eSpark-Consulting-Group/ajeet-singh-hdmi-to-fpc-adaptor/Docs/HDMI-PI-main(Ref Design)/4.Docs/东芝方案/TC358870XBG资料/代码生成配置脚本.xlsm

Sheet: Revison
Revison | HowToUse |  | Main_Parameters |  | EDID |  | Source_Startup |  | Source_CabCnct |  | Source_ColorBar |  | Source_HDMITimChk |  | Code
 | Rev | Note | Rev | Note | Rev | Note | Rev | Note | Rev | Note | Rev | Note | Rev | Note | Rev | Note
Tv01 | v01 | 1st Edition | v01 | 1st Edition | v01 | 1st Edition | v01 | 1st Edition |  |  |  |  |  |  | v01 | 1st Edition
Tv02 | v02 | Modify 4.5 |  |  | v02 | Modify K column judgement | v02 | Modify delay command expression.
 |  |  |  |  |  | Add conditional cell color painting to J column
Tv03 |  |  | v02 | Modify D22, H22 Formulas |  |  | v03 | Delete line 374,375
 |  |  |  | Modify D21, H21
 |  |  |  | Modify D59~D64,E59~E64,P59~P64,Q59~Q64
Tv04 | v03 | Add explanation of Color Bar. | v03 | Add B115, M115 | v03 | Add formula to support new resolution | v04 | Move 0x02A0,0x02AC,0x04A0,0x04AC setting earlier |  |  | v01 | 1st Edition | v01 | 1st Edition
 |  | Modify Typo. |  | Modify B114, M114 |  |  |  | Move 0x0110,0x0310 to command TX part.
 |  |  |  | Modify D62~D63,E62~E63,P62~P63,Q62~Q63 |  |  |  | Modiy 0x0128,0x0328 bit set part.
 |  |  |  | Add G64,S64 |  |  |  | Modify CMD part of 0x8671 and 0x8675
 |  |  |  | Change to fixed value (C60,O60)
 |  |  |  | Add new resolution to B20, S3~S10
 |  |  |  | Modify formula for 0x0370
Tv05 |  |  | v04 | Modify calculation formula for 0x0170 and 0x0370. |  |  | v05 | Modify 0x021C,0x041C setting. |  |  | v02 | Change reference point of 0x0170 and 0x0370.
 |  |  |  | Use different value for 0x0170,0x0370 between HDMI input and Color Bar. |  |  |  | Change DDC_5V interrupt related part. |  |  |  | Modify 0x021C,0x041C setting.
Tv06 | v04 | Add explanation of "Source_HDMITimChk" sheet. |  |  |  |  | v06 | Change 0x0128,0x0328 value | v01 | 1st Edition | v03 | Change 0x0128,0x0328 value
 |  |  |  |  |  |  |  | Change to fixed value for 0x0128,0x0328<bit1> |  |  |  | Change to fixed value for 0x0128,0x0328<bit1>
 |  |  |  |  |  |  |  | Change 0x8410 value
Tv07 | v05 | Modify cell number related with Signal Soure setting. | v05 | Move Signal Source input cell and color bar kind input cell position. |  |  | v07 | Delete 0x5008,0x5088 setting | v02 | Add sequence. Add flow chart |  |  | v02 | Add HDMI VSYNC,HSYNC polarity status | v02 | Macro names are changed.
 |  |  |  | Delete M25
 |  |  |  | Add conditonal cell color change to M23,M24.

Sheet: HowToUse
 | v05
<HDMI Input>
1 | Select "Main_Parameters" sheet.
2 | Fill parameters to yellow colored cells
 | 2-1 | Select DSI output source by C29. Select "HDMI".
 | 2-2 | Fill HDMI related paramters at "HDMI Input" part.
 |  | 2-1-1 | HDMI input timing can be selected by cell B20. If other timings which are not listed in the cell is needed, select "Original" and fill timigns to cell C19~K19,L20,L21,M23,M24,M25.
 | 2-3 | Select "DSI Output Format" by C45. Select DSI mode by D45.
 | 2-4 | Set split mode.
 |  | 2-4-1 | Split mode "enable"/"disable" is set by F40 and H40 for DSI-TX0 and DSI-TX1 each. When "disabled", HDMI input goes to both DSI-TX0 and DSI-TX1 without splitting.
 |  | 2-4-2 | Split mode is set by C42. "Half(Auto)" mode will divide H active pixel from HDMI into half automatically and input to DSI-TX0 and DSI-TX1 each. When "Manual" mode is selected by C42, H active pixel for DSI-TX0 is set by E42 and E45. G42 and G45 are used to set H active pixel for DSI-TX1. 1st pixel of HDMI is pixel "1". H active pixel for DSI-TX0 and DSI-TX1 is shown in E47 and G47 each. For both "Half(Auto)" and "Manual" mode, dummy pixels can be added at the begingig and at the end of active pixel. Dummy pixel for DSI-TX0 is set by F42 and F45 and by H42 and H45 for DSI-TX1. Pixels including dummy pixels need to be sent through DSI-TX0 and DSI-TX1 are shown in F47 and H47 each.
 | 2-5 | Fill "DSI Output Detail Timing" part
 |  | 2-5-1 | Different timing parameters can be set for DSI-TX0 and DSI-TX1. If same timing parameters is OK and the timing can meet timing requirement, set O50 as "Same as TX0". For this case, same parameters are used for DSI-TX0 and DSI-TX1. Only setting parameters to DSI-TX0 side is OK. If different timing parameters are required, DSI-TX1 side parameters must be set independently. Following explanation assumes a case that same timing parameters are used.
 |  | 2-5-2 | Set REFCLK frequency to C72 and set DSI lane to C78.
 |  | 2-5-3 | Suitable DSI speed is listed in J79,J80. Please adjust DSI speed referring to these values. J79:reference DSI speed when keeping same HPW+HBP time period as HDMI input. J80:reference DSI speed when no HPW+HBP time period is inserted. To get DSI speed frequency, set Pre Divider value which decides unit clock (E74). Lower frequency is better. Pre divided value (I73) should be within spec(min)(J73) and spec(max)(K73). Select DSI speed range (C74) according to J79 and J80. DSI speed is calculated by Unit Clock(E74) * Multiply value(C75). DSI speed should be within spec(min)(J77) and spec(max)(K77). Adjust LP<->HS transition time paramters (C85~C105) for Judge column (E*) to be "OK". As paramters at C column increase, calculated value (I column) will also increasae. When the calculated value becomes within spec (J column and H column), judge (E column) will be "OK". For C column parameters, please select relatively small value which can be "OK".
 |  | 2-5-4 | Horizontal related porch timing on DSI is set by D60,D61,E60,D61 for DSI-TX0 and P60,P61,Q60,Q61 for DSI-TX1. When DSI output is Sync Event Mode, only E60,E61 and Q60,Q61 are used and all is used for Sync Pulse Mode. E60(Q60) are used to set porch setting mode for Sync Event Mode and D60,E60(P60,Q60) are used to set porch setting mode for Sync Pulse Mode. "Follow input" means that corresponding porch time period of DSI becomes almost the same as HDMI input porch timing. By using "Set", user can set porch value (HPW+HBP) on DSI side freely. Porch value is set by E61(Q61) for Sync Event Mode (HPW+HBP), set by D61,E61(P61,Q61) for Sync Pulse Mode(HPW, HBP). Recommended mode is "Set". Porch time period in "ns" unit is shown in E63(Q63) for Sync Event Mode (HPW+HBP),shown in D63,E63(P63,Q63) for Sync Pulse Mode(HPW, HBP). Also shown in "ByteClock" unit below "ns" unit. Please adjust porch value referring to these time.
 |  | 2-5-5 | When G63(S63) is "NG", DSI cannot output all the data within 1line. Please adjust parameters according to ERROR message shown in B4~B9.
 | 2-6 | Fill Audio Related parameters according to required configuration. (Columns M,N,O, Row 2~6).
 | 2-7 | Fill EDID related parameters according to capability of receivable resolution/frame rate/Timng. EDID data includes 1st and 2nd descriptors for recommended display timing. Extra descriptors 3rd ~ 7th are enabled by R5. There are 2 ways of setting for EDID. One is to select from predefiend value. another is setting by user. By setting S3~S10, user can select which method to use. When "Original" is selected, timing parameters set into C20~K20,L21,M23,M24 are used as EDID data. When "New" is selected, timing data written into corresponding cells in "EDID" sheet is used as EDID data.
 | 2-8 | Select "EDID" sheet. Fill EDID data in yellow colored cells if needed.
3 | Select "Source_*" sheet. Fill orange colored cells if needed.
4 | Command transmission to DSI-RX should be filled in "Command Transmission Before Video Start" and/or "Command Transmission After Video Start.
5 | Setting seuqnece is automatically calculated and listed in B, D, E columns at "Source_*" sheet. C column is Command. D column is Address, E column is Data.
<Embedded Color Bar Output>
1 | Select "Main_Parameters" sheet.
2 | Fill parameters to yellow colored cells
 | 2-1 | Select DSI output source by C29. Select "Color Bar". Color Bar mode can be set by D29.
 | 2-2 | Fill Color Bar size related paramters using "HDMI Input" part.
 |  | 2-1-1 | Color Bar size and timing can be selected by cell B20. If other timings which are not listed in the cell is needed, select "Original" and fill timigns to cell C19~K19. For Color Bar case, maximum PCLK(C20) frequency is limited by DSI-TX0 speed. PCLK(C20) <= 2* DSI-TX0 ByteClock(C82).
 | 2-3 | Select "DSI Output Format" by C45. Select DSI mode by D45.
 | 2-4 | Set split mode.
 |  | 2-4-1 | Split mode "enable"/"disable" is set by F40 and H40 for DSI-TX0 and DSI-TX1 each. When "disabled", HDMI input goes to both DSI-TX0 and DSI-TX1 without splitting.
 |  | 2-4-2 | Split mode is set by C42. "Half(Auto)" mode will divide H active pixel from HDMI into half automatically and input to DSI-TX0 and DSI-TX1 each. When "Manual" mode is selected by C42, H active pixel for DSI-TX0 is set by E42 and E45. G42 and G45 are used to set H active pixel for DSI-TX1. 1st pixel of HDMI is pixel "1". H active pixel for DSI-TX0 and DSI-TX1 is shown in E47 and G47 each. For both "Half(Auto)" and "Manual" mode, dummy pixels can be added at the begingig and at the end of active pixel. Dummy pixel for DSI-TX0 is set by F42 and F45 and by H42 and H45 for DSI-TX1. Pixels including dummy pixels need to be sent through DSI-TX0 and DSI-TX1 are shown in F47 and H47 each.
 | 2-5 | Fill "DSI Output Detail Timing" part
 |  | 2-5-1 | Different timing parameters can be set for DSI-TX0 and DSI-TX1. If same timing parameters is OK and the timing can meet timing requirement, set O50 as "Same as TX0". For this case, same parameters are used for DSI-TX0 and DSI-TX1. Only setting parameters to DSI-TX0 side is OK. If different timing parameters are required, DSI-TX1 side parameters must be set independently. Following explanation assumes a case that same timing parameters are used.
 |  | 2-5-2 | Set REFCLK frequency to C72 and set DSI lane to C78.
 |  | 2-5-3 | Suitable DSI speed is listed in J79,J80. Please adjust DSI speed referring to these values. J79:reference DSI speed when keeping same HPW+HBP time period as HDMI input. J80:reference DSI speed when no HPW+HBP time period is inserted. To get DSI speed frequency, set Pre Divider value which decides unit clock (E74). Lower frequency is better. Pre divided value (I73) should be within spec(min)(J73) and spec(max)(K73). Select DSI speed range (C74) according to J79 and J80. DSI speed is calculated by Unit Clock(E74) * Multiply value(C75). DSI speed should be within spec(min)(J77) and spec(max)(K77). Adjust LP<->HS transition time paramters (C85~C105) for Judge column (E*) to be "OK". As paramters at C column increase, calculated value (I column) will also increasae. When the calculated value becomes within spec (J column and H column), judge (E column) will be "OK". For C column parameters, please select relatively small value which can be "OK".
 |  | 2-5-4 | Horizontal related porch timing on DSI is set by D60,D61,E60,D61 for DSI-TX0 and P60,P61,Q60,Q61 for DSI-TX1. When DSI output is Sync Event Mode, only E60,E61 and Q60,Q61 are used and all is used for Sync Pulse Mode. E60(Q60) are used to set porch setting mode for Sync Event Mode and D60,E60(P60,Q60) are used to set porch setting mode for Sync Pulse Mode. "Follow input" means that corresponding porch time period of DSI becomes almost the same as HDMI input porch timing. By using "Set", user can set porch value (HPW+HBP) on DSI side freely. Porch value is set by E61(Q61) for Sync Event Mode (HPW+HBP), set by D61,E61(P61,Q61) for Sync Pulse Mode(HPW, HBP). Recommended mode is "Set". Porch time period in "ns" unit is shown in E63(Q63) for Sync Event Mode (HPW+HBP),shown in D63,E63(P63,Q63) for Sync Pulse Mode(HPW, HBP). Also shown in "ByteClock" unit below "ns" unit. Please adjust porch value referring to these time.
 |  | 2-5-5 | When G63(S63) is "NG", DSI cannot output all the data within 1line. Please adjust parameters according to ERROR message shown in B4~B9.
3 | Select "Source_ColorBar" sheet. Fill orange colored cells if needed.
4 | Command transmission to DSI-RX should be filled in "Command Transmission Before Video Start" and/or "Command Transmission After Video Start. "LP" or "HS" is decided by MODE_CONFIG Register bit4. Before command transmission, please set this bit to select "LP" or "HS".
5 | Setting seuqnece is automatically calculated and listed on B, D, E columns at "Source_ColorBar" sheet. "EDID" part, "LP Command" part and "HS Command" part are folded. C column is Command. D column is Address, E column is Data.
<Read HDMI Timing>
1 | TC358870XBG has a function to read inputted HDMI timing.
2 | "Source_HDMITimChk" sheet is used for this function.
 | 2-1 | Select "Source_HDMITimChk" sheet.
 | 2-2 | Execute sequnece listed in the sheet.
 | 2-4 | Fill read out value by the sequence to yellow colored cells.
 | 2-5 | HDMI signal timing inputted to TC358770XBG will be shown in H column.

Sheet: Main_Parameters
TOSHIBA Confidential |  | v05 | Title | 2560x1600 DSI 4lanex2link 30fps HDMI Input
 |  |  |  |  |  |  |  |  |  |  |  | Audio Related |  |  |  | EDID Related
 | <Error Message> |  |  |  |  |  |  |  |  |  |  | Audio Out | Aud CH Sel | Audio CH |  | 1st Descriptor |  | 2560x1600p60Hz (76) |  | 0
 |  |  |  |  |  |  |  |  |  |  |  | I2S | Auto | 2 |  | 2nd Descriptor |  | 2560x1600p60Hz (76) |  | 0
 |  |  |  |  |  |  |  |  |  |  |  |  | I2S/TDM dly | Audio BitClk |  | Extended Inf | Enable
 |  |  |  |  |  |  |  |  |  |  |  |  | No Delay | Free Run |  | 3rd Descriptor |  | 2560x1600p60Hz (76) |  | 0
 |  |  |  |  |  |  |  |  |  |  |  |  |  |  |  | 4th Descriptor |  | 2560x1600p60Hz (76) |  | 0
 |  |  |  |  |  |  |  |  |  |  |  |  | I2C Auto Inc | Auto Inc |  | 5th Descriptor |  | 2560x1600p60Hz (76) |  | 0
 |  |  |  |  |  |  |  |  |  |  |  |  |  |  |  | 6th Descriptor |  | 2560x1600p60Hz (76) |  | 0
 |  | 268.6 | 32 | 80 | 2560 | 48 | 6 | 37 | 1600 | 3 |  |  |  |  |  | 7th Descriptor |  | 2560x1600p60Hz (76) |  | 0
 | HDMI Input
 |  | PCLK | HPW | HBPR | Hactive | HFPR | VSW | VBPR | Vactive | VFPR |  | Common Timing
 | Timing Select | (MHz) | (PCLK) | (PCLK) | (PCLK) | (PCLK) | (line) | (line) | (line) | (line) | Format |  | Htotal | Vtotal
 | Original Timing Input -> | 134 | 32 | 80 | 2560 | 48 | 6 | 37 | 1600 | 3 |  | fps | (us) | (ms)
 | 2560x1600p60Hz (76) | 268.6 | 32 | 80 | 2560 | 48 | 6 | 37 | 1600 | 3 | RGB888 | 59.99 | 10.127 | 16.668
 |  | <=297MHz(HDMI) | HSW+HBP>=8 | HSW+HBP>=8 | 1-4096 |  | 2-1023 | 1-1023 | 1-4096 |  | Progressive | Progressive
 |  | <=2*TX0ByteClk(CB) | OK | OK | OK |  | OK | OK | OK |  | HDCP Disable
 |  | OK | 119.136 | 297.841 | 9.531 | 178.704 |  |  |  |  | HSYNC Pol | L Active | 1
 |  |  | ns | ns | us | ns |  |  |  |  | VSYNC Pol | L Active | 1
 | Signal Source | HDMI | Bar | 4
 |  |  |  | TX0 Splitter-> | Enable | TX1 Splitter-> | Enable | Interlace VID | Interlace VID
 | DSI Mode | Splitter Mode | 1st Pixel to | TX0 Output Start Pixel | TX0 Dmy Pix (Start) | TX1 Output Start Pixel | TX1 Dmy Pix (Start) | for Top (Hex 2digit) | for Bottom (Hex 2digit)
 | Format | Half(Auto) | DSI0 | 1 | 0 | 1281 | 0 | 10 | A0
 | Splitter | 1 | 0 | Don't Care |  | Don't Care |  | 10 | A0
 |  | DSI Output Format | DSI Sync Mode | TX0 Output End Pixel | TX0 Dmy Pix (End) | TX1 Output End Pixel | TX1 Dmy Pix (End)
 |  | RGB888 | SyncEvent | 1280 | 0 | 2560 | 0
 | 24 |  | MSF | Don't Care | TX0 Trf Pix | Don't Care | TX1 Trf Pix
 | 0 |  | Disable | - | 1280 | - | 1280
 | 0
 | 0
 | DSI-TX0 Output |  |  |  |  |  |  |  |  |  |  | Parameter Select-> |  | Same as TX0 | DSI-TX1 Outout
 | Timing | HPW+HBP by | - | HPW+HBP |  |  |  |  |  |  |  | Timing |  | HPW+HBP by | - | HPW+HBP
 |  | HS | Set | Set | H Active | HFP left | V Active | V Blank |  |  |  |  |  | HS | Set | Set | H Active | HFP left | V Active | V Blank
 |  | Mbps/lane | 1 | 260 | (us) | (us) | (ms) | (ms) |  |  |  |  |  | Mbps/lane | 1 | 260 | (us) | (us) | (ms) | (ms)
 |  | 912.00 | 1 | 260 | 8.421 | 1.135 | 16.203 | 0.466 |  |  |  |  |  | 912.00 | 1 | 260 | 8.421 | 1.135 | 16.203 | 0.466
 |  | Time(ns)-> | - | 570.1754386 |  | OK |  |  |  |  |  |  |  | Time(ns)-> | - | 570.1754386 |  | OK
 |  | Time(ByteClk)-> | - | 65 |  | 129.4 |  |  |  |  |  |  |  | Time(ByteClk)-> | - | 65 |  | 129.4
 | DSI Output Detail Timing |  |  |  |  |  |  | Value | Sepc min | Spec max |  |  |  |  |  |  |  |  |  | Value | Sepc min | Spec max
 | REFCLK | 48 | MHz | OK | REFCK(MHz) |  |  | 48 | 40 | 50 |  | REFCLK |  | 48.00 | MHz | OK | REFCK(MHz) |  |  | 48 | 40 | 50
 | Pre Divider value | 10 | 1-16 | OK | PLL input clock(MHz) |  |  | 4.8 | 4 | 40 |  | Pre Divider value |  | 10 | 1-16 | OK | PLL input clock(MHz) |  |  | 4.8 | 4 | 40
 | DSI speed range(Mbps) | 500M-1G | Unit Clock | 4.8 | MHz |  |  |  |  |  |  | DSI speed range(Mbps) |  | 500M-1G | Unit Clock | 4.8 | MHz
 | Multiply value of Unit Clock | 190 | 1-511 |  | Multiply Vaue |  |  |  | 0 | 511 |  | Multiply value of Unit Clock |  | 180 | 1-511 |  | Multiply Vaue |  |  |  | 0 | 511
 |  |  |  |  | FRS,PRD,FBD-> |  |  | 0 | 9 | 189 |  |  |  |  |  |  | FRS,PRD,FBD-> |  |  | 0 | 9 | 189
 | DSI speed/lane | 912 | Mbps/lane | OK | DSI speed (Mbps/lane) |  |  | 912 | 75.00 | 1000 |  | DSI speed/lane |  | 912 | Mbps/lane | OK | DSI speed (Mbps/lane) |  |  | 912 | 75.00 | 1000
 | DSI lane | 4 | lane | 4 | Suitable DSI speed(Mbps/lane) |  |  |  |  |  | 4 | DSI lane |  | 4 | lane | 4 | Suitable DSI speed(Mbps/lane)
 | Add EOT | No | 1 |  |  |  |  | HPW+HBP | 843.55 | 843.5535296 |  | Add EOT |  | Yes | 1 |  |  |  |  | HPW+HBP | 843.55 | 843.5535296
 | DSI clock enable during LP | Enable |  |  |  |  |  | Min | 809.59 | 809.594419 |  | DSI clock enable during LP |  | Enable | Enable |  |  |  |  | Min | 809.59 | 809.594419
 |  |  |  |  |  |  |  | Value | Sepc min | Spec max |  | Insertion of LP between PKT |  | Disable |  |  |  |  |  | Value | Sepc min | Spec max
 | HS Byte Clock | 114 | MHz | OK | SYSCLK Freq(MHz) |  |  | 114 |  | 125 |  | HS Byte Clock |  | 114 | MHz | OK | SYSCLK Freq(MHz) |  |  | 114 |  | 125
 | LPTX of SLAVE | 50 | ns | OK |  |  |  | 50 | 50 |  |  | LPTX of SLAVE |  | 50.00 | ns | OK |  |  |  | 50 | 50
 | Line Init Control |  |  |  | Line Init Control(us) |  |  | Value | Sepc min | Spec max |  | Line Init Control |  |  |  |  | Line Init Control(us) |  |  | Value | Sepc min | Spec max
 | REG[0120h]bit[15:0] | 6000 | 0-65535 | OK |  |  |  | 105.26 | 100.00 |  |  | REG[0310h]bit[15:0] |  | 6000 | 0-65535 | OK |  |  |  | 105.26 | 100.00
 | LPTXTIMECNT |  |  | OK | TLPX(Master)/TLPX(SLAVE) |  |  | Value | Sepc min | Spec max |  | TLPTXTIMECNT |  |  |  | OK | TLPX(Master)/TLPX(SLAVE) |  |  | Value | Sepc min | Spec max
 | REG[0254h]bit[11:0] | 6 | 1-2047 | OK | TLPX(ns) |  |  | 61.40 | 50.00 |  |  | REG[0454h]bit[11:0] |  | 5 | 1-2047 | OK | TLPX(ns) |  |  | 61.40 | 50.00
 | TCLK_HEADERCNT |  |  |  | TCLK-PREPARE(ns) |  |  | Value | Sepc min | Spec max |  | TCLK_HEADERCNT |  |  |  |  | TCLK-PREPARE(ns) |  |  | Value | Sepc min | Spec max
 | REG[0258h]bit[6:0] | 4 | 0-127 | OK |  |  |  | 43.86 | 38.00 | 95.00 |  | REG[0458h]bit[6:0] |  | 4 | 0-127 | OK |  |  |  | 43.86 | 38.00 | 95.00
 | TCLK_HEADERCNT |  |  |  | TCLK-PREPARE+ |  |  | Value | Sepc min | Spec max |  | TCLK_HEADERCNT |  |  |  |  | TCLK-PREPARE+ |  |  | Value | Sepc min | Spec max
 | REG[0258h]bit[23:16] | 36 | 0-255 | OK | TCLK-ZERO(ns) |  |  | 315.79 | 300.00 |  |  | REG[0458h]bit[23:16] |  | 36 | 0-255 | OK | TCLK-ZERO(ns) |  |  | 315.79 | 300.00
 | TCLK_HEADERCNT |  |  |  | TCLK-Pre(ns) |  |  | Value | Sepc min | Spec max |  | TCLK_HEADERCNT |  |  |  |  | TCLK-Pre(ns) |  |  | Value | Sepc min | Spec max
 | REG[0258h]bit[13:8] | 2 | 0-63 | Don't care |  |  |  | 17.54 | 8.77 |  |  | REG[0458h]bit[13:8] |  | 3 | 0-63 | Don't care |  |  |  | 17.54 | 8.77
 | TCLKTRAILCNT |  |  |  | TCLK-TRAIL(ns) |  |  | Value | Sepc min | Spec max |  | TCLKTRAILCNT |  |  |  |  | TCLK-TRAIL(ns) |  |  | Value | Sepc min | Spec max
 | REG[025Ch]bit[7:0] | 8 | 0-255 | Don't care |  |  |  | 70.18 | 60.00 | 118.16 |  | REG[045Ch]bit[7:0] |  | 10 | 0-255 | Don't care |  |  |  | 70.18 | 60.00 | 118.16
 | TCLKTRAILCNT |  |  |  | TCLK-EXIT(ns) |  |  | Value | Sepc min | Spec max |  | TCLKTRAILCNT |  |  |  |  | TCLK-EXIT(ns) |  |  | Value | Sepc min | Spec max
 | REG[025Ch]bit[26:16] | 13 | 0-255 | Don't care |  |  |  | 114.04 | 100.00 |  |  | REG[045Ch]bit[26:16] |  | 20 | 0-255 | Don't care |  |  |  | 114.04 | 100.00
 | THS_HEADERCNT |  |  |  | THS-PREPARE(ns) |  |  | Value | Sepc min | Spec max |  | THS_HEADERCNT |  |  |  |  | THS-PREPARE(ns) |  |  | Value | Sepc min | Spec max
 | REG[0260h]bit[6:0] | 6 | 0-127 | OK |  |  |  | 52.63 | 44.39 | 91.58 |  | REG[0460h]bit[6:0] |  | 6 | 0-127 | OK |  |  |  | 52.63 | 44.39 | 91.58
 | THS_HEADERCNT |  |  |  | THS-PREPARE+ |  |  | Value | Sepc min | Spec max |  | THS_HEADERCNT |  |  |  |  | THS-PREPARE+ |  |  | Value | Sepc min | Spec max
 | REG[0260h]bit[23:16] | 20 | 0-127 | OK | THS-ZERO(ns) |  |  | 175.44 | 155.96 |  |  | REG[0460h]bit[23:16] |  | 20 | 0-127 | OK | THS-ZERO(ns) |  |  | 175.44 | 155.96
 | TWAKEUPCNT |  |  |  | TWAKEUP(ms) |  |  | Value | Sepc min | Spec max |  | TWAKEUPCNT |  |  |  |  | TWAKEUP(ms) |  |  | Value | Sepc min | Spec max
 | REG[0264h]bit[15:0] | 17000 | 0-65535 | OK |  |  |  | 1.04 | 1.00 |  |  | REG[0464h]bit[15:0] |  | 20000 | 0-65535 | OK |  |  |  | 1.04 | 1.00
 | TCLKPOSTCNT |  |  |  | TCLK-POST(ns) |  |  | Value | Sepc min | Spec max |  | TCLKPOSTCNT |  |  |  |  | TCLK-POST(ns) |  |  | Value | Sepc min | Spec max
 | REG[0268h]bit[10:0] | 15 | 0-2047 | Don't care |  |  |  | 131.58 | 117.02 |  |  | REG[0468h]bit[10:0] |  | 14 | 0-2047 | Don't care |  |  |  | 131.58 | 117.02
 | THSTRAILCNT |  |  |  | THS-TRAIL(ns) |  |  | Value | Sepc min | Spec max |  | THSTRAILCNT |  |  |  |  | THS-TRAIL(ns) |  |  | Value | Sepc min | Spec max
 | REG[026Ch]bit[7:0] | 8 | 0-15 | OK |  |  |  | 70.18 | 64.39 | 88.16 |  | REG[046Ch]bit[7:0] |  | 8 | 0-15 | OK |  |  |  | 70.18 | 64.39 | 88.16
 | THSTRAILCNT |  |  |  | THS-EXIT(ns) |  |  | Value | Sepc min | Spec max |  | THSTRAILCNT |  |  |  |  | THS-EXIT(ns) |  |  | Value | Sepc min | Spec max
 | REG[026Ch]bit[26:16] | 13 | 0-15 | OK |  |  |  | 114.04 | 100.00 |  |  | REG[046Ch]bit[26:16] |  | 12 | 0-15 | OK |  |  |  | 114.04 | 100.00
 | BTA_COUNT |  |  |  | RX-TA-SURE(ns) |  |  | 61.40 | Sepc min | Spec max |  | BTA_COUNT |  |  |  |  | RX-TA-SURE(ns) |  |  | 61.40 | Sepc min | Spec max
 | REG[0278h]bit[10:0] | 5 | 0-2047 | OK |  |  |  | 70.18 | 61.40 | 122.81 |  | REG[0478h]bit[10:0] |  | 4 | 0-2047 | OK |  |  |  | 70.18 | 61.40 | 122.81
 | BTA_COUNT |  |  |  | TX-TA-GO(ns) |  |  | Value | Sepc min | Spec max |  | BTA_COUNT |  |  |  |  | TX-TA-GO(ns) |  |  | Value | Sepc min | Spec max
 | REG[0278h]bit[26:16] | 6 | 0-2047 |  |  |  |  | 245.61 | 245.61 | 245.61 |  | REG[0478h]bit[26:16] |  | 6 | 0-2047 |  |  |  |  | 245.61 | 245.61 | 245.61
 | 605.2631579 | <= DSI:HS->LP->HS time (ns) |  |  |  |  |  |  |  |  |  | 605.2631579 |  | <= DSI:HS->LP->HS time (ns)
 | 421.0526316 | <= DSI:HS->LP->HS(short) time (ns) |  |  |  |  |  |  |  |  |  | 421.0526316 |  | <= DSI:HS->LP->HS(short) time (ns)

Sheet: Source_Startup
TC358870XBG HDMI Input Start Up sequence |  |  |  |  | v07 | Title
Command Description WR8:8bit Write, WR16:16bit Write, WR32:32bit Write, RD8:8bit Read, RD16:16bit Read, RD32:32bit Read |  |  |  |  |  | TOSHIBA Confidential
Command Description delay:Wait (unit is "us"), REM/REMnd: Remark. For delay command, Wait value must be written into address column.
Initialization
CMD | Register Name | Address | Data | Comment
REM | Software Reset
WR16 | ConfCtl0 | 0004 | 0004
WR16 | SysCtl | 0002 | 3F01 | Assert Reset, Exit Sleep, wait
WR16 | SysCtl | 0002 | 0000 | Release Reset, Exit Sleep
WR16 | ConfCtl1 | 0006 | 0008
REM | DSI-TX0 Transition Timing
WR32 | DSI_TX_CLKEN | 0108 | 00000001
WR32 | DSI_TX_CLKSEL | 010C | 00000001 |  |  |  |  |  |  | SYSDTclk[11:10] | HSCK/8 | SYSCLclk[9:8] | HSCK/8 |  |  |  |  |  |  | HSTXclk_enb[0] | Enable
WR32 | MIPI_PLL_CONTROL | 02A0 | 00000001
WR32 | MIPI_PLL_CNF | 02AC | 000090BD | Program PLL for DSI-TX0
delay |  | 1000
WR32 | MIPI_PLL_CONTROL | 02A0 | 00000003
WR32 | LANE_ENABLE | 0118 | 00000014
WR32 | LINE_INIT_COUNT | 0120 | 00001770
WR32 | HSTX_TO_COUNT | 0124 | 00000000 |  |  | HSTX TO Count (Hex 0x0~0xFFFFFFFF) |  |  | 0 | OK
WR32 | FUNC_ENABLE | 0128 | 00000101 |  |  |  |  |  |  | INIT Int Dis | ApErrInt Dis | DSIPrto Inte Dis | DSIrErr Int Dis | DSILPTX Int Dis | DSIrTrg Int Dis | DSIrStat Int Dis | PR_TO Dis | HSTX_TO Dis | IND_TO Dis | INDMdSel Reg | VHDELAY Reg
REMnd | DSI_LPTX_MODE | 012C | 00000000 |  |  |  |  |  |  |  |  |  |  |  | Specified Line Number(0~8191) | OK | 0 | Output Tim[2:1] | VFP | Cmd from[0] | Input
WR32 | DSI_TATO_COUNT | 0130 | 00010000 |  |  | TA TO Count (Hex 0x0~0xFFFFFFFF) |  |  | 10000 | OK
WR32 | DSI_PRESP_BTA_COUNT | 0134 | 00005000 |  |  | DSI_RRESP_BTA Count (Hex 0x0~0xFFFFFFFF) |  |  | 5000 | OK
WR32 | DSI_PRESP_LPR_COUNT | 0138 | 00010000 |  |  | DSI_PRESP_LPR Count (Hex 0x0~0xFFFFFFFF) |  |  | 10000 | OK
WR32 | DSI_PRESP_LPW_COUNT | 013C | 00010000 |  |  | DSI_PRESP_LPW Count (Hex 0x0~0xFFFFFFFF) |  |  | 10000 | OK
WR32 | DSI_PRESP_HSR_COUNT | 0140 | 00010000 |  |  | DSI_PRESP_HSR Count (Hex 0x0~0xFFFFFFFF) |  |  | 10000 | OK
WR32 | DSI_PRESP_HSW_COUNT | 0144 | 00010000 |  |  | DSI_PRESP_HSW Count (Hex 0x0~0xFFFFFFFF) |  |  | 10000 | OK
WR32 | DSI_PR_TO_COUNT | 0148 | 00001000 |  |  | DSI_PR_TO Count (Hex 0x0~0xFFFFFFFF) |  |  | 1000 | OK
WR32 | DSI_LRX-H_TO_COUNT | 014C | 00010000 |  |  | DSI_LRX-H TO Count (Hex 0x0~0xFFFFFFFF) |  |  | 10000 | OK
WR32 | FUNC_MODE | 0150 | 00000160 |  |  |  |  |  |  | Clk Force Stop[10] | Keep Operation | Contension Chk[9] | Enable | ECC Err Chk[8] | Disable | CRC Err Chk[6] | Disable | HS clk Md[5] | Continuous | Add EoT[0] | No
WR32 | DSI_RX_VC_ENABLE | 0154 | 00000001 |  |  |  |  |  |  |  |  |  |  | Receive VC3[3] | Disable | Receive VC0[2] | Disable | Receive VC0[1] | Disable | Receive VC0[0] | Enable
WR32 | IND_TO_COUNT | 0158 | 000000C8 |  |  | IND TO Count (Hex 0x0~0xFFFFFFFF) |  |  | C8 | OK
REMnd | INIT_INT_MSK | 0164 | 00000014 |  |  |  |  |  |  |  |  |  |  |  |  | LPRX Cal Done[2] | Mask | VREG Cnt Done[1] | Mask | Line Init Done[0] | No Mask
WR32 | DSI_HSYNC_STOP_COUNT | 0168 | 0000002A |  |  | DSI_HSYNC STOP Count (Hex 0x0~0xFFFF) |  |  | 002A | OK
WR32 | APF_VDELAYCNT | 0170 | 00000478
REMnd | APF_VC_CONFIG | 0178 | 00000001 |  |  |  |  |  |  |  |  |  |  |  |  |  |  | VC Setting[2:1] | 0 | VC Select[0] | By Reg
WR32 | DSI_TX_MODE | 017C | 00000081
WR32 | DSI_HSYNC_WIDTH | 018C | 00000001
WR32 | DSI_HBPR | 0190 | 00000104
WR32 | DSI_RX_STATE_INT_MASK | 01A4 | 00000000 |  |  |  |  |  |  |  |  | LPRX Pkt Start[4] | No Mask | LPRX Pkt Done[3] | No Mask | LPRX Th Hit[2] | No Mask | Direction Fall[1] | No Mask | Direction Rise[0] | No Mask
REMnd | DSI_RXTRG_INT_MASK | 01AC | 00000000 |  |  |  |  |  |  |  |  |  |  | L0RX Trg3[3] | No Mask | L0RX Trg2[2] | No Mask | L0RX Trg1[1] | No Mask | L0RX Trg0[0] | No Mask
WR32 | DSI_LPRX_THRESH_COUNT | 01C0 | 00000015 |  |  | DSI_LPRX Threshold Count (Hex 0x0~0x1F) |  |  | 15 | OK
REMnd | DSI_PRTO_INT_MASK | 020C | 00000000 |  |  |  |  |  |  |  |  |  |  | Peri Resp TO[3] | No Mask |  |  | HSTX TO[1] | No Mask
WR32 | APP_SIDE_ERR_INT_MASK | 0214 | 00000000 |  |  | Ind Wrong Err[9] | No Mask | Line Buf RW Err[8] | No Mask | RX Buf OVF[6] | No Mask | Sync Buf OVF[4] | No Mask | Ind Buf OVF[3] | No Mask | Line Buf OVF[2] | No Mask | Err WC[1] | No Mask | Err Data Type[0] | No Mask
WR32 | DSI_RX_ERR_INT_MASK | 021C | 00000080 |  |  | Err Report Mask[13:3] |  | No Mask | No Mask | No Mask | No Mask | No Mask | No Mask | Mask | No Mask |  | No Mask | No Mask
WR32 | DSI_LPTX_INT_MASK | 0224 | 00000000 |  |  |  |  |  |  | Payload1 Done[9] | No Mask | Payload0 Done[8] | No Mask |  |  |  |  |  |  | LPTX Done[0] | No Mask
REMnd | DPHY_DLYCNTRL | 0240 | 00000000 |  |  |  |  |  |  |  |  | DLY Sel CL[19:16] | 0 | DLY Sel D3[15:12] | 0 | DLY Sel D2[11:8] | 0 | DLY Sel D1[7:4] | 0 | DLY Sel D0[3:0] | 0
WR32 | LPTXTIMECNT | 0254 | 00000006
WR32 | TCLK_HEADERCNT | 0258 | 00240204
WR32 | TCLK_TRAILCNT | 025C | 000D0008
WR32 | THS_HEADERCNT | 0260 | 00140006
WR32 | TWAKEUPCNT | 0264 | 00004268
WR32 | TCLK_POSTCNT | 0268 | 0000000F
WR32 | THS_TRAILCNT | 026C | 000D0008
WR32 | HSTXVREGCNT | 0270 | 00000020
WR32 | HSTXVREGEN | 0274 | 0000001F
WR32 | BTA_COUNT | 0278 | 00060005
WR32 | DPHY_TX ADJUST | 027C | 00000002 |  |  |  |  |  |  |  |  | CLLPTX Cur[9:8] | No Add | D3LPTX Cur[7:6] | No Add | D2LPTX Cur[5:4] | No Add | D1LPTX Cur[3:2] | No Add | D0LPTX Cur[1:0] | 25% Add
REMnd | DPHY_CAP | 0288 | 000002AA |  |  |  |  |  |  |  |  | CAP Sel CL[9:8] | 2 | CAP Sel D3[7:6] | 2 | CAP Sel D2[5:4] | 2 | CAP Sel D1[3:2] | 2 | CAP Sel D0[1:0] | 2
WR32 | DSITX_START | 011C | 00000001
REM | DSI-TX1 Transition Timing
WR32 | DSI_TX_CLKEN | 0308 | 00000001
WR32 | DSI_TX_CLKSEL | 030C | 00000001 |  |  |  |  |  |  | SYSDTclk[11:10] | HSCK/8 | SYSCLclk[9:8] | HSCK/8 |  |  |  |  |  |  | HSTXclk_enb[0] | Enable
WR32 | MIPI_PLL_CONTROL | 04A0 | 00000001
WR32 | MIPI_PLL_CNF | 04AC | 000090BD | Program PLL for DSI-TX1
delay |  | 1000
WR32 | MIPI_PLL_CONTROL | 04A0 | 00000003
WR32 | LANE_ENABLE | 0318 | 00000014
WR32 | LINE_INIT_COUNT | 0320 | 00001770
WR32 | HSTX_TO_COUNT | 0324 | 00000000 |  |  | HSTX TO Count (Hex 0x0~0xFFFFFFFF) |  |  | 0 | OK
WR32 | FUNC_ENABLE | 0328 | 00000101 |  |  |  |  |  |  | INIT Int Dis | ApErrInt Dis | DSIPrto Inte Dis | DSIrErr Int Dis | DSILPTX Int Dis | DSIrTrg Int Dis | DSIrStat Int Dis | PR_TO Dis | HSTX_TO Dis | IND_TO Dis | INDMdSel Reg | VHDELAY Reg
REMnd | DSI_LPTX_MODE | 032C | 00000004 |  |  |  |  |  |  |  |  |  |  |  | Specified Line Number(0~8191) | OK | 0 | Output Tim[2:1] | Immediate | Cmd from[0] | Input
WR32 | DSI_TATO_COUNT | 0330 | 00010000 |  |  | TA TO Count (Hex 0x0~0xFFFFFFFF) |  |  | 10000 | OK
WR32 | DSI_PRESP_BTA_COUNT | 0334 | 00005000 |  |  | DSI_RRESP_BTA Count (Hex 0x0~0xFFFFFFFF) |  |  | 5000 | OK
WR32 | DSI_PRESP_LPR_COUNT | 0338 | 00010000 |  |  | DSI_PRESP_LPR Count (Hex 0x0~0xFFFFFFFF) |  |  | 10000 | OK
WR32 | DSI_PRESP_LPW_COUNT | 033C | 00010000 |  |  | DSI_PRESP_LPW Count (Hex 0x0~0xFFFFFFFF) |  |  | 10000 | OK
WR32 | DSI_PRESP_HSR_COUNT | 0340 | 00010000 |  |  | DSI_PRESP_HSR Count (Hex 0x0~0xFFFFFFFF) |  |  | 10000 | OK
WR32 | DSI_PRESP_HSW_COUNT | 0344 | 00010000 |  |  | DSI_PRESP_HSW Count (Hex 0x0~0xFFFFFFFF) |  |  | 10000 | OK
WR32 | DSI_PR_TO_COUNT | 0348 | 00001000 |  |  | DSI_PR_TO Count (Hex 0x0~0xFFFFFFFF) |  |  | 1000 | OK
WR32 | DSI_LRX-H_TO_COUNT | 034C | 00010000 |  |  | DSI_LRX-H TO Count (Hex 0x0~0xFFFFFFFF) |  |  | 10000 | OK
WR32 | FUNC_MODE | 0350 | 00000160 |  |  |  |  |  |  | Clk Force Stop[10] | Keep Operation | Contension Chk[9] | Enable | ECC Err Chk[8] | Disable | CRC Err Chk[6] | Disable | HS clk Md[5] | Continuous | Add EoT[0] | No
WR32 | DSI_RX_VC_ENABLE | 0354 | 00000001 |  |  |  |  |  |  |  |  |  |  | Receive VC3[3] | Disable | Receive VC0[2] | Disable | Receive VC0[1] | Disable | Receive VC0[0] | Enable
WR32 | IND_TO_COUNT | 0358 | 000000C8 |  |  | IND TO Count (Hex 0x0~0xFFFFFFFF) |  |  | C8 | OK
REMnd | INIT_INT_MSK | 0364 | 00000015 |  |  |  |  |  |  |  |  |  |  |  |  | LPRX Cal Done[2] | Mask | VREG Cnt Done[1] | Mask | Line Init Done[0] | Mask
WR32 | DSI_HSYNC_STOP_COUNT | 0368 | 0000002A |  |  | DSI_HSYNC STOP Count (Hex 0x0~0xFFFF) |  |  | 002A | OK
WR32 | APF_VDELAYCNT | 0370 | 00000478
REMnd | APF_VC_CONFIG | 0378 | 00000001 |  |  |  |  |  |  |  |  |  |  |  |  |  |  | VC Setting[2:1] | 0 | VC Select[0] | By Reg
WR32 | DSI_TX_MODE | 037C | 00000081
WR32 | DSI_HSYNC_WIDTH | 038C | 00000001
WR32 | DSI_HBPR | 0390 | 00000104
WR32 | DSI_RX_STATE_INT_MASK | 03A4 | 00000000 |  |  |  |  |  |  |  |  | LPRX Pkt Start[4] | No Mask | LPRX Pkt Done[3] | No Mask | LPRX Th Hit[2] | No Mask | Direction Fall[1] | No Mask | Direction Rise[0] | No Mask
REMnd | DSI_RXTRG_INT_MASK | 03AC | 00000000 |  |  |  |  |  |  |  |  |  |  | L0RX Trg3[3] | No Mask | L0RX Trg2[2] | No Mask | L0RX Trg1[1] | No Mask | L0RX Trg0[0] | No Mask
WR32 | DSI_LPRX_THRESH_COUNT | 03C0 | 00000015 |  |  | DSI_LPRX Threshold Count (Hex 0x0~0x1F) |  |  | 15 | OK
REMnd | DSI_PRTO_INT_MASK | 040C | 00000000 |  |  |  |  |  |  |  |  |  |  | Peri Resp TO[3] | No Mask |  |  | HSTX TO[1] | No Mask
WR32 | APP_SIDE_ERR_INT_MASK | 0414 | 00000000 |  |  | Ind Wrong Err[9] | No Mask | Line Buf RW Err[8] | No Mask | RX Buf OVF[6] | No Mask | Sync Buf OVF[4] | No Mask | Ind Buf OVF[3] | No Mask | Line Buf OVF[2] | No Mask | Err WC[1] | No Mask | Err Data Type[0] | No Mask
WR32 | DSI_RX_ERR_INT_MASK | 041C | 00000080 |  |  | Err Report Mask[13:3] |  | No Mask | No Mask | No Mask | No Mask | No Mask | No Mask | Mask | No Mask |  | No Mask | No Mask
WR32 | DSI_LPTX_INT_MASK | 0424 | 00000000 |  |  |  |  |  |  | Payload1 Done[9] | No Mask | Payload0 Done[8] | No Mask |  |  |  |  |  |  | LPTX Done[0] | No Mask
REMnd | DPHY_DLYCNTRL | 0440 | 00000000 |  |  |  |  |  |  |  |  | DLY Sel CL[19:16] | 0 | DLY Sel D3[15:12] | 0 | DLY Sel D2[11:8] | 0 | DLY Sel D1[7:4] | 0 | DLY Sel D0[3:0] | 0
WR32 | LPTXTIMECNT | 0454 | 00000006
WR32 | TCLK_HEADERCNT | 0458 | 00240204
WR32 | TCLK_TRAILCNT | 045C | 000D0008
WR32 | THS_HEADERCNT | 0460 | 00140006
WR32 | TWAKEUPCNT | 0464 | 00004268
WR32 | TCLK_POSTCNT | 0468 | 0000000F
WR32 | THS_TRAILCNT | 046C | 000D0008
WR32 | HSTXVREGCNT | 0470 | 00000020
WR32 | HSTXVREGEN | 0474 | 0000001F
WR32 | BTA_COUNT | 0478 | 00060005
WR32 | DPHY_TX ADJUST | 047C | 00000002 |  |  |  |  |  |  |  |  | CLLPTX Cur[9:8] | No Add | D3LPTX Cur[7:6] | No Add | D2LPTX Cur[5:4] | No Add | D1LPTX Cur[3:2] | No Add | D0LPTX Cur[1:0] | 25% Add
REMnd | DPHY_CAP | 0488 | 00000000 |  |  |  |  |  |  |  |  | CAP Sel CL[9:8] | 0 | CAP Sel D3[7:6] | 0 | CAP Sel D2[5:4] | 0 | CAP Sel D1[3:2] | 0 | CAP Sel D0[1:0] | 0
WR32 | DSITX_START | 031C | 00000001
REM | Command Transmission Before Video Start
WR32 | MODE_CONFIG | 0110 | 00000016 |  |  |  |  |  |  |  |  | DSI Cmd[4] | LP |  |  | HSYNC Pol[2] | L Active | VSYNC Pol[1] | L Active
WR32 | MODE_CONFIG | 0310 | 00000016 |  |  |  |  |  |  |  |  | DSI Cmd[4] | LP |  |  | HSYNC Pol[2] | L Active | VSYNC Pol[1] | L Active
REM | LCD Initialization
WR16 | CMD_SEL | 0500 | 0004
REM | Soft Reset
WR16 | DCSCMD_Q | 0504 | 0005
WR16 | DCSCMD_Q | 0504 | 0001
delay |  | 5000
REM | Set Pixel Format
WR16 | DCSCMD_Q | 0504 | 0015
WR16 | DCSCMD_Q | 0504 | 773A
delay |  | 200
REM | Set Column Address
WR16 | DCSCMD_Q | 0504 | 8039
WR16 | DCSCMD_Q | 0504 | 0005
WR16 | DCSCMD_Q | 0504 | 002A
WR16 | DCSCMD_Q | 0504 | 0400
WR16 | DCSCMD_Q | 0504 | 00FF
delay |  | 200
REM | Set Page Address
WR16 | DCSCMD_Q | 0504 | 8039
WR16 | DCSCMD_Q | 0504 | 0005
WR16 | DCSCMD_Q | 0504 | 002B
WR16 | DCSCMD_Q | 0504 | 0600
WR16 | DCSCMD_Q | 0504 | 003F
delay |  | 200
REM | Set Tear On
WR16 | DCSCMD_Q | 0504 | 0015
WR16 | DCSCMD_Q | 0504 | 0035
delay |  | 200
REM | Set Tear Scanline
WR16 | DCSCMD_Q | 0504 | 8039
WR16 | DCSCMD_Q | 0504 | 0003
WR16 | DCSCMD_Q | 0504 | 0044
WR16 | DCSCMD_Q | 0504 | 0000
delay |  | 200
REM | Write Display Brightness
WR16 | DCSCMD_Q | 0504 | 0015
WR16 | DCSCMD_Q | 0504 | FF51
delay |  | 200
REM | Write Control Display
WR16 | DCSCMD_Q | 0504 | 0015
WR16 | DCSCMD_Q | 0504 | 2453
delay |  | 200
REM | Adaptive Brightness Control
WR16 | DCSCMD_Q | 0504 | 0015
WR16 | DCSCMD_Q | 0504 | 0155
delay |  | 200
REM | Exit Sleep
WR16 | DCSCMD_Q | 0504 | 0005
WR16 | DCSCMD_Q | 0504 | 0011
delay |  | 120000
REM | MCAP
WR16 | DCSCMD_Q | 0504 | 0023
WR16 | DCSCMD_Q | 0504 | 00B0
delay |  | 200
REM | Backlight Control 4
WR16 | DCSCMD_Q | 0504 | 8029
WR16 | DCSCMD_Q | 0504 | 0014
WR16 | DCSCMD_Q | 0504 | 7DCE
WR16 | DCSCMD_Q | 0504 | 4840
WR16 | DCSCMD_Q | 0504 | 6756
WR16 | DCSCMD_Q | 0504 | 8878
WR16 | DCSCMD_Q | 0504 | A798
WR16 | DCSCMD_Q | 0504 | C3B5
WR16 | DCSCMD_Q | 0504 | DED1
WR16 | DCSCMD_Q | 0504 | F2E9
WR16 | DCSCMD_Q | 0504 | FFFA
WR16 | DCSCMD_Q | 0504 | 0004
REM | Split Control
WR16 | STX0_CTL | 5000 | 0000
REMnd | STX0_VPID | 5002 | A010
WR16 | STX0_FPX | 500C | 8000
REMnd | STX0_LPX | 500E | 04FF
WR16 | STX1_CTL | 5080 | 0000
REMnd | STX1_VPID | 5082 | A010
REMnd | STX1_FPX | 508C | 0500
REMnd | STX1_LPX | 508E | 09FF
REM | HDMI PHY
WR8 | PHY CTL | 8410 | 03 |  |  | [7] |  | [6] |  | [5] |  | [4] |  | [3] |  | [2] |  | [1] |  | PHYCtrl[0] | DDC5V Det
WR8 | PHY_ENB | 8413 | 3F |  |  | [7] |  | [6] |  | [5] |  | [4] |  | [3] |  | [2] |  | [1] |  | PHYEnb[0] | Normal
WR8 | APLL_CTL | 84F0 | 31 |  |  | [7] |  | [6] |  | APLL_CPCTL[5:4] |  |  | Normal | [3] |  | [2] |  | [1] |  | APLL_ON[0] | ON
WR8 | DDCIO_CTL | 84F4 | 01 |  |  | [7] |  | [6] |  | [5] |  | [4] |  | [3] |  | [2] |  | [1] |  | DDCIO_PWR[0] | Normal
REM | HDMI Clock
WR16 | SYS_FREQ0_1 | 8540 | 12C0
WR8 | LOCKDET_FREQ0 | 8630 | 00
WR16 | LOCKDET_REF1_2 | 8631 | 0753
WR8 | NCO_F0_MOD | 8670 | 02
WR16 | CSC_SCLK0_1 | 8A0C | 12C0
REM | HDMI Interrupt Mask, Clear
WR8 | SYS_INT | 8502 | FF |  |  | I_ACR_CTS[7] | Clear INT | I_ACRN[6] | Clear INT | I_DVI[5] | Clear INT | I_HDMI[4] | Clear INT | I_NOPMBDET[3] | Clear INT | I_DPMBDET[2] | Clear INT | I_TMDS[1] | Clear INT | I_DDC[0] | Clear INT
WR8 | SYS_INTM | 8512 | FE |  |  | M_ACR_CTS[7] | Mask On | M_ACR_N[6] | Mask On | M_DVI_DET[5] | Mask On | M_HDMI_DET[4] | Mask On | M_NOPMBDET[3] | Mask On | M_BPMBDET[2] | Mask On | M_TDMS[1] | Mask On | M_DDC[0] | Mask Off
REMnd | PACKET_INTM | 8514 | 00 |  |  | M_PK_ISRC2[7] | Mask Off | M_PK_ISRC[6] | Mask Off | M_PK_ACP[5] | Mask Off | M_PK_VS[4] | Mask Off | M_OK_SPD[3] | Mask Off | M_PK_MS[2] | Mask Off | M_PK_AUD[1] | Mask Off | M_PK_AVI[0] | Mask Off
REMnd | AUDIO_IMNTM | 8515 | 00 |  |  | M_AF_LOCK[7] | Mask Off | M_AF_UNLOCK[6] | Mask Off | [5] |  | M_AU_DSD[4] | Mask Off | M_AU_HBR[3] | Mask Off | M_CBIT_NLPCM[2] | Mask Off | M_CBIT_FS[1] | Mask Off | M_CBIT[0] | Mask Off
REMnd | ABUF_INTM | 8516 | 00 |  |  | M_BUF_OVR[7] | Mask Off | M_BUF_NO2[6] | Mask Off | M_BUF_NO1[5] | Mask Off | M_BUF_CTR[4] | Mask Off | M_BUF_NU1[3] | Mask Off | M_BUF_NU2[2] | Mask Off | M_BUF_UDR[1] | Mask Off | M_BFINIT_ED[0] | Mask Off
REM | Interrupt Control (TOP level)
WR16 | IntStatus | 0014 | 0FBF |  |  | [15] | [14] | [13] | [12] | DSITX1 Clear | AMUTE Clear | HDMI Clear | DSITX0 Clear | SLIMB Clear | [6] | SYS Clear | CEC-Er Clear | CEC-TX Clear | CEC-RX Clear | IR_Er Clear | IR_Dat Clear
WR16 | IntMask | 0016 | 0DBF |  |  | [15] | [14] | [13] | [12] | DSITX1 MSK | AMUTE MSK | HDMI Enb | DSITX0 MSK | SLIMB MSK | [6] | SYS MSK | CEC-Er MSK | CEC-TX MSK | CEC-RX MSK | IR_Er MSK | IR_Dat MSK
REM | EDID
WR8 | EDID_MODE | 85E0 | 01 |  |  | [7] |  | [6] |  | [5] |  | [4] |  | [3] |  | [2] |  | EDID_MODE[1:0] |  |  | RAM+DDC2B
WR16 | EDID_LEN1_2 | 85E3 | 0100 |  |  | EDID_LEN[10:0] EDID Data Length |  |  |  |  |  |  |  |  |  |  |  |  |  | OK | 256
REM | EDID Data |  |  | EDID setting is folded in line 67~line 324
WR8 | EDID_RAM | 8C00 | 00 |  | 0
WR8 | EDID_RAM | 8C01 | FF |  | 255
WR8 | EDID_RAM | 8C02 | FF |  | 255
WR8 | EDID_RAM | 8C03 | FF |  | 255
WR8 | EDID_RAM | 8C04 | FF |  | 255
WR8 | EDID_RAM | 8C05 | FF |  | 255
WR8 | EDID_RAM | 8C06 | FF |  | 255
WR8 | EDID_RAM | 8C07 | 00 |  | 0
WR8 | EDID_RAM | 8C08 | 52 |  | 82
WR8 | EDID_RAM | 8C09 | 62
WR8 | EDID_RAM | 8C0A | 88
WR8 | EDID_RAM | 8C0B | 88
WR8 | EDID_RAM | 8C0C | 00
WR8 | EDID_RAM | 8C0D | 88
WR8 | EDID_RAM | 8C0E | 88
WR8 | EDID_RAM | 8C0F | 88
WR8 | EDID_RAM | 8C10 | 1C
WR8 | EDID_RAM | 8C11 | 15
WR8 | EDID_RAM | 8C12 | 01
WR8 | EDID_RAM | 8C13 | 03
WR8 | EDID_RAM | 8C14 | 80
WR8 | EDID_RAM | 8C15 | 00
WR8 | EDID_RAM | 8C16 | 00
WR8 | EDID_RAM | 8C17 | 78
WR8 | EDID_RAM | 8C18 | 0A
WR8 | EDID_RAM | 8C19 | 0D
WR8 | EDID_RAM | 8C1A | C9
WR8 | EDID_RAM | 8C1B | A0
WR8 | EDID_RAM | 8C1C | 57
WR8 | EDID_RAM | 8C1D | 47
WR8 | EDID_RAM | 8C1E | 98
WR8 | EDID_RAM | 8C1F | 27
WR8 | EDID_RAM | 8C20 | 12
WR8 | EDID_RAM | 8C21 | 48
WR8 | EDID_RAM | 8C22 | 4C
WR8 | EDID_RAM | 8C23 | 00
WR8 | EDID_RAM | 8C24 | 00
WR8 | EDID_RAM | 8C25 | 00
WR8 | EDID_RAM | 8C26 | 01
WR8 | EDID_RAM | 8C27 | 01
WR8 | EDID_RAM | 8C28 | 01
WR8 | EDID_RAM | 8C29 | 01
WR8 | EDID_RAM | 8C2A | 01
WR8 | EDID_RAM | 8C2B | 01
WR8 | EDID_RAM | 8C2C | 01
WR8 | EDID_RAM | 8C2D | 01
WR8 | EDID_RAM | 8C2E | 01
WR8 | EDID_RAM | 8C2F | 01
WR8 | EDID_RAM | 8C30 | 01
WR8 | EDID_RAM | 8C31 | 01
WR8 | EDID_RAM | 8C32 | 01
WR8 | EDID_RAM | 8C33 | 01
WR8 | EDID_RAM | 8C34 | 01
WR8 | EDID_RAM | 8C35 | 01
WR8 | EDID_RAM | 8C36 | EC
WR8 | EDID_RAM | 8C37 | 68
WR8 | EDID_RAM | 8C38 | 00
WR8 | EDID_RAM | 8C39 | A0
WR8 | EDID_RAM | 8C3A | A0
WR8 | EDID_RAM | 8C3B | 40
WR8 | EDID_RAM | 8C3C | 2E
WR8 | EDID_RAM | 8C3D | 60
WR8 | EDID_RAM | 8C3E | 30
WR8 | EDID_RAM | 8C3F | 20
WR8 | EDID_RAM | 8C40 | 36
WR8 | EDID_RAM | 8C41 | 00
WR8 | EDID_RAM | 8C42 | 00
WR8 | EDID_RAM | 8C43 | 40
WR8 | EDID_RAM | 8C44 | A6
WR8 | EDID_RAM | 8C45 | 00
WR8 | EDID_RAM | 8C46 | 00
WR8 | EDID_RAM | 8C47 | 18
WR8 | EDID_RAM | 8C48 | EC
WR8 | EDID_RAM | 8C49 | 68
WR8 | EDID_RAM | 8C4A | 00
WR8 | EDID_RAM | 8C4B | A0
WR8 | EDID_RAM | 8C4C | A0
WR8 | EDID_RAM | 8C4D | 40
WR8 | EDID_RAM | 8C4E | 2E
WR8 | EDID_RAM | 8C4F | 60
WR8 | EDID_RAM | 8C50 | 30
WR8 | EDID_RAM | 8C51 | 20
WR8 | EDID_RAM | 8C52 | 36
WR8 | EDID_RAM | 8C53 | 00
WR8 | EDID_RAM | 8C54 | 00
WR8 | EDID_RAM | 8C55 | 40
WR8 | EDID_RAM | 8C56 | A6
WR8 | EDID_RAM | 8C57 | 00
WR8 | EDID_RAM | 8C58 | 00
WR8 | EDID_RAM | 8C59 | 18
WR8 | EDID_RAM | 8C5A | 00
WR8 | EDID_RAM | 8C5B | 00
WR8 | EDID_RAM | 8C5C | 00
WR8 | EDID_RAM | 8C5D | FC
WR8 | EDID_RAM | 8C5E | 00
WR8 | EDID_RAM | 8C5F | 54
WR8 | EDID_RAM | 8C60 | 6F
WR8 | EDID_RAM | 8C61 | 73
WR8 | EDID_RAM | 8C62 | 68
WR8 | EDID_RAM | 8C63 | 69
WR8 | EDID_RAM | 8C64 | 62
WR8 | EDID_RAM | 8C65 | 61
WR8 | EDID_RAM | 8C66 | 2D
WR8 | EDID_RAM | 8C67 | 55
WR8 | EDID_RAM | 8C68 | 48
WR8 | EDID_RAM | 8C69 | 32
WR8 | EDID_RAM | 8C6A | 44
WR8 | EDID_RAM | 8C6B | 0A
WR8 | EDID_RAM | 8C6C | 00
WR8 | EDID_RAM | 8C6D | 00
WR8 | EDID_RAM | 8C6E | 00
WR8 | EDID_RAM | 8C6F | FD
WR8 | EDID_RAM | 8C70 | 00
WR8 | EDID_RAM | 8C71 | 17
WR8 | EDID_RAM | 8C72 | 3D
WR8 | EDID_RAM | 8C73 | 0F
WR8 | EDID_RAM | 8C74 | 8C
WR8 | EDID_RAM | 8C75 | 17
WR8 | EDID_RAM | 8C76 | 00
WR8 | EDID_RAM | 8C77 | 0A
WR8 | EDID_RAM | 8C78 | 20
WR8 | EDID_RAM | 8C79 | 20
WR8 | EDID_RAM | 8C7A | 20
WR8 | EDID_RAM | 8C7B | 20
WR8 | EDID_RAM | 8C7C | 20
WR8 | EDID_RAM | 8C7D | 20
WR8 | EDID_RAM | 8C7E | 01
WR8 | EDID_RAM | 8C7F | 40
WR8 | EDID_RAM | 8C80 | 02
WR8 | EDID_RAM | 8C81 | 03
WR8 | EDID_RAM | 8C82 | 17
WR8 | EDID_RAM | 8C83 | 74
WR8 | EDID_RAM | 8C84 | 47
WR8 | EDID_RAM | 8C85 | 4C
WR8 | EDID_RAM | 8C86 | 4C
WR8 | EDID_RAM | 8C87 | 4C
WR8 | EDID_RAM | 8C88 | 4C
WR8 | EDID_RAM | 8C89 | 4C
WR8 | EDID_RAM | 8C8A | 4C
WR8 | EDID_RAM | 8C8B | 4C
WR8 | EDID_RAM | 8C8C | 23
WR8 | EDID_RAM | 8C8D | 09
WR8 | EDID_RAM | 8C8E | 07
WR8 | EDID_RAM | 8C8F | 01
WR8 | EDID_RAM | 8C90 | 66
WR8 | EDID_RAM | 8C91 | 03
WR8 | EDID_RAM | 8C92 | 0C
WR8 | EDID_RAM | 8C93 | 00
WR8 | EDID_RAM | 8C94 | 30
WR8 | EDID_RAM | 8C95 | 00
WR8 | EDID_RAM | 8C96 | 80
WR8 | EDID_RAM | 8C97 | 8C
WR8 | EDID_RAM | 8C98 | 0A
WR8 | EDID_RAM | 8C99 | D0
WR8 | EDID_RAM | 8C9A | EC
WR8 | EDID_RAM | 8C9B | 68
WR8 | EDID_RAM | 8C9C | 00
WR8 | EDID_RAM | 8C9D | A0
WR8 | EDID_RAM | 8C9E | A0
WR8 | EDID_RAM | 8C9F | 40
WR8 | EDID_RAM | 8CA0 | 2E
WR8 | EDID_RAM | 8CA1 | 60
WR8 | EDID_RAM | 8CA2 | 30
WR8 | EDID_RAM | 8CA3 | 20
WR8 | EDID_RAM | 8CA4 | 36
WR8 | EDID_RAM | 8CA5 | 00
WR8 | EDID_RAM | 8CA6 | 00
WR8 | EDID_RAM | 8CA7 | 40
WR8 | EDID_RAM | 8CA8 | A6
WR8 | EDID_RAM | 8CA9 | 00
WR8 | EDID_RAM | 8CAA | 00
WR8 | EDID_RAM | 8CAB | 18
WR8 | EDID_RAM | 8CAC | EC
WR8 | EDID_RAM | 8CAD | 68
WR8 | EDID_RAM | 8CAE | 00
WR8 | EDID_RAM | 8CAF | A0
WR8 | EDID_RAM | 8CB0 | A0
WR8 | EDID_RAM | 8CB1 | 40
WR8 | EDID_RAM | 8CB2 | 2E
WR8 | EDID_RAM | 8CB3 | 60
WR8 | EDID_RAM | 8CB4 | 30
WR8 | EDID_RAM | 8CB5 | 20
WR8 | EDID_RAM | 8CB6 | 36
WR8 | EDID_RAM | 8CB7 | 00
WR8 | EDID_RAM | 8CB8 | 00
WR8 | EDID_RAM | 8CB9 | 40
WR8 | EDID_RAM | 8CBA | A6
WR8 | EDID_RAM | 8CBB | 00
WR8 | EDID_RAM | 8CBC | 00
WR8 | EDID_RAM | 8CBD | 18
WR8 | EDID_RAM | 8CBE | EC
WR8 | EDID_RAM | 8CBF | 68
WR8 | EDID_RAM | 8CC0 | 00
WR8 | EDID_RAM | 8CC1 | A0
WR8 | EDID_RAM | 8CC2 | A0
WR8 | EDID_RAM | 8CC3 | 40
WR8 | EDID_RAM | 8CC4 | 2E
WR8 | EDID_RAM | 8CC5 | 60
WR8 | EDID_RAM | 8CC6 | 30
WR8 | EDID_RAM | 8CC7 | 20
WR8 | EDID_RAM | 8CC8 | 36
WR8 | EDID_RAM | 8CC9 | 00
WR8 | EDID_RAM | 8CCA | 00
WR8 | EDID_RAM | 8CCB | 40
WR8 | EDID_RAM | 8CCC | A6
WR8 | EDID_RAM | 8CCD | 00
WR8 | EDID_RAM | 8CCE | 00
WR8 | EDID_RAM | 8CCF | 18
WR8 | EDID_RAM | 8CD0 | EC
WR8 | EDID_RAM | 8CD1 | 68
WR8 | EDID_RAM | 8CD2 | 00
WR8 | EDID_RAM | 8CD3 | A0
WR8 | EDID_RAM | 8CD4 | A0
WR8 | EDID_RAM | 8CD5 | 40
WR8 | EDID_RAM | 8CD6 | 2E
WR8 | EDID_RAM | 8CD7 | 60
WR8 | EDID_RAM | 8CD8 | 30
WR8 | EDID_RAM | 8CD9 | 20
WR8 | EDID_RAM | 8CDA | 36
WR8 | EDID_RAM | 8CDB | 00
WR8 | EDID_RAM | 8CDC | 00
WR8 | EDID_RAM | 8CDD | 40
WR8 | EDID_RAM | 8CDE | A6
WR8 | EDID_RAM | 8CDF | 00
WR8 | EDID_RAM | 8CE0 | 00
WR8 | EDID_RAM | 8CE1 | 18
WR8 | EDID_RAM | 8CE2 | 00
WR8 | EDID_RAM | 8CE3 | 00
WR8 | EDID_RAM | 8CE4 | 00
WR8 | EDID_RAM | 8CE5 | 00
WR8 | EDID_RAM | 8CE6 | 00
WR8 | EDID_RAM | 8CE7 | 00
WR8 | EDID_RAM | 8CE8 | 00
WR8 | EDID_RAM | 8CE9 | 00
WR8 | EDID_RAM | 8CEA | 00
WR8 | EDID_RAM | 8CEB | 00
WR8 | EDID_RAM | 8CEC | 00
WR8 | EDID_RAM | 8CED | 00
WR8 | EDID_RAM | 8CEE | 00
WR8 | EDID_RAM | 8CEF | 00
WR8 | EDID_RAM | 8CF0 | 00
WR8 | EDID_RAM | 8CF1 | 00
WR8 | EDID_RAM | 8CF2 | 00
WR8 | EDID_RAM | 8CF3 | 00
WR8 | EDID_RAM | 8CF4 | 00
WR8 | EDID_RAM | 8CF5 | 00
WR8 | EDID_RAM | 8CF6 | 00
WR8 | EDID_RAM | 8CF7 | 00
WR8 | EDID_RAM | 8CF8 | 00
WR8 | EDID_RAM | 8CF9 | 00
WR8 | EDID_RAM | 8CFA | 00
WR8 | EDID_RAM | 8CFB | 00
WR8 | EDID_RAM | 8CFC | 00
WR8 | EDID_RAM | 8CFD | 00
WR8 | EDID_RAM | 8CFE | 00
WR8 | EDID_RAM | 8CFF | BE
REM | HDCP Setting
REMnd |  | 85D1 | 01 | Key loading command
REMnd | HDCP_MODE | 8560 | 24 | KSV Auto Clear Mode |  | [7] |  | [6] |  | Md_RST_TN[5] | AutoRes On | LinkRekey[4] | 57clk | [3] |  | Auto CLR[2] | 57clk | [1] |  | [0]
REMnd |  | 8563 | 11 | EESS_Err auto-unAuth
REMnd |  | 8564 | 0F | DI_Err (Data Island Error) auto-unAuth
REM | Video Color Format Setting
REMnd | VOUT_FMT | 8A00 | 02
REMnd | VOUT_FIL | 8A01 | 14
WR8 | VOUT_SYNC0 | 8A02 | 42 |  |  | M3_VSIZE[7:6] |  |  | 1 | M3_HSIZE[5:4] |  |  | 0 | [3] |  | [2] |  | VOUT_MODE[1:0] |  |  | Mode2
REMnd | VOUT_COLOR | 8A08 | 11
REM | HDMI SYSTEM
WR8 | DDC_CTL | 8543 | 02 |  |  | [7] |  | [6] |  | [5] |  | [4] |  | [3] |  | DDCACT[2] | HotPlug | DDC5V_MODE[1:0] |  |  | 100ms
WR8 | HPD_CTL | 8544 | 10 |  |  | [7] |  | [6] |  | [5] |  | HPD_CTL0[4] | Auto | [3] |  | [2] |  | [1] | HPD_OUT0[0] |  | L Out
REM | HDMI Audio Setting
WR8 | AUD_Auto_Mute | 8600 | 00 | Audio and Data mute setting |  | [7] |  | [6] |  | [5] |  | A_MUTE[4] | OFF | [3] |  | [2] |  | [1] |  | D_MUTE[0] | OFF
WR8 | Auto_CMD0 | 8602 | F3 |  |  | Auto_Mute[7] | Set | Auto_Mute[6] | Set | Auto_Mute[5] | Set | Auto_Mute[4] | Set | Auto_Mute[3] | Not Set | Auto_Mute[2] | Not Set | Auto_Mute[1] | Set | Auto_Mute[0] | Set
WR8 | Auto_CMD1 | 8603 | 02 |  |  | [7] |  | [6] |  | [5] |  | [4] |  | [3] |  | Auto_Mute[10] | Not Set | Auto_Mute[9] | Set | Auto_Mute[8] | Not Set
WR8 | Auto_CMD2 | 8604 | 0C |  |  | [7] |  | [6] |  | [5] |  | [4] |  | Auto_Play[3] | Clear | Auto_Play[2] | Issue | [1] |  | [0]
WR8 | BUFINIT_START | 8606 | 05 |  |  |  |  |  |  |  |  |  |  |  |  |  |  |  | BUF_INIT_START[7:0] (us) 0.1us~25.5us | OK | 0.5
WR8 | FS_MUTE | 8607 | 00 |  |  | FSelseMute[7] | Not Mute | FS22_Mute[6] | Not Mute | FS24_Mute[5] | Not Mute | FS88_Mute[4] | Not Mute | FS96_Mute[3] | Not Mute | FS176Mute[2] | Not Mute | FS192Mute[1] | Not Mute | FS_NoMute[0] | Not Mute
WR8 | SDO_MODE1 | 8652 | 02 |  |  | [7] |  | SDO_BIT_LENGTH[6:4] |  |  |  |  | 16b_8bDscd | [3] |  | [2] |  | SDO_FORMAT[1:0] |  |  | I2S
WR32 | NCO_48F0A_D | 8671 | 020C49BA
WR32 | NCO_44F0A_D | 8675 | 01E1B089
WR8 | AUD_MODE | 8680 | 00 |  |  | [7] |  | [6] |  | [5] |  | [4] |  | [3] |  | [2] |  | Audio Relay[1:0] |  |  | Normal Aud
REM | Let HDMI Source start access
WR8 | INIT_END | 854A | 01
REM | Start Video TX
WR16 | ConfCtl0 | 0004 | 0C37
WR16 | ConfCtl1 | 0006 | 0000
REM | Command Transmission After Video Start.
WR32 | MODE_CONFIG | 0110 | 00000006 |  |  |  |  |  |  |  |  | DSI Cmd[4] | HS |  |  | HSYNC Pol[2] | L Active | VSYNC Pol[1] | L Active
WR32 | MODE_CONFIG | 0310 | 00000006 |  |  |  |  |  |  |  |  | DSI Cmd[4] | HS |  |  | HSYNC Pol[2] | L Active | VSYNC Pol[1] | L Active
delay |  | 1000000
REM | MCAP
WR16 | DCSCMD_Q | 0504 | 0023
WR16 | DCSCMD_Q | 0504 | 00B0
delay |  | 200
REM | Interface Setting
WR16 | DCSCMD_Q | 0504 | 0023
WR16 | DCSCMD_Q | 0504 | 14B3
delay |  | 200
REM | MCAP
WR16 | DCSCMD_Q | 0504 | 0023
WR16 | DCSCMD_Q | 0504 | 03B0
delay |  | 200
REM | Set Display On
WR16 | DCSCMD_Q | 0504 | 0005
WR16 | DCSCMD_Q | 0504 | 0029
delay |  | 200
END

Sheet: EDID
TC358870XBG EDID Setting |  |  |  | v03 | Title
TOSHIBA Confidential
REM | EDID Data
WR8 | EDID_RAM | 8C09 | 62 | 98 | Product Information |  | Judge
WR8 | EDID_RAM | 8C0A | 88 | 136 | Product code0(0-255)-> | 136 | OK
WR8 | EDID_RAM | 8C0B | 88 | 136 | Product code1(0-255)-> | 136 | OK
WR8 | EDID_RAM | 8C0C | 00 | 0 | Serial number0(0-255)-> | 0 | OK
WR8 | EDID_RAM | 8C0D | 88 | 136 | Serial number1(0-255)-> | 136 | OK
WR8 | EDID_RAM | 8C0E | 88 | 136 | Serial number2(0-255)-> | 136 | OK
WR8 | EDID_RAM | 8C0F | 88 | 136 | Serial number3(0-255)-> | 136 | OK
WR8 | EDID_RAM | 8C10 | 1C | 28 | Week of Manufacture(0-53)-> | 28 | OK
WR8 | EDID_RAM | 8C11 | 15 | 21 | Year of Manufacture(ex.2012)-> | 2011 | OK
WR8 | EDID_RAM | 8C36 | EC | 236 | 1st Detailed Timing Descriptor(New) |  | Judge
WR8 | EDID_RAM | 8C37 | 68 | 104 | PCLK(***.**MHz) (max:655)-> | 148 | -
WR8 | EDID_RAM | 8C38 | 00 | 0 | H Active(PCLK) (max:4095)-> | 1080 | -
WR8 | EDID_RAM | 8C39 | A0 | 160 | HPW(PCLK) (max:1023)-> | 72 | -
WR8 | EDID_RAM | 8C3A | A0 | 160 | HBP (PCLK)-> | 128 | -
WR8 | EDID_RAM | 8C3B | 40 | 64 | HFP(PCLK) (max:1023)-> | 56 | -
WR8 | EDID_RAM | 8C3C | 2E | 46 | V Active(lines) (max:4095)-> | 1920 | -
WR8 | EDID_RAM | 8C3D | 60 | 96 | VPW(lines) (max:63)-> | 10 | -
WR8 | EDID_RAM | 8C3E | 30 | 48 | VBP (lines)-> | 34 | -
WR8 | EDID_RAM | 8C3F | 20 | 32 | VFP(lines) (max:63)-> | 3 | -
WR8 | EDID_RAM | 8C40 | 36 | 54 | Horizontal Image Size (mm)-> | 1080 | -
WR8 | EDID_RAM | 8C41 | 00 | 0 | Vertical Image Size (mm)-> | 1920 | -
WR8 | EDID_RAM | 8C42 | 00 | 0 | Interlace/Progressive-> | Progressive | 0
WR8 | EDID_RAM | 8C43 | 40 | 64 | VSYNC Polarity-> | H Active | 1
WR8 | EDID_RAM | 8C44 | A6 | 166 | HSYNC Polarity-> | H Active | 1
WR8 | EDID_RAM | 8C48 | EC | 236 | 2nd Detailed Timing Descriptor(New) |  | Judge
WR8 | EDID_RAM | 8C49 | 68 | 104 | PCLK(***.**MHz) (max:655)-> | 27 | -
WR8 | EDID_RAM | 8C4A | 00 | 0 | H Active(PCLK) (max:4095)-> | 720 | -
WR8 | EDID_RAM | 8C4B | A0 | 160 | HPW(PCLK) (max:1023)-> | 62 | -
WR8 | EDID_RAM | 8C4C | A0 | 160 | HBP (PCLK)-> | 60 | -
WR8 | EDID_RAM | 8C4D | 40 | 64 | HFP(PCLK) (max:1023)-> | 16 | -
WR8 | EDID_RAM | 8C4E | 2E | 46 | V Active(lines) (max:4095)-> | 480 | -
WR8 | EDID_RAM | 8C4F | 60 | 96 | VPW(lines) (max:63)-> | 6 | -
WR8 | EDID_RAM | 8C50 | 30 | 48 | VBP (lines)-> | 30 | -
WR8 | EDID_RAM | 8C51 | 20 | 32 | VFP(lines) (max:63)-> | 9 | -
WR8 | EDID_RAM | 8C52 | 36 | 54 | Horizontal Image Size (mm)-> | 531 | -
WR8 | EDID_RAM | 8C53 | 00 | 0 | Vertical Image Size (mm)-> | 398 | -
WR8 | EDID_RAM | 8C54 | 00 | 0 | Interlace/Progressive-> | Progressive | 0
WR8 | EDID_RAM | 8C55 | 40 | 64 | VSYNC Polarity-> | H Active | 1
WR8 | EDID_RAM | 8C56 | A6 | 166 | HSYNC Polarity-> | H Active | 1
WR8 | EDID_RAM | 8C5E | 00 | 0 | Monitor Name (ASCII) ("LF"=Line Feed) |  | Judge
WR8 | EDID_RAM | 8C5F | 54 | 84 | Monitor Name(1Byte Char)-> | T | OK
WR8 | EDID_RAM | 8C60 | 6F | 111 | Monitor Name(1Byte Char)-> | o | OK
WR8 | EDID_RAM | 8C61 | 73 | 115 | Monitor Name(1Byte Char)-> | s | OK
WR8 | EDID_RAM | 8C62 | 68 | 104 | Monitor Name(1Byte Char)-> | h | OK
WR8 | EDID_RAM | 8C63 | 69 | 105 | Monitor Name(1Byte Char)-> | i | OK
WR8 | EDID_RAM | 8C64 | 62 | 98 | Monitor Name(1Byte Char)-> | b | OK
WR8 | EDID_RAM | 8C65 | 61 | 97 | Monitor Name(1Byte Char)-> | a | OK
WR8 | EDID_RAM | 8C66 | 2D | 45 | Monitor Name(1Byte Char)-> | - | OK
WR8 | EDID_RAM | 8C67 | 55 | 85 | Monitor Name(1Byte Char)-> | U | OK
WR8 | EDID_RAM | 8C68 | 48 | 72 | Monitor Name(1Byte Char)-> | H | OK
WR8 | EDID_RAM | 8C69 | 32 | 50 | Monitor Name(1Byte Char)-> | 2 | OK
WR8 | EDID_RAM | 8C6A | 44 | 68 | Monitor Name(1Byte Char)-> | D | OK
WR8 | EDID_RAM | 8C6B | 0A | 10 | Monitor Name(1Byte Char)-> | LF | OK
WR8 | EDID_RAM | 8C84 | 47 | 71 | Video Data Block (SVDs) | Native | ID Code
WR8 | EDID_RAM | 8C85 | 4C | 76 | 1st Video Descriptor | No | 4
WR8 | EDID_RAM | 8C86 | 4C | 76 | 2nd Video Descriptor | No | 19
WR8 | EDID_RAM | 8C87 | 4C | 76 | 3rd Video Descriptor | No | 3
WR8 | EDID_RAM | 8C88 | 4C | 76 | 4th Video Descriptor | No | 2
WR8 | EDID_RAM | 8C89 | 4C | 76 | 5th Video Descriptor | No | 7
WR8 | EDID_RAM | 8C8A | 4C | 76 | 6th Video Descriptor | No | 6
WR8 | EDID_RAM | 8C8B | 4C | 76 | 7th Video Descriptor | No | 1
WR8 | EDID_RAM | 8C9A | EC | 236 | 3rd Detailed Timing Descriptor(New) |  | Judge
WR8 | EDID_RAM | 8C9B | 68 | 104 | PCLK(***.**MHz) (max:655)-> | 27 | -
WR8 | EDID_RAM | 8C9C | 00 | 0 | H Active(PCLK) (max:4095)-> | 720 | -
WR8 | EDID_RAM | 8C9D | A0 | 160 | HPW(PCLK) (max:1023)-> | 62 | -
WR8 | EDID_RAM | 8C9E | A0 | 160 | HBP (PCLK)-> | 60 | -
WR8 | EDID_RAM | 8C9F | 40 | 64 | HFP(PCLK) (max:1023)-> | 16 | -
WR8 | EDID_RAM | 8CA0 | 2E | 46 | V Active(lines) (max:4095)-> | 480 | -
WR8 | EDID_RAM | 8CA1 | 60 | 96 | VPW(lines) (max:63)-> | 6 | -
WR8 | EDID_RAM | 8CA2 | 30 | 48 | VBP (lines)-> | 30 | -
WR8 | EDID_RAM | 8CA3 | 20 | 32 | VFP(lines) (max:63)-> | 9 | -
WR8 | EDID_RAM | 8CA4 | 36 | 54 | Horizontal Image Size (mm)-> | 708 | -
WR8 | EDID_RAM | 8CA5 | 00 | 0 | Vertical Image Size (mm)-> | 398 | -
WR8 | EDID_RAM | 8CA6 | 00 | 0 | Interlace/Progressive-> | Progressive | 0
WR8 | EDID_RAM | 8CA7 | 40 | 64 | VSYNC Polarity-> | H Active | 1
WR8 | EDID_RAM | 8CA8 | A6 | 166 | HSYNC Polarity-> | H Active | 1
WR8 | EDID_RAM | 8CAC | EC | 236 | 4th Detailed Timing Descriptor(New) |  | Judge
WR8 | EDID_RAM | 8CAD | 68 | 104 | PCLK(***.**MHz) (max:655)-> | 148.5 | -
WR8 | EDID_RAM | 8CAE | 00 | 0 | H Active(PCLK) (max:4095)-> | 1920 | -
WR8 | EDID_RAM | 8CAF | A0 | 160 | HPW(PCLK) (max:1023)-> | 44 | -
WR8 | EDID_RAM | 8CB0 | A0 | 160 | HBP (PCLK)-> | 148 | -
WR8 | EDID_RAM | 8CB1 | 40 | 64 | HFP(PCLK) (max:1023)-> | 88 | -
WR8 | EDID_RAM | 8CB2 | 2E | 46 | V Active(lines) (max:4095)-> | 1080 | -
WR8 | EDID_RAM | 8CB3 | 60 | 96 | VPW(lines) (max:63)-> | 5 | -
WR8 | EDID_RAM | 8CB4 | 30 | 48 | VBP (lines)-> | 36 | -
WR8 | EDID_RAM | 8CB5 | 20 | 32 | VFP(lines) (max:63)-> | 4 | -
WR8 | EDID_RAM | 8CB6 | 36 | 54 | Horizontal Image Size (mm)-> | 708 | -
WR8 | EDID_RAM | 8CB7 | 00 | 0 | Vertical Image Size (mm)-> | 398 | -
WR8 | EDID_RAM | 8CB8 | 00 | 0 | Interlace/Progressive-> | Progressive | 0
WR8 | EDID_RAM | 8CB9 | 40 | 64 | VSYNC Polarity-> | L Active | 0
WR8 | EDID_RAM | 8CBA | A6 | 166 | HSYNC Polarity-> | L Active | 0
WR8 | EDID_RAM | 8CBE | EC | 236 | 5th Detailed Timing Descriptor(New) |  | Judge
WR8 | EDID_RAM | 8CBF | 68 | 104 | PCLK(***.**MHz) (max:655)-> | 27 | -
WR8 | EDID_RAM | 8CC0 | 00 | 0 | H Active(PCLK) (max:4095)-> | 1440 | -
WR8 | EDID_RAM | 8CC1 | A0 | 160 | HPW(PCLK) (max:1023)-> | 124 | -
WR8 | EDID_RAM | 8CC2 | A0 | 160 | HBP (PCLK)-> | 114 | -
WR8 | EDID_RAM | 8CC3 | 40 | 64 | HFP(PCLK) (max:1023)-> | 38 | -
WR8 | EDID_RAM | 8CC4 | 2E | 46 | V Active(lines) (max:4095)-> | 240 | -
WR8 | EDID_RAM | 8CC5 | 60 | 96 | VPW(lines) (max:63)-> | 3 | -
WR8 | EDID_RAM | 8CC6 | 30 | 48 | VBP (lines)-> | 15 | -
WR8 | EDID_RAM | 8CC7 | 20 | 32 | VFP(lines) (max:63)-> | 4 | -
WR8 | EDID_RAM | 8CC8 | 36 | 54 | Horizontal Image Size (mm)-> | 708 | -
WR8 | EDID_RAM | 8CC9 | 00 | 0 | Vertical Image Size (mm)-> | 398 | -
WR8 | EDID_RAM | 8CCA | 00 | 0 | Interlace/Progressive-> | Progressive | 0
WR8 | EDID_RAM | 8CCB | 40 | 64 | VSYNC Polarity-> | L Active | 0
WR8 | EDID_RAM | 8CCC | A6 | 166 | HSYNC Polarity-> | L Active | 0
WR8 | EDID_RAM | 8CD0 | EC | 236 | 6th Detailed Timing Descriptor(New) |  | Judge
WR8 | EDID_RAM | 8CD1 | 68 | 104 | PCLK(***.**MHz) (max:655)-> | 148.5 | -
WR8 | EDID_RAM | 8CD2 | 00 | 0 | H Active(PCLK) (max:4095)-> | 1440 | -
WR8 | EDID_RAM | 8CD3 | A0 | 160 | HPW(PCLK) (max:1023)-> | 124 | -
WR8 | EDID_RAM | 8CD4 | A0 | 160 | HBP (PCLK)-> | 114 | -
WR8 | EDID_RAM | 8CD5 | 40 | 64 | HFP(PCLK) (max:1023)-> | 38 | -
WR8 | EDID_RAM | 8CD6 | 2E | 46 | V Active(lines) (max:4095)-> | 480 | -
WR8 | EDID_RAM | 8CD7 | 60 | 96 | VPW(lines) (max:63)-> | 3 | -
WR8 | EDID_RAM | 8CD8 | 30 | 48 | VBP (lines)-> | 15 | -
WR8 | EDID_RAM | 8CD9 | 20 | 32 | VFP(lines) (max:63)-> | 4 | -
WR8 | EDID_RAM | 8CDA | 36 | 54 | Horizontal Image Size (mm)-> | 708 | -
WR8 | EDID_RAM | 8CDB | 00 | 0 | Vertical Image Size (mm)-> | 398 | -
WR8 | EDID_RAM | 8CDC | 00 | 0 | Interlace/Progressive-> | Progressive | 0
WR8 | EDID_RAM | 8CDD | 40 | 64 | VSYNC Polarity-> | L Active | 0
WR8 | EDID_RAM | 8CDE | A6 | 166 | HSYNC Polarity-> | L Active | 0

Sheet: Source_CabCnct
TC358870XBG HDMI Cable connect/disconnect handling |  |  |  |  | v02 | Title
Command Description WR8:8bit Write, WR16:16bit Write, WR32:32bit Write, RD8:8bit Read, RD16:16bit Read, RD32:32bit Read |  |  |  |  |  | TOSHIBA Confidential
Command Description delay:Wait (unit is "us"), REM/REMnd: Remark. For delay command, Wait value must be written into address column.
 |  |  |  |  |  |  | Conditional WR
Interrupt Routine for HDMI cable connect/disconnect detection
CMD | Register Name | Address | Data | Comment
REM | Interrupt Routine Start (When interrupt occurs)
RD16 | IntStatus | 0014 |  | Check bit9 (HDMI-RX interrupt). If bit9=1 then execute next step. If not, go to "Clear Interrupt"
RD8 | SYS_INT | 8502 |  | Check bit0 or 1(TMDS or DDC interrupt). If bit1 or bit0=1 then execute next step. If not, go to "Clear Interrupt".
RD8 | SYS_STATUS | 8520 |  | Check bit1 or bit0 (Status of TMDS or 5V). If bit1 or bit0=0 then execute next step. If not, go to "Clear Interrupt"
REM | Stop LCD display. Reset LCD if needed
REM | Assert hardware reset (RESETN)
REM | Return from Interrupt Routine
REM | Execute "Source_Startup" sequence again
REM | Clear Interrupt
WR8 | SYS_INT | 8502 | FF | Celar all HDMI-RX Interrupt
WR16 | IntStatus | 0014 | 0FBF | Clear all Interrupt
REM | Return from Interrupt Routine
END

Sheet: Source_ColorBar
TC358870XBG embedded Color Bar Sequence |  |  |  |  | v03 | Title
Command Description WR8:8bit Write, WR16:16bit Write, WR32:32bit Write, RD8:8bit Read, RD16:16bit Read, RD32:32bit Read |  |  |  |  |  | TOSHIBA Confidential
Command Description delay:Wait (unit is "us"), REM/REMnd: Remark. For delay command, Wait value must be written into address column.
Initialization
CMD | Register Name | Address | Data | Comment
REM | Software Reset
WR16 | ConfCtl0 | 0004 | 0004
WR16 | SysCtl | 0002 | 3F01 | Assert Reset, Exit Sleep, wait
WR16 | SysCtl | 0002 | 0000 | Release Reset, Exit Sleep
WR16 | ConfCtl1 | 0006 | 0000
WR16 | CB_CTL | 7000 | 0009
REM | DSI-TX1 Transition Timing
WR32 | DSI_TX_CLKEN | 0308 | 00000001
WR32 | DSI_TX_CLKSEL | 030C | 00000001 |  |  |  |  |  |  | SYSDTclk[11:10] | HSCK/8 | SYSCLclk[9:8] | HSCK/8 |  |  |  |  |  |  | HSTXclk_enb[0] | Enable
WR32 | MIPI_PLL_CONTROL | 04A0 | 00000001
WR32 | MIPI_PLL_CNF | 04AC | 000090BD | Program PLL for DSI-TX1
delay |  | 1000
WR32 | MIPI_PLL_CONTROL | 04A0 | 00000003
WR32 | LANE_ENABLE | 0318 | 00000014
WR32 | LINE_INIT_COUNT | 0320 | 00001770
WR32 | HSTX_TO_COUNT | 0324 | 00000000 |  |  | HSTX TO Count (Hex 0x0~0xFFFFFFFF) |  |  | 0 | OK
WR32 | FUNC_ENABLE | 0328 | 00000101 |  |  |  |  |  |  | INIT Int Dis | ApErrInt Dis | DSIPrto Inte Dis | DSIrErr Int Dis | DSILPTX Int Dis | DSIrTrg Int Dis | DSIrStat Int Dis | PR_TO Dis | HSTX_TO Dis | IND_TO Dis | INDMdSel Reg | VHDELAY Reg
REMnd | DSI_LPTX_MODE | 032C | 00000004 |  |  |  |  |  |  |  |  |  |  |  | Specified Line Number(0~8191) | OK | 0 | Output Tim[2:1] | Immediate | Cmd from[0] | Input
WR32 | DSI_TATO_COUNT | 0330 | 00010000 |  |  | TA TO Count (Hex 0x0~0xFFFFFFFF) |  |  | 10000 | OK
WR32 | DSI_PRESP_BTA_COUNT | 0334 | 00005000 |  |  | DSI_RRESP_BTA Count (Hex 0x0~0xFFFFFFFF) |  |  | 5000 | OK
WR32 | DSI_PRESP_LPR_COUNT | 0338 | 00010000 |  |  | DSI_PRESP_LPR Count (Hex 0x0~0xFFFFFFFF) |  |  | 10000 | OK
WR32 | DSI_PRESP_LPW_COUNT | 033C | 00010000 |  |  | DSI_PRESP_LPW Count (Hex 0x0~0xFFFFFFFF) |  |  | 10000 | OK
WR32 | DSI_PRESP_HSR_COUNT | 0340 | 00010000 |  |  | DSI_PRESP_HSR Count (Hex 0x0~0xFFFFFFFF) |  |  | 10000 | OK
WR32 | DSI_PRESP_HSW_COUNT | 0344 | 00010000 |  |  | DSI_PRESP_HSW Count (Hex 0x0~0xFFFFFFFF) |  |  | 10000 | OK
WR32 | DSI_PR_TO_COUNT | 0348 | 00001000 |  |  | DSI_PR_TO Count (Hex 0x0~0xFFFFFFFF) |  |  | 1000 | OK
WR32 | DSI_LRX-H_TO_COUNT | 034C | 00010000 |  |  | DSI_LRX-H TO Count (Hex 0x0~0xFFFFFFFF) |  |  | 10000 | OK
WR32 | FUNC_MODE | 0350 | 00000160 |  |  |  |  |  |  | Clk Force Stop[10] | Keep Operation | Contension Chk[9] | Enable | ECC Err Chk[8] | Disable | CRC Err Chk[6] | Disable | HS clk Md[5] | Continuous | Add EoT[0] | No
WR32 | DSI_RX_VC_ENABLE | 0354 | 00000001 |  |  |  |  |  |  |  |  |  |  | Receive VC3[3] | Disable | Receive VC0[2] | Disable | Receive VC0[1] | Disable | Receive VC0[0] | Enable
WR32 | IND_TO_COUNT | 0358 | 000000C8 |  |  | IND TO Count (Hex 0x0~0xFFFFFFFF) |  |  | C8 | OK
REMnd | INIT_INT_MSK | 0364 | 00000015 |  |  |  |  |  |  |  |  |  |  |  |  | LPRX Cal Done[2] | Mask | VREG Cnt Done[1] | Mask | Line Init Done[0] | Mask
WR32 | DSI_HSYNC_STOP_COUNT | 0368 | 0000002A |  |  | DSI_HSYNC STOP Count (Hex 0x0~0xFFFF) |  |  | 002A | OK
WR32 | APF_VDELAYCNT | 0370 | 00000477
REMnd | APF_VC_CONFIG | 0378 | 00000001 |  |  |  |  |  |  |  |  |  |  |  |  |  |  | VC Setting[2:1] | 0 | VC Select[0] | By Reg
WR32 | DSI_TX_MODE | 037C | 00000081
WR32 | DSI_HSYNC_WIDTH | 038C | 00000001
WR32 | DSI_HBPR | 0390 | 00000104
WR32 | DSI_RX_STATE_INT_MASK | 03A4 | 00000000 |  |  |  |  |  |  |  |  | LPRX Pkt Start[4] | No Mask | LPRX Pkt Done[3] | No Mask | LPRX Th Hit[2] | No Mask | Direction Fall[1] | No Mask | Direction Rise[0] | No Mask
REMnd | DSI_RXTRG_INT_MASK | 03AC | 00000000 |  |  |  |  |  |  |  |  |  |  | L0RX Trg3[3] | No Mask | L0RX Trg2[2] | No Mask | L0RX Trg1[1] | No Mask | L0RX Trg0[0] | No Mask
WR32 | DSI_LPRX_THRESH_COUNT | 03C0 | 00000015 |  |  | DSI_LPRX Threshold Count (Hex 0x0~0x1F) |  |  | 15 | OK
REMnd | DSI_PRTO_INT_MASK | 040C | 00000000 |  |  |  |  |  |  |  |  |  |  | Peri Resp TO[3] | No Mask |  |  | HSTX TO[1] | No Mask
WR32 | APP_SIDE_ERR_INT_MASK | 0414 | 00000000 |  |  | Ind Wrong Err[9] | No Mask | Line Buf RW Err[8] | No Mask | RX Buf OVF[6] | No Mask | Sync Buf OVF[4] | No Mask | Ind Buf OVF[3] | No Mask | Line Buf OVF[2] | No Mask | Err WC[1] | No Mask | Err Data Type[0] | No Mask
WR32 | DSI_RX_ERR_INT_MASK | 041C | 00000080 |  |  | Err Report Mask[13:3] |  | No Mask | No Mask | No Mask | No Mask | No Mask | No Mask | Mask | No Mask |  | No Mask | No Mask
WR32 | DSI_LPTX_INT_MASK | 0424 | 00000000 |  |  |  |  |  |  | Payload1 Done[9] | No Mask | Payload0 Done[8] | No Mask |  |  |  |  |  |  | LPTX Done[0] | No Mask
REMnd | DPHY_DLYCNTRL | 0440 | 00000000 |  |  |  |  |  |  |  |  | DLY Sel CL[19:16] | 0 | DLY Sel D3[15:12] | 0 | DLY Sel D2[11:8] | 0 | DLY Sel D1[7:4] | 0 | DLY Sel D0[3:0] | 0
WR32 | LPTXTIMECNT | 0454 | 00000006
WR32 | TCLK_HEADERCNT | 0458 | 00240204
WR32 | TCLK_TRAILCNT | 045C | 000D0008
WR32 | THS_HEADERCNT | 0460 | 00140006
WR32 | TWAKEUPCNT | 0464 | 00004268
WR32 | TCLK_POSTCNT | 0468 | 0000000F
WR32 | THS_TRAILCNT | 046C | 000D0008
WR32 | HSTXVREGCNT | 0470 | 00000020
WR32 | HSTXVREGEN | 0474 | 0000001F
WR32 | BTA_COUNT | 0478 | 00060005
WR32 | DPHY_TX ADJUST | 047C | 00000002 |  |  |  |  |  |  |  |  | CLLPTX Cur[9:8] | No Add | D3LPTX Cur[7:6] | No Add | D2LPTX Cur[5:4] | No Add | D1LPTX Cur[3:2] | No Add | D0LPTX Cur[1:0] | 25% Add
REMnd | DPHY_CAP | 0488 | 00000000 |  |  |  |  |  |  |  |  | CAP Sel CL[9:8] | 0 | CAP Sel D3[7:6] | 0 | CAP Sel D2[5:4] | 0 | CAP Sel D1[3:2] | 0 | CAP Sel D0[1:0] | 0
WR32 | DSITX_START | 031C | 00000001
REM | DSI-TX0 Transition Timing
WR32 | DSI_TX_CLKEN | 0108 | 00000001
WR32 | DSI_TX_CLKSEL | 010C | 00000001 |  |  |  |  |  |  | SYSDTclk[11:10] | HSCK/8 | SYSCLclk[9:8] | HSCK/8 |  |  |  |  |  |  | HSTXclk_enb[0] | Enable
WR32 | MIPI_PLL_CONTROL | 02A0 | 00000001
WR32 | MIPI_PLL_CNF | 02AC | 000090BD | Program PLL for DSI-TX0
delay |  | 1000
WR32 | MIPI_PLL_CONTROL | 02A0 | 00000003
WR32 | LANE_ENABLE | 0118 | 00000014
WR32 | LINE_INIT_COUNT | 0120 | 00001770
WR32 | HSTX_TO_COUNT | 0124 | 00000000 |  |  | HSTX TO Count (Hex 0x0~0xFFFFFFFF) |  |  | 0 | OK
WR32 | FUNC_ENABLE | 0128 | 00000101 |  |  |  |  |  |  | INIT Int Dis | ApErrInt Dis | DSIPrto Inte Dis | DSIrErr Int Dis | DSILPTX Int Dis | DSIrTrg Int Dis | DSIrStat Int Dis | PR_TO Dis | HSTX_TO Dis | IND_TO Dis | INDMdSel Reg | VHDELAY Reg
REMnd | DSI_LPTX_MODE | 012C | 00000000 |  |  |  |  |  |  |  |  |  |  |  | Specified Line Number(0~8191) | OK | 0 | Output Tim[2:1] | VFP | Cmd from[0] | Input
WR32 | DSI_TATO_COUNT | 0130 | 00010000 |  |  | TA TO Count (Hex 0x0~0xFFFFFFFF) |  |  | 10000 | OK
WR32 | DSI_PRESP_BTA_COUNT | 0134 | 00005000 |  |  | DSI_RRESP_BTA Count (Hex 0x0~0xFFFFFFFF) |  |  | 5000 | OK
WR32 | DSI_PRESP_LPR_COUNT | 0138 | 00010000 |  |  | DSI_PRESP_LPR Count (Hex 0x0~0xFFFFFFFF) |  |  | 10000 | OK
WR32 | DSI_PRESP_LPW_COUNT | 013C | 00010000 |  |  | DSI_PRESP_LPW Count (Hex 0x0~0xFFFFFFFF) |  |  | 10000 | OK
WR32 | DSI_PRESP_HSR_COUNT | 0140 | 00010000 |  |  | DSI_PRESP_HSR Count (Hex 0x0~0xFFFFFFFF) |  |  | 10000 | OK
WR32 | DSI_PRESP_HSW_COUNT | 0144 | 00010000 |  |  | DSI_PRESP_HSW Count (Hex 0x0~0xFFFFFFFF) |  |  | 10000 | OK
WR32 | DSI_PR_TO_COUNT | 0148 | 00001000 |  |  | DSI_PR_TO Count (Hex 0x0~0xFFFFFFFF) |  |  | 1000 | OK
WR32 | DSI_LRX-H_TO_COUNT | 014C | 00010000 |  |  | DSI_LRX-H TO Count (Hex 0x0~0xFFFFFFFF) |  |  | 10000 | OK
WR32 | FUNC_MODE | 0150 | 00000160 |  |  |  |  |  |  | Clk Force Stop[10] | Keep Operation | Contension Chk[9] | Enable | ECC Err Chk[8] | Disable | CRC Err Chk[6] | Disable | HS clk Md[5] | Continuous | Add EoT[0] | No
WR32 | DSI_RX_VC_ENABLE | 0154 | 00000001 |  |  |  |  |  |  |  |  |  |  | Receive VC3[3] | Disable | Receive VC0[2] | Disable | Receive VC0[1] | Disable | Receive VC0[0] | Enable
WR32 | IND_TO_COUNT | 0158 | 000000C8 |  |  | IND TO Count (Hex 0x0~0xFFFFFFFF) |  |  | C8 | OK
REMnd | INIT_INT_MSK | 0164 | 00000014 |  |  |  |  |  |  |  |  |  |  |  |  | LPRX Cal Done[2] | Mask | VREG Cnt Done[1] | Mask | Line Init Done[0] | No Mask
WR32 | DSI_HSYNC_STOP_COUNT | 0168 | 0000002A |  |  | DSI_HSYNC STOP Count (Hex 0x0~0xFFFF) |  |  | 002A | OK
WR32 | APF_VDELAYCNT | 0170 | 00000477
REMnd | APF_VC_CONFIG | 0178 | 00000001 |  |  |  |  |  |  |  |  |  |  |  |  |  |  | VC Setting[2:1] | 0 | VC Select[0] | By Reg
WR32 | DSI_TX_MODE | 017C | 00000081
WR32 | DSI_HSYNC_WIDTH | 018C | 00000001
WR32 | DSI_HBPR | 0190 | 00000104
WR32 | DSI_RX_STATE_INT_MASK | 01A4 | 00000000 |  |  |  |  |  |  |  |  | LPRX Pkt Start[4] | No Mask | LPRX Pkt Done[3] | No Mask | LPRX Th Hit[2] | No Mask | Direction Fall[1] | No Mask | Direction Rise[0] | No Mask
REMnd | DSI_RXTRG_INT_MASK | 01AC | 00000000 |  |  |  |  |  |  |  |  |  |  | L0RX Trg3[3] | No Mask | L0RX Trg2[2] | No Mask | L0RX Trg1[1] | No Mask | L0RX Trg0[0] | No Mask
WR32 | DSI_LPRX_THRESH_COUNT | 01C0 | 00000015 |  |  | DSI_LPRX Threshold Count (Hex 0x0~0x1F) |  |  | 15 | OK
REMnd | DSI_PRTO_INT_MASK | 020C | 00000000 |  |  |  |  |  |  |  |  |  |  | Peri Resp TO[3] | No Mask |  |  | HSTX TO[1] | No Mask
WR32 | APP_SIDE_ERR_INT_MASK | 0214 | 00000000 |  |  | Ind Wrong Err[9] | No Mask | Line Buf RW Err[8] | No Mask | RX Buf OVF[6] | No Mask | Sync Buf OVF[4] | No Mask | Ind Buf OVF[3] | No Mask | Line Buf OVF[2] | No Mask | Err WC[1] | No Mask | Err Data Type[0] | No Mask
WR32 | DSI_RX_ERR_INT_MASK | 021C | 00000080 |  |  | Err Report Mask[13:3] |  | No Mask | No Mask | No Mask | No Mask | No Mask | No Mask | Mask | No Mask |  | No Mask | No Mask
WR32 | DSI_LPTX_INT_MASK | 0224 | 00000000 |  |  |  |  |  |  | Payload1 Done[9] | No Mask | Payload0 Done[8] | No Mask |  |  |  |  |  |  | LPTX Done[0] | No Mask
REMnd | DPHY_DLYCNTRL | 0240 | 00000000 |  |  |  |  |  |  |  |  | DLY Sel CL[19:16] | 0 | DLY Sel D3[15:12] | 0 | DLY Sel D2[11:8] | 0 | DLY Sel D1[7:4] | 0 | DLY Sel D0[3:0] | 0
WR32 | LPTXTIMECNT | 0254 | 00000006
WR32 | TCLK_HEADERCNT | 0258 | 00240204
WR32 | TCLK_TRAILCNT | 025C | 000D0008
WR32 | THS_HEADERCNT | 0260 | 00140006
WR32 | TWAKEUPCNT | 0264 | 00004268
WR32 | TCLK_POSTCNT | 0268 | 0000000F
WR32 | THS_TRAILCNT | 026C | 000D0008
WR32 | HSTXVREGCNT | 0270 | 00000020
WR32 | HSTXVREGEN | 0274 | 0000001F
WR32 | BTA_COUNT | 0278 | 00060005
WR32 | DPHY_TX ADJUST | 027C | 00000002 |  |  |  |  |  |  |  |  | CLLPTX Cur[9:8] | No Add | D3LPTX Cur[7:6] | No Add | D2LPTX Cur[5:4] | No Add | D1LPTX Cur[3:2] | No Add | D0LPTX Cur[1:0] | 25% Add
REMnd | DPHY_CAP | 0288 | 000002AA |  |  |  |  |  |  |  |  | CAP Sel CL[9:8] | 2 | CAP Sel D3[7:6] | 2 | CAP Sel D2[5:4] | 2 | CAP Sel D1[3:2] | 2 | CAP Sel D0[1:0] | 2
WR32 | DSITX_START | 011C | 00000001
REM | Command Transmission Before Video Start
WR32 | MODE_CONFIG | 0110 | 00000016 |  |  |  |  |  |  |  |  | DSI Cmd[4] | LP |  |  | HSYNC Pol[2] | L Active | VSYNC Pol[1] | L Active
WR32 | MODE_CONFIG | 0310 | 00000016 |  |  |  |  |  |  |  |  | DSI Cmd[4] | LP |  |  | HSYNC Pol[2] | L Active | VSYNC Pol[1] | L Active
REM | LCD Initialization
WR16 | CMD_SEL | 0500 | 0004
REM | Soft Reset
WR16 | DCSCMD_Q | 0504 | 0005
WR16 | DCSCMD_Q | 0504 | 0001
delay |  | 5000
REM | Set Pixel Format
WR16 | DCSCMD_Q | 0504 | 0015
WR16 | DCSCMD_Q | 0504 | 773A
delay |  | 200
REM | Set Column Address
WR16 | DCSCMD_Q | 0504 | 8039
WR16 | DCSCMD_Q | 0504 | 0005
WR16 | DCSCMD_Q | 0504 | 002A
WR16 | DCSCMD_Q | 0504 | 0400
WR16 | DCSCMD_Q | 0504 | 00FF
delay |  | 200
REM | Set Page Address
WR16 | DCSCMD_Q | 0504 | 8039
WR16 | DCSCMD_Q | 0504 | 0005
WR16 | DCSCMD_Q | 0504 | 002B
WR16 | DCSCMD_Q | 0504 | 0600
WR16 | DCSCMD_Q | 0504 | 003F
delay |  | 200
REM | Set Tear On
WR16 | DCSCMD_Q | 0504 | 0015
WR16 | DCSCMD_Q | 0504 | 0035
delay |  | 200
REM | Set Tear Scanline
WR16 | DCSCMD_Q | 0504 | 8039
WR16 | DCSCMD_Q | 0504 | 0003
WR16 | DCSCMD_Q | 0504 | 0044
WR16 | DCSCMD_Q | 0504 | 0000
delay |  | 200
REM | Write Display Brightness
WR16 | DCSCMD_Q | 0504 | 0015
WR16 | DCSCMD_Q | 0504 | FF51
delay |  | 200
REM | Write Control Display
WR16 | DCSCMD_Q | 0504 | 0015
WR16 | DCSCMD_Q | 0504 | 2453
delay |  | 200
REM | Adaptive Brightness Control
WR16 | DCSCMD_Q | 0504 | 0015
WR16 | DCSCMD_Q | 0504 | 0155
delay |  | 200
REM | Exit Sleep
WR16 | DCSCMD_Q | 0504 | 0005
WR16 | DCSCMD_Q | 0504 | 0011
delay |  | 120000
REM | MCAP
WR16 | DCSCMD_Q | 0504 | 0023
WR16 | DCSCMD_Q | 0504 | 00B0
delay |  | 200
REM | Backlight Control 4
WR16 | DCSCMD_Q | 0504 | 8029
WR16 | DCSCMD_Q | 0504 | 0014
WR16 | DCSCMD_Q | 0504 | 7DCE
WR16 | DCSCMD_Q | 0504 | 4840
WR16 | DCSCMD_Q | 0504 | 6756
WR16 | DCSCMD_Q | 0504 | 8878
WR16 | DCSCMD_Q | 0504 | A798
WR16 | DCSCMD_Q | 0504 | C3B5
WR16 | DCSCMD_Q | 0504 | DED1
WR16 | DCSCMD_Q | 0504 | F2E9
WR16 | DCSCMD_Q | 0504 | FFFA
WR16 | DCSCMD_Q | 0504 | 0004
REM | Split Control
WR16 | STX0_CTL | 5000 | 0000
WR16 | STX0_FPX | 500C | 8000
REMnd | STX0_LPX | 500E | 04FF
WR16 | STX1_CTL | 5080 | 0000
REMnd | STX1_FPX | 508C | 0500
REM | Color Bar Setting
WR16 | CB_CTL | 7000 | 000D
WR16 | CB_HSW | 7008 | 0020
WR16 | CB_VSW | 700A | 0006
WR16 | CB_Htotal | 700C | 0AA0
WR16 | CB_Vtotal | 700E | 066E
WR16 | CB_Hact | 7010 | 0A00
WR16 | CB_Vact | 7012 | 0640
WR16 | CB_Hstart | 7014 | 0070
WR16 | CB_Vstart | 7016 | 002B
REM | Start Video TX
WR16 | ConfCtl0 | 0004 | 0C37
REM | Command Transmission After Video Start. HS command TX
WR32 | MODE_CONFIG | 0110 | 00000006 |  |  |  |  |  |  |  |  | DSI Cmd[4] | HS |  |  | HSYNC Pol[2] | L Active | VSYNC Pol[1] | L Active
WR32 | MODE_CONFIG | 0310 | 00000006 |  |  |  |  |  |  |  |  | DSI Cmd[4] | HS |  |  | HSYNC Pol[2] | L Active | VSYNC Pol[1] | L Active
delay |  | 1000000
REM | MCAP
WR16 | DCSCMD_Q | 0504 | 0023
WR16 | DCSCMD_Q | 0504 | 00B0
delay |  | 200
REM | Interface Setting
WR16 | DCSCMD_Q | 0504 | 0023
WR16 | DCSCMD_Q | 0504 | 14B3
delay |  | 200
REM | MCAP
WR16 | DCSCMD_Q | 0504 | 0023
WR16 | DCSCMD_Q | 0504 | 03B0
delay |  | 200
REM | Set Display On
WR16 | DCSCMD_Q | 0504 | 0005
WR16 | DCSCMD_Q | 0504 | 0029
delay |  | 200
END

Sheet: Source_HDMITimChk
TC358870XBG HDMI input timing check |  |  |  |  | v02 | Title
Command Description WR8:8bit Write, WR16:16bit Write, WR32:32bit Write, delay:Wait (unit is "us") |  |  |  |  |  | TOSHIBA Confidential
HDMI input video timing check
CMD | Register Name | Address | Data | Comment
WR8 | SYS_FREQ0 | 8540 | C0 |  | 4800
WR8 | SYS_FREQ1 | 8541 | 12 |  | 4800
WR8 | SYS_FREQ0(CSC) | 8A0C | C0 |  | 4800
WR8 | SYS_FREQ1(CSC) | 8A0D | 12 |  | 4800
REM | HDMI Input Video Timing Check (PCLK) |  |  |  |  | Pixel Clock(MHz)
RD8 | PX_FREQ0 | 8405 | 40 | PX_FREQ[7:0] |  | Rough value
RD8 | PX_FREQ1 | 8406 | 07 | PX_FREQ[12:8] |  | 148.48
REM | HDMI Input Video Timing Check (Horizontal Related) |  |  |  |  | H total(pixel)
RD8 | H_SIZE0 | 858E | 98 | H_SIZE[7:0] |  | 2200
RD8 | H_SIZE1 | 858F | 08 | H_SIZE[12:8] |  | HPW+HBP(pixel)
RD8 | DE_HPOS0 | 8580 | C1 | DE_HPOS[7:0] |  | 192
RD8 | DE_HPOS1 | 8581 | 00 | DE_HPOS[12:8] |  | HDP(pixel)
RD8 | DE_HWID0 | 8582 | 80 | DE_HWID[7:0] |  | 1920
RD8 | DE_HWID1 | 8583 | 07 | DE_HWID[12:8] |  | HFP(pixel)
REM | HDMI Input Video Timing Check (Vertical Related) |  |  |  |  | 88
RD8 | V_SIZE0 | 8590 | CA | V_SIZE[7:0] |  | V total(line)
RD8 | V_SIZE1 | 8591 | 08 | V_SIZE[12:8] |  | 1125
RD8 | DE_POS_A0 | 8584 | 2A | DE_VPOS_A[7:0] |  | VPW+VBP(line)
RD8 | DE_POS_A1 | 8585 | 00 | DE_VPOS_A[12:8] |  | 41
RD8 | DE_POS_B0 | 8586 | 2A | DE_VPOS_B[7:0] |  | VDP(line)
RD8 | DE_POS_B1 | 8587 | 00 | DE_VPOS_B[12:8] |  | 1080
RD8 | DE_VWID0 | 858C | 38 | DE_VWID[7:0] |  | VFP(line)
RD8 | DE_VWID1 | 858D | 04 | DE_VWID[12:8] |  | 4
REM | HDMI Input Video Timing Check (VSYNC,HSYNC Porarity) |  |  |  |  | VSYNC Polarity | HSYNC Polarity
RD8 | VI_STATUS1 | 8526 | 08 | VI_STATUS1[5:4] |  | Low Active | High Active
END

Sheet: Code
// Software Reset
i2c1_h2d_write16(0x0004,0x0004); // ConfCtl0
i2c1_h2d_write16(0x0002,0x3F01); // SysCtl
i2c1_h2d_write16(0x0002,0x0000); // SysCtl
i2c1_h2d_write16(0x0006,0x0008); // ConfCtl1
// DSI-TX0 Transition Timing
i2c1_h2d_write32(0x0108,0x00000001); // DSI_TX_CLKEN
i2c1_h2d_write32(0x010C,0x00000001); // DSI_TX_CLKSEL
i2c1_h2d_write32(0x02A0,0x00000001); // MIPI_PLL_CONTROL
i2c1_h2d_write32(0x02AC,0x000090BD); // MIPI_PLL_CNF
Waitx1us();
i2c1_h2d_write32(0x02A0,0x00000003); // MIPI_PLL_CONTROL
i2c1_h2d_write32(0x0118,0x00000014); // LANE_ENABLE
i2c1_h2d_write32(0x0120,0x00001770); // LINE_INIT_COUNT
i2c1_h2d_write32(0x0124,0x00000000); // HSTX_TO_COUNT
i2c1_h2d_write32(0x0128,0x00000101); // FUNC_ENABLE
i2c1_h2d_write32(0x0130,0x00010000); // DSI_TATO_COUNT
i2c1_h2d_write32(0x0134,0x00005000); // DSI_PRESP_BTA_COUNT
i2c1_h2d_write32(0x0138,0x00010000); // DSI_PRESP_LPR_COUNT
i2c1_h2d_write32(0x013C,0x00010000); // DSI_PRESP_LPW_COUNT
i2c1_h2d_write32(0x0140,0x00010000); // DSI_PRESP_HSR_COUNT
i2c1_h2d_write32(0x0144,0x00010000); // DSI_PRESP_HSW_COUNT
i2c1_h2d_write32(0x0148,0x00001000); // DSI_PR_TO_COUNT
i2c1_h2d_write32(0x014C,0x00010000); // DSI_LRX-H_TO_COUNT
i2c1_h2d_write32(0x0150,0x00000160); // FUNC_MODE
i2c1_h2d_write32(0x0154,0x00000001); // DSI_RX_VC_ENABLE
i2c1_h2d_write32(0x0158,0x000000C8); // IND_TO_COUNT
i2c1_h2d_write32(0x0168,0x0000002A); // DSI_HSYNC_STOP_COUNT
i2c1_h2d_write32(0x0170,0x00000677); // APF_VDELAYCNT
i2c1_h2d_write32(0x017C,0x00000081); // DSI_TX_MODE
i2c1_h2d_write32(0x018C,0x00000001); // DSI_HSYNC_WIDTH
i2c1_h2d_write32(0x0190,0x00000104); // DSI_HBPR
i2c1_h2d_write32(0x01A4,0x00000000); // DSI_RX_STATE_INT_MASK
i2c1_h2d_write32(0x01C0,0x00000015); // DSI_LPRX_THRESH_COUNT
i2c1_h2d_write32(0x0214,0x00000000); // APP_SIDE_ERR_INT_MASK
i2c1_h2d_write32(0x021C,0x00000080); // DSI_RX_ERR_INT_MASK
i2c1_h2d_write32(0x0224,0x00000000); // DSI_LPTX_INT_MASK
i2c1_h2d_write32(0x0254,0x00000006); // LPTXTIMECNT
i2c1_h2d_write32(0x0258,0x00240204); // TCLK_HEADERCNT
i2c1_h2d_write32(0x025C,0x000D0008); // TCLK_TRAILCNT
i2c1_h2d_write32(0x0260,0x00140006); // THS_HEADERCNT
i2c1_h2d_write32(0x0264,0x00004268); // TWAKEUPCNT
i2c1_h2d_write32(0x0268,0x0000000F); // TCLK_POSTCNT
i2c1_h2d_write32(0x026C,0x000D0008); // THS_TRAILCNT
i2c1_h2d_write32(0x0270,0x00000020); // HSTXVREGCNT
i2c1_h2d_write32(0x0274,0x0000001F); // HSTXVREGEN
i2c1_h2d_write32(0x0278,0x00060005); // BTA_COUNT
i2c1_h2d_write32(0x027C,0x00000002); // DPHY_TX ADJUST
i2c1_h2d_write32(0x011C,0x00000001); // DSITX_START
// DSI-TX1 Transition Timing
i2c1_h2d_write32(0x0308,0x00000001); // DSI_TX_CLKEN
i2c1_h2d_write32(0x030C,0x00000001); // DSI_TX_CLKSEL
i2c1_h2d_write32(0x04A0,0x00000001); // MIPI_PLL_CONTROL
i2c1_h2d_write32(0x04AC,0x000090BD); // MIPI_PLL_CNF
Waitx1us();
i2c1_h2d_write32(0x04A0,0x00000003); // MIPI_PLL_CONTROL
i2c1_h2d_write32(0x0318,0x00000014); // LANE_ENABLE
i2c1_h2d_write32(0x0320,0x00001770); // LINE_INIT_COUNT
i2c1_h2d_write32(0x0324,0x00000000); // HSTX_TO_COUNT
i2c1_h2d_write32(0x0328,0x00000101); // FUNC_ENABLE
i2c1_h2d_write32(0x0330,0x00010000); // DSI_TATO_COUNT
i2c1_h2d_write32(0x0334,0x00005000); // DSI_PRESP_BTA_COUNT
i2c1_h2d_write32(0x0338,0x00010000); // DSI_PRESP_LPR_COUNT
i2c1_h2d_write32(0x033C,0x00010000); // DSI_PRESP_LPW_COUNT
i2c1_h2d_write32(0x0340,0x00010000); // DSI_PRESP_HSR_COUNT
i2c1_h2d_write32(0x0344,0x00010000); // DSI_PRESP_HSW_COUNT
i2c1_h2d_write32(0x0348,0x00001000); // DSI_PR_TO_COUNT
i2c1_h2d_write32(0x034C,0x00010000); // DSI_LRX-H_TO_COUNT
i2c1_h2d_write32(0x0350,0x00000160); // FUNC_MODE
i2c1_h2d_write32(0x0354,0x00000001); // DSI_RX_VC_ENABLE
i2c1_h2d_write32(0x0358,0x000000C8); // IND_TO_COUNT
i2c1_h2d_write32(0x0368,0x0000002A); // DSI_HSYNC_STOP_COUNT
i2c1_h2d_write32(0x0370,0x00000677); // APF_VDELAYCNT
i2c1_h2d_write32(0x037C,0x00000081); // DSI_TX_MODE
i2c1_h2d_write32(0x038C,0x00000001); // DSI_HSYNC_WIDTH
i2c1_h2d_write32(0x0390,0x00000104); // DSI_HBPR
i2c1_h2d_write32(0x03A4,0x00000000); // DSI_RX_STATE_INT_MASK
i2c1_h2d_write32(0x03C0,0x00000015); // DSI_LPRX_THRESH_COUNT
i2c1_h2d_write32(0x0414,0x00000000); // APP_SIDE_ERR_INT_MASK
i2c1_h2d_write32(0x041C,0x00000080); // DSI_RX_ERR_INT_MASK
i2c1_h2d_write32(0x0424,0x00000000); // DSI_LPTX_INT_MASK
i2c1_h2d_write32(0x0454,0x00000006); // LPTXTIMECNT
i2c1_h2d_write32(0x0458,0x00240204); // TCLK_HEADERCNT
i2c1_h2d_write32(0x045C,0x000D0008); // TCLK_TRAILCNT
i2c1_h2d_write32(0x0460,0x00140006); // THS_HEADERCNT
i2c1_h2d_write32(0x0464,0x00004268); // TWAKEUPCNT
i2c1_h2d_write32(0x0468,0x0000000F); // TCLK_POSTCNT
i2c1_h2d_write32(0x046C,0x000D0008); // THS_TRAILCNT
i2c1_h2d_write32(0x0470,0x00000020); // HSTXVREGCNT
i2c1_h2d_write32(0x0474,0x0000001F); // HSTXVREGEN
i2c1_h2d_write32(0x0478,0x00060005); // BTA_COUNT
i2c1_h2d_write32(0x047C,0x00000002); // DPHY_TX ADJUST
i2c1_h2d_write32(0x031C,0x00000001); // DSITX_START
// Command Transmission Before Video Start
i2c1_h2d_write32(0x0110,0x00000016); // MODE_CONFIG
i2c1_h2d_write32(0x0310,0x00000016); // MODE_CONFIG
// LCD Initialization
i2c1_h2d_write16(0x0500,0x0004); // CMD_SEL
// Soft Reset
i2c1_h2d_write16(0x0504,0x0005); // DCSCMD_Q
i2c1_h2d_write16(0x0504,0x0001); // DCSCMD_Q
Waitx1us();
// Set Pixel Format
i2c1_h2d_write16(0x0504,0x0015); // DCSCMD_Q
i2c1_h2d_write16(0x0504,0x773A); // DCSCMD_Q
Waitx1us();
// Set Column Address
i2c1_h2d_write16(0x0504,0x8039); // DCSCMD_Q
i2c1_h2d_write16(0x0504,0x0005); // DCSCMD_Q
i2c1_h2d_write16(0x0504,0x002A); // DCSCMD_Q
i2c1_h2d_write16(0x0504,0x0400); // DCSCMD_Q
i2c1_h2d_write16(0x0504,0x00FF); // DCSCMD_Q
Waitx1us();
// Set Page Address
i2c1_h2d_write16(0x0504,0x8039); // DCSCMD_Q
i2c1_h2d_write16(0x0504,0x0005); // DCSCMD_Q
i2c1_h2d_write16(0x0504,0x002B); // DCSCMD_Q
i2c1_h2d_write16(0x0504,0x0600); // DCSCMD_Q
i2c1_h2d_write16(0x0504,0x003F); // DCSCMD_Q
Waitx1us();
// Set Tear On
i2c1_h2d_write16(0x0504,0x0015); // DCSCMD_Q
i2c1_h2d_write16(0x0504,0x0035); // DCSCMD_Q
Waitx1us();
// Set Tear Scanline
i2c1_h2d_write16(0x0504,0x8039); // DCSCMD_Q
i2c1_h2d_write16(0x0504,0x0003); // DCSCMD_Q
i2c1_h2d_write16(0x0504,0x0044); // DCSCMD_Q
i2c1_h2d_write16(0x0504,0x0000); // DCSCMD_Q
Waitx1us();
// Write Display Brightness
i2c1_h2d_write16(0x0504,0x0015); // DCSCMD_Q
i2c1_h2d_write16(0x0504,0xFF51); // DCSCMD_Q
Waitx1us();
// Write Control Display
i2c1_h2d_write16(0x0504,0x0015); // DCSCMD_Q
i2c1_h2d_write16(0x0504,0x2453); // DCSCMD_Q
Waitx1us();
// Adaptive Brightness Control
i2c1_h2d_write16(0x0504,0x0015); // DCSCMD_Q
i2c1_h2d_write16(0x0504,0x0155); // DCSCMD_Q
Waitx1us();
// Exit Sleep
i2c1_h2d_write16(0x0504,0x0005); // DCSCMD_Q
i2c1_h2d_write16(0x0504,0x0011); // DCSCMD_Q
Waitx1us();
// MCAP
i2c1_h2d_write16(0x0504,0x0023); // DCSCMD_Q
i2c1_h2d_write16(0x0504,0x00B0); // DCSCMD_Q
Waitx1us();
// Backlight Control 4
i2c1_h2d_write16(0x0504,0x8029); // DCSCMD_Q
i2c1_h2d_write16(0x0504,0x0014); // DCSCMD_Q
i2c1_h2d_write16(0x0504,0x7DCE); // DCSCMD_Q
i2c1_h2d_write16(0x0504,0x4840); // DCSCMD_Q
i2c1_h2d_write16(0x0504,0x6756); // DCSCMD_Q
i2c1_h2d_write16(0x0504,0x8878); // DCSCMD_Q
i2c1_h2d_write16(0x0504,0xA798); // DCSCMD_Q
i2c1_h2d_write16(0x0504,0xC3B5); // DCSCMD_Q
i2c1_h2d_write16(0x0504,0xDED1); // DCSCMD_Q
i2c1_h2d_write16(0x0504,0xF2E9); // DCSCMD_Q
i2c1_h2d_write16(0x0504,0xFFFA); // DCSCMD_Q
i2c1_h2d_write16(0x0504,0x0004); // DCSCMD_Q
// Split Control
i2c1_h2d_write16(0x5000,0x0100); // STX0_CTL
i2c1_h2d_write16(0x500C,0x8000); // STX0_FPX
i2c1_h2d_write16(0x5080,0x0100); // STX1_CTL
// HDMI PHY
i2c1_h2d_write8(0x8410,0x03); // PHY CTL
i2c1_h2d_write8(0x8413,0x3F); // PHY_ENB
i2c1_h2d_write8(0x84F0,0x31); // APLL_CTL
i2c1_h2d_write8(0x84F4,0x01); // DDCIO_CTL
// HDMI Clock
i2c1_h2d_write16(0x8540,0x12C0); // SYS_FREQ0_1
i2c1_h2d_write8(0x8630,0x00); // LOCKDET_FREQ0
i2c1_h2d_write16(0x8631,0x0753); // LOCKDET_REF1_2
i2c1_h2d_write8(0x8670,0x02); // NCO_F0_MOD
i2c1_h2d_write16(0x8A0C,0x12C0); // CSC_SCLK0_1
// HDMI Interrupt Mask, Clear
i2c1_h2d_write8(0x8502,0xFF); // SYS_INT
i2c1_h2d_write8(0x8512,0xFE); // SYS_INTM
// Interrupt Control (TOP level)
i2c1_h2d_write16(0x0014,0x0FBF); // IntStatus
i2c1_h2d_write16(0x0016,0x0DBF); // IntMask
// EDID
i2c1_h2d_write8(0x85E0,0x01); // EDID_MODE
i2c1_h2d_write16(0x85E3,0x0100); // EDID_LEN1_2
// EDID Data
i2c1_h2d_write8(0x8C00,0x00); // EDID_RAM
i2c1_h2d_write8(0x8C01,0xFF); // EDID_RAM
i2c1_h2d_write8(0x8C02,0xFF); // EDID_RAM
i2c1_h2d_write8(0x8C03,0xFF); // EDID_RAM
i2c1_h2d_write8(0x8C04,0xFF); // EDID_RAM
i2c1_h2d_write8(0x8C05,0xFF); // EDID_RAM
i2c1_h2d_write8(0x8C06,0xFF); // EDID_RAM
i2c1_h2d_write8(0x8C07,0x00); // EDID_RAM
i2c1_h2d_write8(0x8C08,0x52); // EDID_RAM
i2c1_h2d_write8(0x8C09,0x62); // EDID_RAM
i2c1_h2d_write8(0x8C0A,0x88); // EDID_RAM
i2c1_h2d_write8(0x8C0B,0x88); // EDID_RAM
i2c1_h2d_write8(0x8C0C,0x00); // EDID_RAM
i2c1_h2d_write8(0x8C0D,0x88); // EDID_RAM
i2c1_h2d_write8(0x8C0E,0x88); // EDID_RAM
i2c1_h2d_write8(0x8C0F,0x88); // EDID_RAM
i2c1_h2d_write8(0x8C10,0x1C); // EDID_RAM
i2c1_h2d_write8(0x8C11,0x15); // EDID_RAM
i2c1_h2d_write8(0x8C12,0x01); // EDID_RAM
i2c1_h2d_write8(0x8C13,0x03); // EDID_RAM
i2c1_h2d_write8(0x8C14,0x80); // EDID_RAM
i2c1_h2d_write8(0x8C15,0x00); // EDID_RAM
i2c1_h2d_write8(0x8C16,0x00); // EDID_RAM
i2c1_h2d_write8(0x8C17,0x78); // EDID_RAM
i2c1_h2d_write8(0x8C18,0x0A); // EDID_RAM
i2c1_h2d_write8(0x8C19,0x0D); // EDID_RAM
i2c1_h2d_write8(0x8C1A,0xC9); // EDID_RAM
i2c1_h2d_write8(0x8C1B,0xA0); // EDID_RAM
i2c1_h2d_write8(0x8C1C,0x57); // EDID_RAM
i2c1_h2d_write8(0x8C1D,0x47); // EDID_RAM
i2c1_h2d_write8(0x8C1E,0x98); // EDID_RAM
i2c1_h2d_write8(0x8C1F,0x27); // EDID_RAM
i2c1_h2d_write8(0x8C20,0x12); // EDID_RAM
i2c1_h2d_write8(0x8C21,0x48); // EDID_RAM
i2c1_h2d_write8(0x8C22,0x4C); // EDID_RAM
i2c1_h2d_write8(0x8C23,0x00); // EDID_RAM
i2c1_h2d_write8(0x8C24,0x00); // EDID_RAM
i2c1_h2d_write8(0x8C25,0x00); // EDID_RAM
i2c1_h2d_write8(0x8C26,0x01); // EDID_RAM
i2c1_h2d_write8(0x8C27,0x01); // EDID_RAM
i2c1_h2d_write8(0x8C28,0x01); // EDID_RAM
i2c1_h2d_write8(0x8C29,0x01); // EDID_RAM
i2c1_h2d_write8(0x8C2A,0x01); // EDID_RAM
i2c1_h2d_write8(0x8C2B,0x01); // EDID_RAM
i2c1_h2d_write8(0x8C2C,0x01); // EDID_RAM
i2c1_h2d_write8(0x8C2D,0x01); // EDID_RAM
i2c1_h2d_write8(0x8C2E,0x01); // EDID_RAM
i2c1_h2d_write8(0x8C2F,0x01); // EDID_RAM
i2c1_h2d_write8(0x8C30,0x01); // EDID_RAM
i2c1_h2d_write8(0x8C31,0x01); // EDID_RAM
i2c1_h2d_write8(0x8C32,0x01); // EDID_RAM
i2c1_h2d_write8(0x8C33,0x01); // EDID_RAM
i2c1_h2d_write8(0x8C34,0x01); // EDID_RAM
i2c1_h2d_write8(0x8C35,0x01); // EDID_RAM
i2c1_h2d_write8(0x8C36,0xEC); // EDID_RAM
i2c1_h2d_write8(0x8C37,0x68); // EDID_RAM
i2c1_h2d_write8(0x8C38,0x00); // EDID_RAM
i2c1_h2d_write8(0x8C39,0xA0); // EDID_RAM
i2c1_h2d_write8(0x8C3A,0xA0); // EDID_RAM
i2c1_h2d_write8(0x8C3B,0x40); // EDID_RAM
i2c1_h2d_write8(0x8C3C,0x2E); // EDID_RAM
i2c1_h2d_write8(0x8C3D,0x60); // EDID_RAM
i2c1_h2d_write8(0x8C3E,0x30); // EDID_RAM
i2c1_h2d_write8(0x8C3F,0x20); // EDID_RAM
i2c1_h2d_write8(0x8C40,0x36); // EDID_RAM
i2c1_h2d_write8(0x8C41,0x00); // EDID_RAM
i2c1_h2d_write8(0x8C42,0x00); // EDID_RAM
i2c1_h2d_write8(0x8C43,0x40); // EDID_RAM
i2c1_h2d_write8(0x8C44,0xA6); // EDID_RAM
i2c1_h2d_write8(0x8C45,0x00); // EDID_RAM
i2c1_h2d_write8(0x8C46,0x00); // EDID_RAM
i2c1_h2d_write8(0x8C47,0x18); // EDID_RAM
i2c1_h2d_write8(0x8C48,0xEC); // EDID_RAM
i2c1_h2d_write8(0x8C49,0x68); // EDID_RAM
i2c1_h2d_write8(0x8C4A,0x00); // EDID_RAM
i2c1_h2d_write8(0x8C4B,0xA0); // EDID_RAM
i2c1_h2d_write8(0x8C4C,0xA0); // EDID_RAM
i2c1_h2d_write8(0x8C4D,0x40); // EDID_RAM
i2c1_h2d_write8(0x8C4E,0x2E); // EDID_RAM
i2c1_h2d_write8(0x8C4F,0x60); // EDID_RAM
i2c1_h2d_write8(0x8C50,0x30); // EDID_RAM
i2c1_h2d_write8(0x8C51,0x20); // EDID_RAM
i2c1_h2d_write8(0x8C52,0x36); // EDID_RAM
i2c1_h2d_write8(0x8C53,0x00); // EDID_RAM
i2c1_h2d_write8(0x8C54,0x00); // EDID_RAM
i2c1_h2d_write8(0x8C55,0x40); // EDID_RAM
i2c1_h2d_write8(0x8C56,0xA6); // EDID_RAM
i2c1_h2d_write8(0x8C57,0x00); // EDID_RAM
i2c1_h2d_write8(0x8C58,0x00); // EDID_RAM
i2c1_h2d_write8(0x8C59,0x18); // EDID_RAM
i2c1_h2d_write8(0x8C5A,0x00); // EDID_RAM
i2c1_h2d_write8(0x8C5B,0x00); // EDID_RAM
i2c1_h2d_write8(0x8C5C,0x00); // EDID_RAM
i2c1_h2d_write8(0x8C5D,0xFC); // EDID_RAM
i2c1_h2d_write8(0x8C5E,0x00); // EDID_RAM
i2c1_h2d_write8(0x8C5F,0x54); // EDID_RAM
i2c1_h2d_write8(0x8C60,0x6F); // EDID_RAM
i2c1_h2d_write8(0x8C61,0x73); // EDID_RAM
i2c1_h2d_write8(0x8C62,0x68); // EDID_RAM
i2c1_h2d_write8(0x8C63,0x69); // EDID_RAM
i2c1_h2d_write8(0x8C64,0x62); // EDID_RAM
i2c1_h2d_write8(0x8C65,0x61); // EDID_RAM
i2c1_h2d_write8(0x8C66,0x2D); // EDID_RAM
i2c1_h2d_write8(0x8C67,0x55); // EDID_RAM
i2c1_h2d_write8(0x8C68,0x48); // EDID_RAM
i2c1_h2d_write8(0x8C69,0x32); // EDID_RAM
i2c1_h2d_write8(0x8C6A,0x44); // EDID_RAM
i2c1_h2d_write8(0x8C6B,0x0A); // EDID_RAM
i2c1_h2d_write8(0x8C6C,0x00); // EDID_RAM
i2c1_h2d_write8(0x8C6D,0x00); // EDID_RAM
i2c1_h2d_write8(0x8C6E,0x00); // EDID_RAM
i2c1_h2d_write8(0x8C6F,0xFD); // EDID_RAM
i2c1_h2d_write8(0x8C70,0x00); // EDID_RAM
i2c1_h2d_write8(0x8C71,0x17); // EDID_RAM
i2c1_h2d_write8(0x8C72,0x3D); // EDID_RAM
i2c1_h2d_write8(0x8C73,0x0F); // EDID_RAM
i2c1_h2d_write8(0x8C74,0x8C); // EDID_RAM
i2c1_h2d_write8(0x8C75,0x17); // EDID_RAM
i2c1_h2d_write8(0x8C76,0x00); // EDID_RAM
i2c1_h2d_write8(0x8C77,0x0A); // EDID_RAM
i2c1_h2d_write8(0x8C78,0x20); // EDID_RAM
i2c1_h2d_write8(0x8C79,0x20); // EDID_RAM
i2c1_h2d_write8(0x8C7A,0x20); // EDID_RAM
i2c1_h2d_write8(0x8C7B,0x20); // EDID_RAM
i2c1_h2d_write8(0x8C7C,0x20); // EDID_RAM
i2c1_h2d_write8(0x8C7D,0x20); // EDID_RAM
i2c1_h2d_write8(0x8C7E,0x01); // EDID_RAM
i2c1_h2d_write8(0x8C7F,0x40); // EDID_RAM
i2c1_h2d_write8(0x8C80,0x02); // EDID_RAM
i2c1_h2d_write8(0x8C81,0x03); // EDID_RAM
i2c1_h2d_write8(0x8C82,0x17); // EDID_RAM
i2c1_h2d_write8(0x8C83,0x74); // EDID_RAM
i2c1_h2d_write8(0x8C84,0x47); // EDID_RAM
i2c1_h2d_write8(0x8C85,0x4C); // EDID_RAM
i2c1_h2d_write8(0x8C86,0x4C); // EDID_RAM
i2c1_h2d_write8(0x8C87,0x4C); // EDID_RAM
i2c1_h2d_write8(0x8C88,0x4C); // EDID_RAM
i2c1_h2d_write8(0x8C89,0x4C); // EDID_RAM
i2c1_h2d_write8(0x8C8A,0x4C); // EDID_RAM
i2c1_h2d_write8(0x8C8B,0x4C); // EDID_RAM
i2c1_h2d_write8(0x8C8C,0x23); // EDID_RAM
i2c1_h2d_write8(0x8C8D,0x09); // EDID_RAM
i2c1_h2d_write8(0x8C8E,0x07); // EDID_RAM
i2c1_h2d_write8(0x8C8F,0x01); // EDID_RAM
i2c1_h2d_write8(0x8C90,0x66); // EDID_RAM
i2c1_h2d_write8(0x8C91,0x03); // EDID_RAM
i2c1_h2d_write8(0x8C92,0x0C); // EDID_RAM
i2c1_h2d_write8(0x8C93,0x00); // EDID_RAM
i2c1_h2d_write8(0x8C94,0x30); // EDID_RAM
i2c1_h2d_write8(0x8C95,0x00); // EDID_RAM
i2c1_h2d_write8(0x8C96,0x80); // EDID_RAM
i2c1_h2d_write8(0x8C97,0x8C); // EDID_RAM
i2c1_h2d_write8(0x8C98,0x0A); // EDID_RAM
i2c1_h2d_write8(0x8C99,0xD0); // EDID_RAM
i2c1_h2d_write8(0x8C9A,0xEC); // EDID_RAM
i2c1_h2d_write8(0x8C9B,0x68); // EDID_RAM
i2c1_h2d_write8(0x8C9C,0x00); // EDID_RAM
i2c1_h2d_write8(0x8C9D,0xA0); // EDID_RAM
i2c1_h2d_write8(0x8C9E,0xA0); // EDID_RAM
i2c1_h2d_write8(0x8C9F,0x40); // EDID_RAM
i2c1_h2d_write8(0x8CA0,0x2E); // EDID_RAM
i2c1_h2d_write8(0x8CA1,0x60); // EDID_RAM
i2c1_h2d_write8(0x8CA2,0x30); // EDID_RAM
i2c1_h2d_write8(0x8CA3,0x20); // EDID_RAM
i2c1_h2d_write8(0x8CA4,0x36); // EDID_RAM
i2c1_h2d_write8(0x8CA5,0x00); // EDID_RAM
i2c1_h2d_write8(0x8CA6,0x00); // EDID_RAM
i2c1_h2d_write8(0x8CA7,0x40); // EDID_RAM
i2c1_h2d_write8(0x8CA8,0xA6); // EDID_RAM
i2c1_h2d_write8(0x8CA9,0x00); // EDID_RAM
i2c1_h2d_write8(0x8CAA,0x00); // EDID_RAM
i2c1_h2d_write8(0x8CAB,0x18); // EDID_RAM
i2c1_h2d_write8(0x8CAC,0xEC); // EDID_RAM
i2c1_h2d_write8(0x8CAD,0x68); // EDID_RAM
i2c1_h2d_write8(0x8CAE,0x00); // EDID_RAM
i2c1_h2d_write8(0x8CAF,0xA0); // EDID_RAM
i2c1_h2d_write8(0x8CB0,0xA0); // EDID_RAM
i2c1_h2d_write8(0x8CB1,0x40); // EDID_RAM
i2c1_h2d_write8(0x8CB2,0x2E); // EDID_RAM
i2c1_h2d_write8(0x8CB3,0x60); // EDID_RAM
i2c1_h2d_write8(0x8CB4,0x30); // EDID_RAM
i2c1_h2d_write8(0x8CB5,0x20); // EDID_RAM
i2c1_h2d_write8(0x8CB6,0x36); // EDID_RAM
i2c1_h2d_write8(0x8CB7,0x00); // EDID_RAM
i2c1_h2d_write8(0x8CB8,0x00); // EDID_RAM
i2c1_h2d_write8(0x8CB9,0x40); // EDID_RAM
i2c1_h2d_write8(0x8CBA,0xA6); // EDID_RAM
i2c1_h2d_write8(0x8CBB,0x00); // EDID_RAM
i2c1_h2d_write8(0x8CBC,0x00); // EDID_RAM
i2c1_h2d_write8(0x8CBD,0x18); // EDID_RAM
i2c1_h2d_write8(0x8CBE,0xEC); // EDID_RAM
i2c1_h2d_write8(0x8CBF,0x68); // EDID_RAM
i2c1_h2d_write8(0x8CC0,0x00); // EDID_RAM
i2c1_h2d_write8(0x8CC1,0xA0); // EDID_RAM
i2c1_h2d_write8(0x8CC2,0xA0); // EDID_RAM
i2c1_h2d_write8(0x8CC3,0x40); // EDID_RAM
i2c1_h2d_write8(0x8CC4,0x2E); // EDID_RAM
i2c1_h2d_write8(0x8CC5,0x60); // EDID_RAM
i2c1_h2d_write8(0x8CC6,0x30); // EDID_RAM
i2c1_h2d_write8(0x8CC7,0x20); // EDID_RAM
i2c1_h2d_write8(0x8CC8,0x36); // EDID_RAM
i2c1_h2d_write8(0x8CC9,0x00); // EDID_RAM
i2c1_h2d_write8(0x8CCA,0x00); // EDID_RAM
i2c1_h2d_write8(0x8CCB,0x40); // EDID_RAM
i2c1_h2d_write8(0x8CCC,0xA6); // EDID_RAM
i2c1_h2d_write8(0x8CCD,0x00); // EDID_RAM
i2c1_h2d_write8(0x8CCE,0x00); // EDID_RAM
i2c1_h2d_write8(0x8CCF,0x18); // EDID_RAM
i2c1_h2d_write8(0x8CD0,0xEC); // EDID_RAM
i2c1_h2d_write8(0x8CD1,0x68); // EDID_RAM
i2c1_h2d_write8(0x8CD2,0x00); // EDID_RAM
i2c1_h2d_write8(0x8CD3,0xA0); // EDID_RAM
i2c1_h2d_write8(0x8CD4,0xA0); // EDID_RAM
i2c1_h2d_write8(0x8CD5,0x40); // EDID_RAM
i2c1_h2d_write8(0x8CD6,0x2E); // EDID_RAM
i2c1_h2d_write8(0x8CD7,0x60); // EDID_RAM
i2c1_h2d_write8(0x8CD8,0x30); // EDID_RAM
i2c1_h2d_write8(0x8CD9,0x20); // EDID_RAM
i2c1_h2d_write8(0x8CDA,0x36); // EDID_RAM
i2c1_h2d_write8(0x8CDB,0x00); // EDID_RAM
i2c1_h2d_write8(0x8CDC,0x00); // EDID_RAM
i2c1_h2d_write8(0x8CDD,0x40); // EDID_RAM
i2c1_h2d_write8(0x8CDE,0xA6); // EDID_RAM
i2c1_h2d_write8(0x8CDF,0x00); // EDID_RAM
i2c1_h2d_write8(0x8CE0,0x00); // EDID_RAM
i2c1_h2d_write8(0x8CE1,0x18); // EDID_RAM
i2c1_h2d_write8(0x8CE2,0x00); // EDID_RAM
i2c1_h2d_write8(0x8CE3,0x00); // EDID_RAM
i2c1_h2d_write8(0x8CE4,0x00); // EDID_RAM
i2c1_h2d_write8(0x8CE5,0x00); // EDID_RAM
i2c1_h2d_write8(0x8CE6,0x00); // EDID_RAM
i2c1_h2d_write8(0x8CE7,0x00); // EDID_RAM
i2c1_h2d_write8(0x8CE8,0x00); // EDID_RAM
i2c1_h2d_write8(0x8CE9,0x00); // EDID_RAM
i2c1_h2d_write8(0x8CEA,0x00); // EDID_RAM
i2c1_h2d_write8(0x8CEB,0x00); // EDID_RAM
i2c1_h2d_write8(0x8CEC,0x00); // EDID_RAM
i2c1_h2d_write8(0x8CED,0x00); // EDID_RAM
i2c1_h2d_write8(0x8CEE,0x00); // EDID_RAM
i2c1_h2d_write8(0x8CEF,0x00); // EDID_RAM
i2c1_h2d_write8(0x8CF0,0x00); // EDID_RAM
i2c1_h2d_write8(0x8CF1,0x00); // EDID_RAM
i2c1_h2d_write8(0x8CF2,0x00); // EDID_RAM
i2c1_h2d_write8(0x8CF3,0x00); // EDID_RAM
i2c1_h2d_write8(0x8CF4,0x00); // EDID_RAM
i2c1_h2d_write8(0x8CF5,0x00); // EDID_RAM
i2c1_h2d_write8(0x8CF6,0x00); // EDID_RAM
i2c1_h2d_write8(0x8CF7,0x00); // EDID_RAM
i2c1_h2d_write8(0x8CF8,0x00); // EDID_RAM
i2c1_h2d_write8(0x8CF9,0x00); // EDID_RAM
i2c1_h2d_write8(0x8CFA,0x00); // EDID_RAM
i2c1_h2d_write8(0x8CFB,0x00); // EDID_RAM
i2c1_h2d_write8(0x8CFC,0x00); // EDID_RAM
i2c1_h2d_write8(0x8CFD,0x00); // EDID_RAM
i2c1_h2d_write8(0x8CFE,0x00); // EDID_RAM
i2c1_h2d_write8(0x8CFF,0xBE); // EDID_RAM
// HDCP Setting
// Video Color Format Setting
i2c1_h2d_write8(0x8A02,0x42); // VOUT_SYNC0
// HDMI SYSTEM
i2c1_h2d_write8(0x8543,0x02); // DDC_CTL
i2c1_h2d_write8(0x8544,0x10); // HPD_CTL
// HDMI Audio Setting
i2c1_h2d_write8(0x8600,0x00); // AUD_Auto_Mute
i2c1_h2d_write8(0x8602,0xF3); // Auto_CMD0
i2c1_h2d_write8(0x8603,0x02); // Auto_CMD1
i2c1_h2d_write8(0x8604,0x0C); // Auto_CMD2
i2c1_h2d_write8(0x8606,0x05); // BUFINIT_START
i2c1_h2d_write8(0x8607,0x00); // FS_MUTE
i2c1_h2d_write8(0x8652,0x02); // SDO_MODE1
i2c1_h2d_write32(0x8671,0x020C49BA); // NCO_48F0A_D
i2c1_h2d_write32(0x8675,0x01E1B089); // NCO_44F0A_D
i2c1_h2d_write8(0x8680,0x00); // AUD_MODE
// Let HDMI Source start access
i2c1_h2d_write8(0x854A,0x01); // INIT_END
// Start Video TX
i2c1_h2d_write16(0x0004,0x0C37); // ConfCtl0
i2c1_h2d_write16(0x0006,0x0000); // ConfCtl1
// Command Transmission After Video Start.
i2c1_h2d_write32(0x0110,0x00000006); // MODE_CONFIG
i2c1_h2d_write32(0x0310,0x00000006); // MODE_CONFIG
Waitx1sec(0);
// MCAP
i2c1_h2d_write16(0x0504,0x0023); // DCSCMD_Q
i2c1_h2d_write16(0x0504,0x00B0); // DCSCMD_Q
Waitx1us();
// Interface Setting
i2c1_h2d_write16(0x0504,0x0023); // DCSCMD_Q
i2c1_h2d_write16(0x0504,0x14B3); // DCSCMD_Q
Waitx1us();
// MCAP
i2c1_h2d_write16(0x0504,0x0023); // DCSCMD_Q
i2c1_h2d_write16(0x0504,0x03B0); // DCSCMD_Q
Waitx1us();
// Set Display On
i2c1_h2d_write16(0x0504,0x0005); // DCSCMD_Q
i2c1_h2d_write16(0x0504,0x0029); // DCSCMD_Q
Waitx1us();
