eSpark-Consulting-Group/ajeet-singh-hdmi-to-fpc-adaptor/Design_Files/Deliverables/Renderings/2D_C_View.PNG

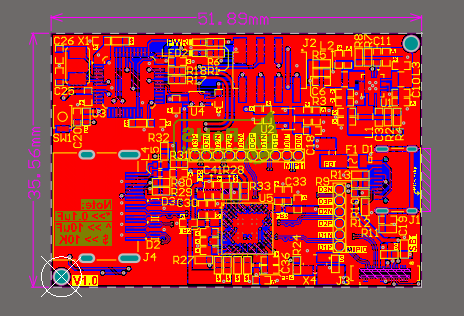
Design_Files/Deliverables/Renderings/2D_C_View.PNG
