eSpark-Consulting-Group/ajeet-singh-hdmi-to-fpc-adaptor/Design_Files/Deliverables/Renderings/2D_Top_Layer.PNG

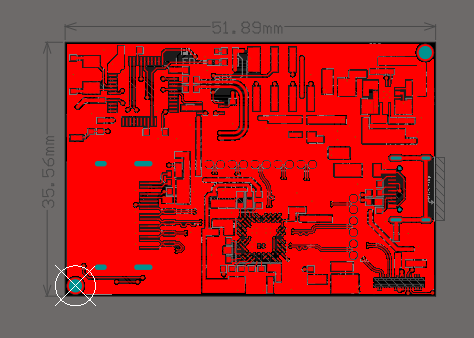
Design_Files/Deliverables/Renderings/2D_Top_Layer.PNG
