eSpark-Consulting-Group/ajeet-singh-hdmi-to-fpc-adaptor/Design_Files/Deliverables/Renderings/3D_Isometric_View.PNG

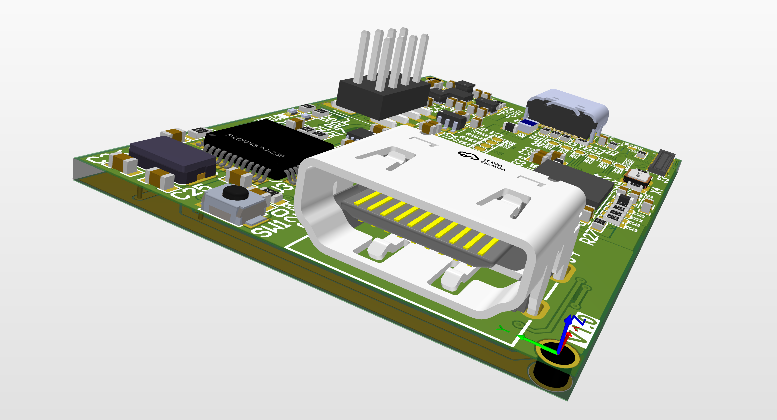
Design_Files/Deliverables/Renderings/3D_Isometric_View.PNG
