eSpark-Consulting-Group/ajeet-singh-hdmi-to-fpc-adaptor/Design_Files/Deliverables/BOM/Client_BOM.xlsx

# | Item Type | Designator | Description | Footprint | Manufacturer Part Number | Manufacturer | Alternate Part Number | LCSC Part Number | Quantity | Quantity (1 Boards) | MOQ (1 Boards) | Links | Unit Cost (1 Boards) | Total Cost (1 Boards) | Remarks | Reviewer Remarks
1 | Capacitor | C1, C2, C4, C7, C9, C12, C16, C17, C29, C32, C35, C43 | 10V 10uF X5R ±10% 0603 Multilayer Ceramic Capacitors MLCC - SMD/SMT ROHS | Cap-0603 | CGA0603X5R106K100JT | HRE | - | C6119842 | 12 | 12 | 100 | LCSC (https://www.lcsc.com/product-detail/Multilayer-Ceramic-Capacitors-MLCC-SMD-SMT_HRE-CGA0603X5R106K100JT_C6119842.html) | $0.0054 | $0.5400
2 | Capacitor | C3, C6, C11 | 50V 220pF X7R ±10% 0603 Multilayer Ceramic Capacitors MLCC - SMD/SMT ROHS | Cap-0603 | CS1608X7R221K500NRB | Samwha Capacitors | - | C5255295 | 3 | 3 | 100 | LCSC (https://www.lcsc.com/product-detail/Multilayer-Ceramic-Capacitors-MLCC-SMD-SMT_Samwha-Capacitor-CS1608X7R221K500NRB_C5255295.html) | $0.0020 | $0.2000
3 | Capacitor | C5, C8, C13, C14, C15, C21, C22, C23, C24, C27, C28, C31, C34, C37, C38, C39, C40, C42 | 25V 100nF X7R ±10% 0603 Multilayer Ceramic Capacitors MLCC - SMD/SMT ROHS | Cap-0603 | CL10B104KA8NNNC | Samsung Electro-Mechanics | - | C1590 | 18 | 18 | 100 | LCSC (https://www.lcsc.com/product-detail/Multilayer-Ceramic-Capacitors-MLCC-SMD-SMT_Samsung-Electro-Mechanics-CL10B104KA8NNNC_C1590.html) | $0.0030 | $0.3000
4 | Capacitor | C10, C20 | 16V 1uF X5R ±10% 0603 Multilayer Ceramic Capacitors MLCC - SMD/SMT ROHS | Cap-0603 | CL10A105KO8NNNC | Samsung Electro-Mechanics | - | C1592 | 2 | 2 | 100 | LCSC (https://www.lcsc.com/product-detail/Multilayer-Ceramic-Capacitors-MLCC-SMD-SMT_Samsung-Electro-Mechanics-CL10A105KO8NNNC_C1592.html) | $0.0032 | $0.3200
5 | Capacitor | C18 | 25V 22nF X7R 0603 Multilayer Ceramic Capacitors MLCC - SMD/SMT ROHS | Cap-0603 | FN18X223K250PSG | PSA | - | C2929161 | 1 | 1 | 100 | LCSC (https://www.lcsc.com/product-detail/Multilayer-Ceramic-Capacitors-MLCC-SMD-SMT_PSA-Prosperity-Dielectrics-FN18X223K250PSG_C2929161.html) | $0.0039 | $0.3900
6 | Capacitor | C19 | CAP CER 4700PF 50V C0G/NPO 0603 | Cap-0603 | CC0603JRNPO9BN472 | Yageo | - | C576818 | 1 | 1 | 20 | LCSC (https://www.lcsc.com/product-detail/Multilayer-Ceramic-Capacitors-MLCC-SMD-SMT_YAGEO-CC0603JRNPO9BN472_C576818.html) | $0.0198 | $0.3960
7 | Capacitor | C25, C26 | CAP CER 20PF 50V C0G/NPO 0603 | Cap-0603 | CC0603JRNPO9BN200 | Yageo | - | C105621 | 2 | 2 | 100 | LCSC (https://www.lcsc.com/product-detail/Multilayer-Ceramic-Capacitors-MLCC-SMD-SMT_YAGEO-CC0603JRNPO9BN200_C105621.html) | $0.0027 | $0.2700
8 | Capacitor | C30, C33, C36, C41 | 50V 10nF X7R ±10% 0603 Multilayer Ceramic Capacitors MLCC - SMD/SMT ROHS | Cap-0603 | FN18X103K500PSG | PSA | - | C525264 | 4 | 4 | 100 | LCSC (https://www.lcsc.com/product-detail/Multilayer-Ceramic-Capacitors-MLCC-SMD-SMT_PSA-Prosperity-Dielectrics-FN18X103K500PSG_C525264.html) | $0.0014 | $0.1400
9 | Diode | D1 | TVS DIODE 5VWM 6.3VC DSN0603-2 | DSN0603-2 | PESD5V0H1BSFYL | Nexperia | - | C477989 | 1 | 1 | 20 | LCSC (https://www.lcsc.com/product-detail/Electrostatic-and-Surge-Protection-TVS-ESD_Nexperia-PESD5V0H1BSF_C477989.html) | $0.0312 | $0.6240
10 | Diode | D2, D3 | DFN2510-10 Electrostatic and Surge Protection (TVS/ESD) ROHS | Custom | AZ1045-04F | TECH PUBLIC | - | C2987152 | 2 | 2 | 10 | LCSC (https://www.lcsc.com/product-detail/Electrostatic-and-Surge-Protection-TVS-ESD_TECH-PUBLIC-AZ1045-04F_C2987152.html) | $0.0511 | $0.5110
11 | Fuse | F1 | PTC RESET FUSE 6V 3A 1206 | Fuse 1206 (3216 Metric) | 1206L300SLTHYR | Littelfuse | - | C207041 | 1 | 1 | 5 | LCSC (https://www.lcsc.com/product-detail/Resettable-Fuses_Littelfuse-1206L300SLTHYR_C207041.html) | $0.2596 | $1.2980
12 | Ferrite Bead | FB1,FB2, FB3, FB4, FB5 | Ferrite Beads Multi-Layer 120Ohm 25% 100MHz 2A 50mOhm DCR 0603 Paper T/R | IND-0603 (1608 Metric) | BLM18PG121SN1D | Murata Electronics | - | C14709 | 5 | 5 | 100 | LCSC (https://www.lcsc.com/product-detail/Ferrite-Beads_Murata-Electronics-BLM18PG121SN1D_C14709.html) | $0.0066 | $0.6600
13 | USB Connector | J1 | 5A 1 16P Female Type-C SMD USB Connectors ROHS | Custom | TYPE-C-31-M-12 | Korean Hroparts Elec | - | C165948 | 1 | 1 | 5 | LCSC (https://www.lcsc.com/product-detail/USB-Connectors_Korean-Hroparts-Elec-TYPE-C-31-M-12_C165948.html) | $0.1630 | $0.8150
14 | Connector | J2 | 3A Brick nogging Square Pins 2.5mm 8P 6mm -55℃~+105℃ 2.54mm 双排 Black 2x4P 2.54mm SMD,P=2.54mm Pin Headers ROHS | Custom | 2.54-2*4P | BOOMELE(BOOM Precision Elec) | - | C192300 | 1 | 1 | 20 | LCSC (https://www.lcsc.com/product-detail/Pin-Headers_BOOMELE-Boom-Precision-Elec-2-54-2-4P_C192300.html) | $0.0365 | $0.7300
15 | Connector | J3 | 40 Position Straight Type Receptacle Signal Only Board to FPC Connector | Custom | BM23FR0.6-40DS-0.35V(895) | Hirose | - | - | 1 | 1 | 1 | Mouser (https://eu.mouser.com/ProductDetail/Hirose-Connector/BM23FR0.6-40DS-0.35V895?qs=YCa%2FAAYMW01B9fIk2CoAkA%3D%3D) | $1.5000 | $1.5000
16 | HDMI | J4 | 19P Female HDMI Surface Mount，Right Angle 1 500mA -45℃~+85℃ SMD D-Sub/DVI/HDMI Connectors ROHS | Custom | HD-A-05H9191N | HanElectricity | - | C18213861 | 1 | 1 | 5 | LCSC (https://www.lcsc.com/product-detail/D-Sub-DVI-HDMI-Connectors_HanElectricity-HD-A-05H9191N_C18213861.html) | $0.0779 | $0.3895
17 | Inductor | L1, L2, L3 | Inductor Power Chip Shielded Multi-Layer 1.5uH 20% 1MHz Ferrite 1.5A 0.088Ohm DCR 1008 T/R | IND-1008 (2520 Metric) | LQM2HPN1R5MG0L | Murata Electronics | - | C98034 | 3 | 3 | 5 | LCSC (https://www.lcsc.com/product-detail/Inductors-SMD_Murata-Electronics-LQM2HPN1R5MG0L_C98034.html) | $0.1029 | $0.5145
18 | Inductor | L4, L5 | 50mA 10uH ±20% 1.17Ω 0603 Inductors (SMD) ROHS | IND-0603 (1608 Metric) | MCL1608S100MT | SUNLORD | - | C51942 | 2 | 2 | 20 | LCSC (https://www.lcsc.com/product-detail/Inductors-SMD_Sunlord-MCL1608S100MT_C51942.html) | $0.017 | $0.3460
19 | LED | LED1, LED2 | Green 520~535nm 0402 Light Emitting Diodes (LED) RoHS | LED-0402 | 16-213/GHC-YR1S1/3T | Everlight Elec | - | C74338 | 2 | 2 | 10 | LCSC (https://www.lcsc.com/product-detail/Light-Emitting-Diodes-LED_Everlight-Elec-16-213-GHC-YR1S1-3T_C74338.html) | $0.0554 | $0.5540
20 | Resistor | R1, R6, R24, R31, R32, R33 | RES SMD 1K OHM 1% 1/10W 0603 | Res-0603 | RC0603FR-071KL | Yageo | - | C22548 | 6 | 6 | 100 | LCSC (https://www.lcsc.com/product-detail/Chip-Resistor-Surface-Mount_YAGEO-RC0603FR-071KL_C22548.html) | $0.0010 | $0.1000 | R31 is DNP
21 | Resistor | R2 | 100mW Thick Film Resistors 75V ±100ppm/℃ ±1% 200kΩ 0603 Chip Resistor - Surface Mount ROHS | Res-0603 | 0603WAF2003T5E | UNI-ROYAL(Uniroyal Elec) | - | C25811 | 1 | 1 | 100 | LCSC (https://www.lcsc.com/product-detail/Chip-Resistor-Surface-Mount_UNI-ROYAL-Uniroyal-Elec-0603WAF2003T5E_C25811.html) | $0.0010 | $0.1000
22 | Resistor | R3 | 100mW Thick Film Resistors 75V ±100ppm/℃ ±1% 68kΩ 0603 Chip Resistor - Surface Mount ROHS | Res-0603 | 0603WAF6802T5E | UNI-ROYAL(Uniroyal Elec) | - | C23231 | 1 | 1 | 100 | LCSC (https://www.lcsc.com/product-detail/Chip-Resistor-Surface-Mount_UNI-ROYAL-Uniroyal-Elec-0603WAF6802T5E_C23231.html) | $0.0010 | $0.1000
23 | Resistor | R4, R8 | 100mW Thick Film Resistors 75V ±100ppm/℃ ±1% 100kΩ 0603 Chip Resistor - Surface Mount ROHS | Res-0603 | 0603WAF1003T5E | UNI-ROYAL | - | C25803 | 2 | 2 | 100 | LCSC (https://www.lcsc.com/product-detail/Chip-Resistor-Surface-Mount_UNI-ROYAL-Uniroyal-Elec-0603WAF1003T5E_C25803.html) | $0.0010 | $0.1000
24 | Resistor | R5 | 100mW Thick Film Resistors 75V ±100ppm/℃ ±1% 15kΩ 0603 Chip Resistor - Surface Mount ROHS | Res-0603 | FRC0603F1502TS | FOJAN | - | C2906995 | 1 | 1 | 100 | LCSC (https://www.lcsc.com/product-detail/Chip-Resistor-Surface-Mount_FOJAN-FRC0603F1502TS_C2906995.html) | $0.0010 | $0.1000
25 | Resistor | R7 | 100mW Thick Film Resistors 75V ±100ppm/℃ ±1% 120kΩ 0603 Chip Resistor - Surface Mount ROHS | Res-0603 | 0603WAF1203T5E | UNI-ROYAL(Uniroyal Elec) | - | C25808 | 1 | 1 | 100 | LCSC (https://www.lcsc.com/product-detail/Chip-Resistor-Surface-Mount_UNI-ROYAL-Uniroyal-Elec-0603WAF1203T5E_C25808.html) | $0.0010 | $0.1000
26 | Resistor | R9, R10 | RES 0 OHM JUMPER 1/10W 0603 | Res-0603 | RC0603JR-070RL | Yageo | - | C95177 | 2 | 2 | 100 | LCSC (https://www.lcsc.com/product-detail/Chip-Resistor-Surface-Mount_YAGEO-RC0603JR-070RL_C95177.html) | $0.0011 | $0.1100
27 | Resistor | R11 | 100mW Thick Film Resistors ±100ppm/℃ ±1% 1MΩ 0603 Chip Resistor - Surface Mount ROHS | Res-0603 | 0603WAF1004T5E | UNI-ROYAL(Uniroyal Elec) | - | C22935 | 1 | 1 | 100 | LCSC (https://www.lcsc.com/product-detail/Chip-Resistor-Surface-Mount_UNI-ROYAL-Uniroyal-Elec-0603WAF1004T5E_C22935.html) | $0.0011 | $0.1100
28 | Resistor | R12, R13 | 100mW Thick Film Resistors 75V ±100ppm/℃ ±1% 5.1kΩ 0603 Chip Resistor - Surface Mount ROHS | Res-0603 | 0603WAF5101T5E | UNI-ROYAL | - | C23186 | 2 | 2 | 100 | LCSC (https://www.lcsc.com/product-detail/Chip-Resistor-Surface-Mount_UNI-ROYAL-Uniroyal-Elec-0603WAF5101T5E_C23186.html) | $0.0010 | $0.1000
29 | Resistor | R14, R15, R16, R21, R22, R23, R25, R26, R34, R35 | RES SMD 10K Ohm 1% 1/10W 0603, 100mW Thick Film Resistors 75V ±100ppm/℃ ±1% 10kΩ 0603 Chip Resistor - Surface Mount ROHS | Res-0603 | 0603WAF1002T5E | UNI-ROYAL(Uniroyal Elec) | - | C25804 | 10 | 10 | 100 | LCSC (https://www.lcsc.com/product-detail/Chip-Resistor-Surface-Mount_UNI-ROYAL-Uniroyal-Elec-0603WAF1002T5E_C25804.html) | $0.0010 | $0.1000 | R35 is DNP
30 | Resistor | R17, R18 | 100mW Thick Film Resistors 75V ±100ppm/℃ ±1% 22Ω 0603 Chip Resistor - Surface Mount ROHS | Res-0603 | 0603WAF220JT5E | UNI-ROYAL(Uniroyal Elec) | - | C23345 | 2 | 2 | 100 | LCSC (https://www.lcsc.com/product-detail/Chip-Resistor-Surface-Mount_UNI-ROYAL-Uniroyal-Elec-0603WAF220JT5E_C23345.html) | $0.0010 | $0.1000
31 |  | R27, R29, R30 | RES 47K OHM 5% 1/10W 0603 | Res-0603 | RC0603JR-0747KL | Yageo | - | C127447 | 3 | 3 | 100 | LCSC (https://www.lcsc.com/product-detail/Chip-Resistor-Surface-Mount_YAGEO-RC0603JR-0747KL_C127447.html) | $0.0011 | $0.1100
32 | Resistor | R28 | RES SMD 2K OHM 0.1% 1/10W 0603 | Res-0603 | RT0603BRE072KL | Yageo | - | C136954 | 1 | 1 | 20 | LCSC (https://www.lcsc.com/product-detail/Chip-Resistor-Surface-Mount_YAGEO-RT0603BRE072KL_C136954.html) | $0.0270 | $0.5400
33 | Switch | SW1 | SWITCH TACTILE SPST-NO 0.05A 12V | Custom | B3U-1000P | Omron | - | C231329 | 1 | 1 | 5 | LCSC (https://www.lcsc.com/product-detail/Tactile-Switches_Omron-Electronics-B3U-1000P_C231329.html) | $0.1477 | $0.7385
34 | IC | U1 | 2.7V~5.5V 3 WQFN-20-EP(3x3) Battery Management ICs ROHS | 20-QFN(3x3) | EA3036CQBR | Everanalog IC Design | - | C570857 | 1 | 1 | 5 | LCSC (https://www.lcsc.com/product-detail/Battery-Management-ICs_Everanalog-IC-design-EA3036CQBR_C570857.html) | $0.2521 | $1.2605
35 | IC | U2 | IC REG LDO 2.8V 0.3A SOT23-5 | SOT-23-5 | RT9193-28GB | Richtek | - | C56731 | 1 | 1 | 5 | LCSC (https://www.lcsc.com/product-detail/Linear-Voltage-Regulators-LDO_Richtek-Tech-RT9193-28GB_C56731.html) | $0.1502 | $0.7510
36 | IC | U3 | IC MCU 32BIT 128KB FLASH 48LQFP | 48-LQFP (7x7)_ | STM32F103CBT6 | STMicroelectronics | - | C8304 | 1 | 1 | 1 | LCSC (https://www.lcsc.com/product-detail/Microcontroller-Units-MCUs-MPUs-SOCs_STMicroelectronics-STM32F103CBT6_C8304.html) | $1.7087 | $1.7087
37 |  | U4 | IC TRANSLTR BIDIRECTIONAL 8VSSOP | VSSOP-8(3.1x2.1) | TXB0102DCUR | Texas Instruments | - | C60709 | 1 | 1 | 1 | LCSC (https://www.lcsc.com/product-detail/Translators-Level-Shifters_Texas-Instruments-TXB0102DCUR_C60709.html) | $0.5139 | $0.5139
38 | IC | U5 | Ultra HD to Display Serial Interface Converter 80-Pin VFBGA | TC358870XBG | TC358870XBG(NOK) | Toshiba | - | C3008712 | 1 | 1 | 1 | Mouser (https://eu.mouser.com/ProductDetail/Toshiba/TC358870XBGNOK?qs=xZ%2FP%252Ba9zWqb4j%2Fvr1IaN%252BQ%3D%3D) | $10.5500 | $10.5500
39 | Crystal | X1 | 8MHz 20pF ±10ppm ±50ppm SMD5032-2P Crystals ROHS | SMD5032-2P | X50328MSB2GI | Yangxing Tech | - | C115962 | 1 | 1 | 5 | LCSC (https://www.lcsc.com/product-detail/Crystals_YXC-X50328MSB2GI_C115962.html) | $0.1800 | $0.9000
40 | Crystal | X4 | 3.3V 5mA ±25ppm 40MHz CMOS SMD3225-4P Oscillators ROHS | SMD3225-4P | O3240000153350 | JGHC | - | C437132 | 1 | 1 | 1 | LCSC (https://www.lcsc.com/product-detail/Oscillators_JGHC-O3240000153350_C437132.html) | $0.3548 | $0.3548
 |  |  |  |  |  |  |  |  |  |  | Total Component Cost |  |  | $29.05
 |  |  |  |  |  |  |  |  |  |  | Single Board Cost |  |  | $29.05
