eSpark-Consulting-Group/ajeet-singh-hdmi-to-fpc-adaptor/Design_Files/Deliverables/Supporting Files/PCB_HDMI_To_FPC-v1.0.step

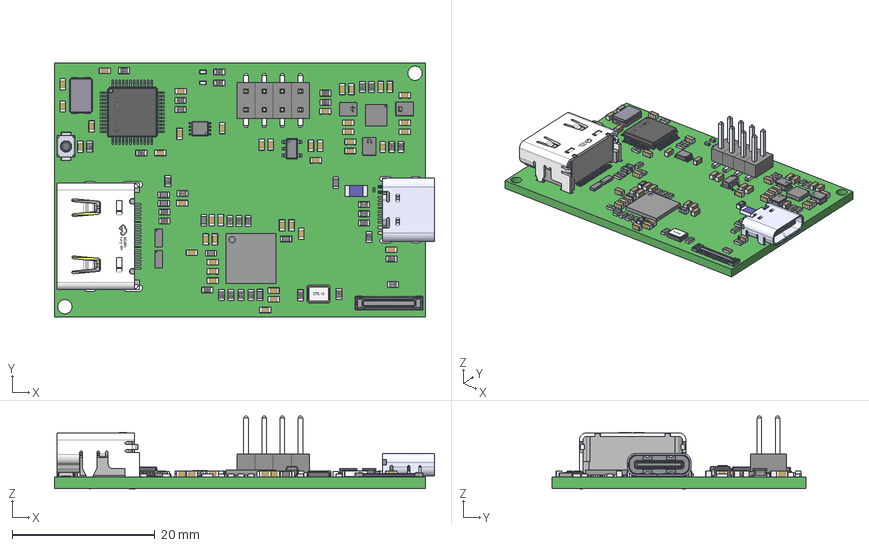
[picture p12: CAD file, 2024-03-21]
Design_Files/Deliverables/Supporting Files/PCB_HDMI_To_FPC-v1.0.step
53.2 x 35.6 x 10.1 mm
BM23P0_6-40DS-0_35V
User Library-RESC1608X05N x 33
COMPOUND.step
C192300 (1)
User Library-User Library-Siward_SX3225
TPD4E05U06DQAR--3DModel-STEP-56544 x 2
User Library-LED-0402 x 2
User Library-CAPC1608X09 x 43
A1
A2
A3
A4
A5
A6
A7
A8
A9
A10
B1
B2
B3
B4
B5
B6
B7
B8
B9
B10
C1
C2
C9
C10
D1
D2
D4
D5
D6
D7
D9
D10
E1
E2
E4
E5
E6
E7
E9
E10
F1
F2
F4
F5
F6
F7
F9
F10
G1
G2
G4
G5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
