eSpark-Consulting-Group/ajeet-singh-hdmi-to-fpc-adaptor/(list of files, cad)

Other CAD files:
Design_Files/Deliverables/Supporting Files/PCB_HDMI_To_FPC-v1.0.DWG
Design_Files/Deliverables/Supporting Files/PCB_HDMI_To_FPC-v1.0.DXF
