eSpark-Consulting-Group/ajeet-singh-hdmi-to-fpc-adaptor/Design_Files/Deliverables/Schematics/HDMI_To_FPCadaptor_V1.0.pdf

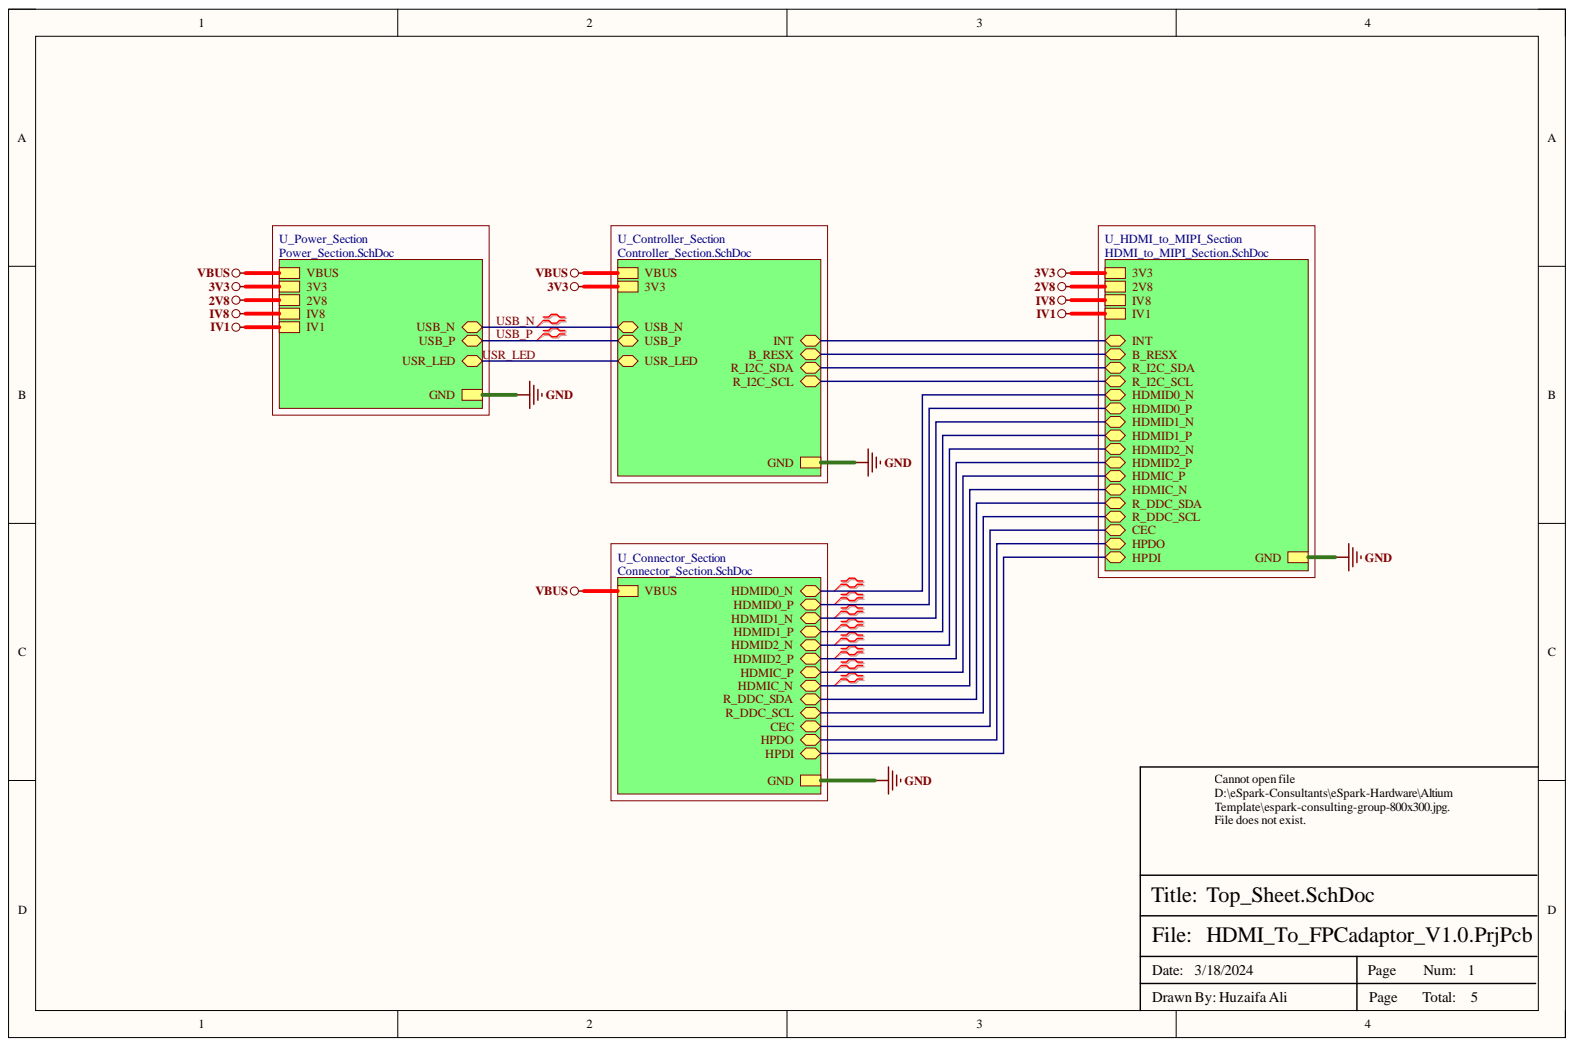
[picture p13: page 1]

Cannot open file
D:\eSpark-Consultants\eSpark-Hardware\Altium
Template\espark-consulting-group-800x300.jpg.
File does not exist.

Date: 3/18/2024 | Page Num: 1

Drawn By: Huzaifa Ali | Page Total: 5

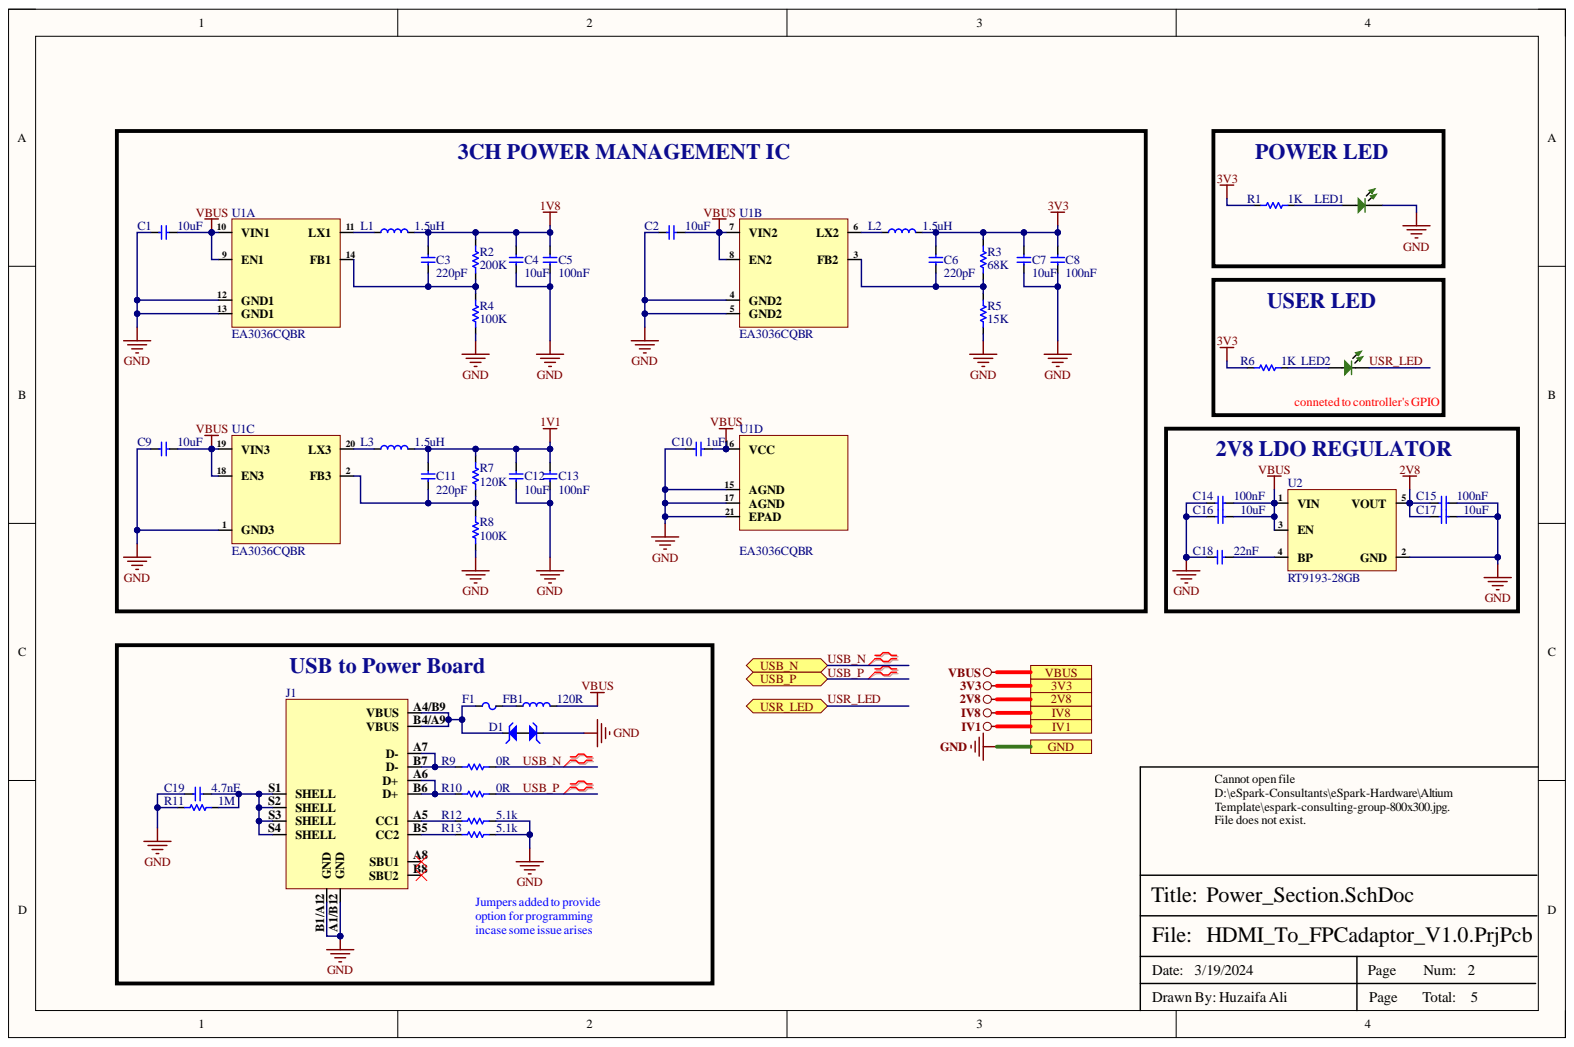
[picture p14: page 2]

conneted to controller's GPIO

USB to Power Board

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

Jumpers added to provide
option for programming
incase some issue arises

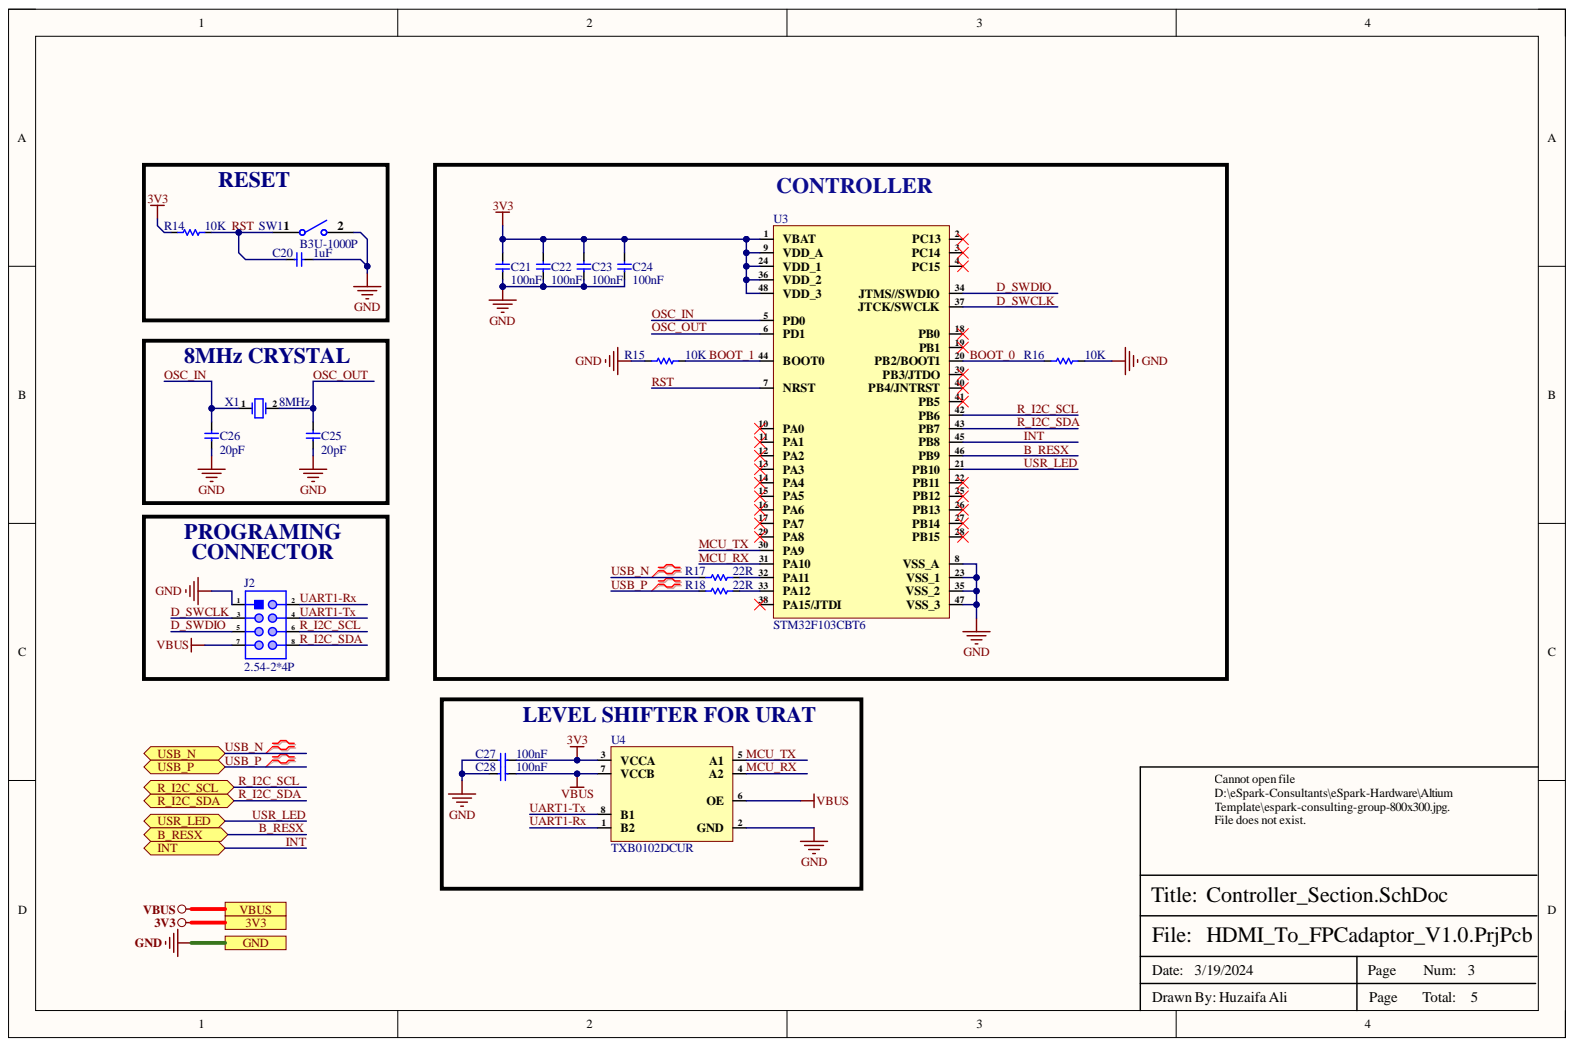
[picture p15: page 3]

LEVEL SHIFTER FOR URAT

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

Date: 3/19/2024 | Page Num: 3

Drawn By: Huzaifa Ali | Page Total: 5

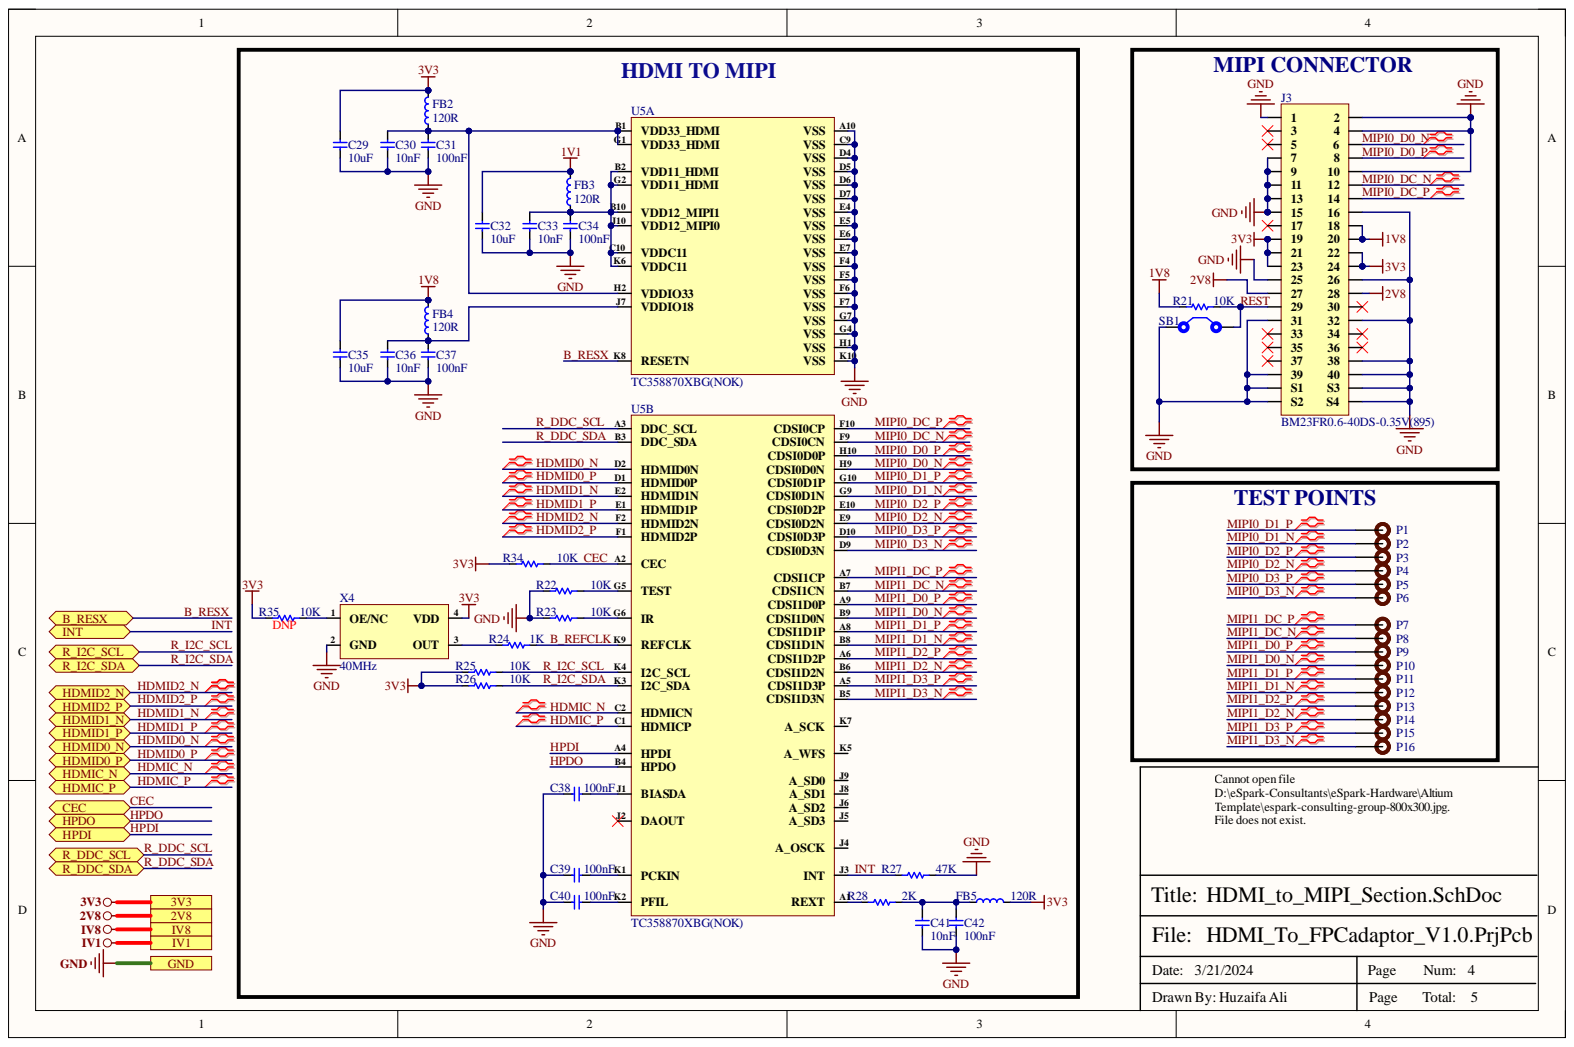
[picture p16: page 4]

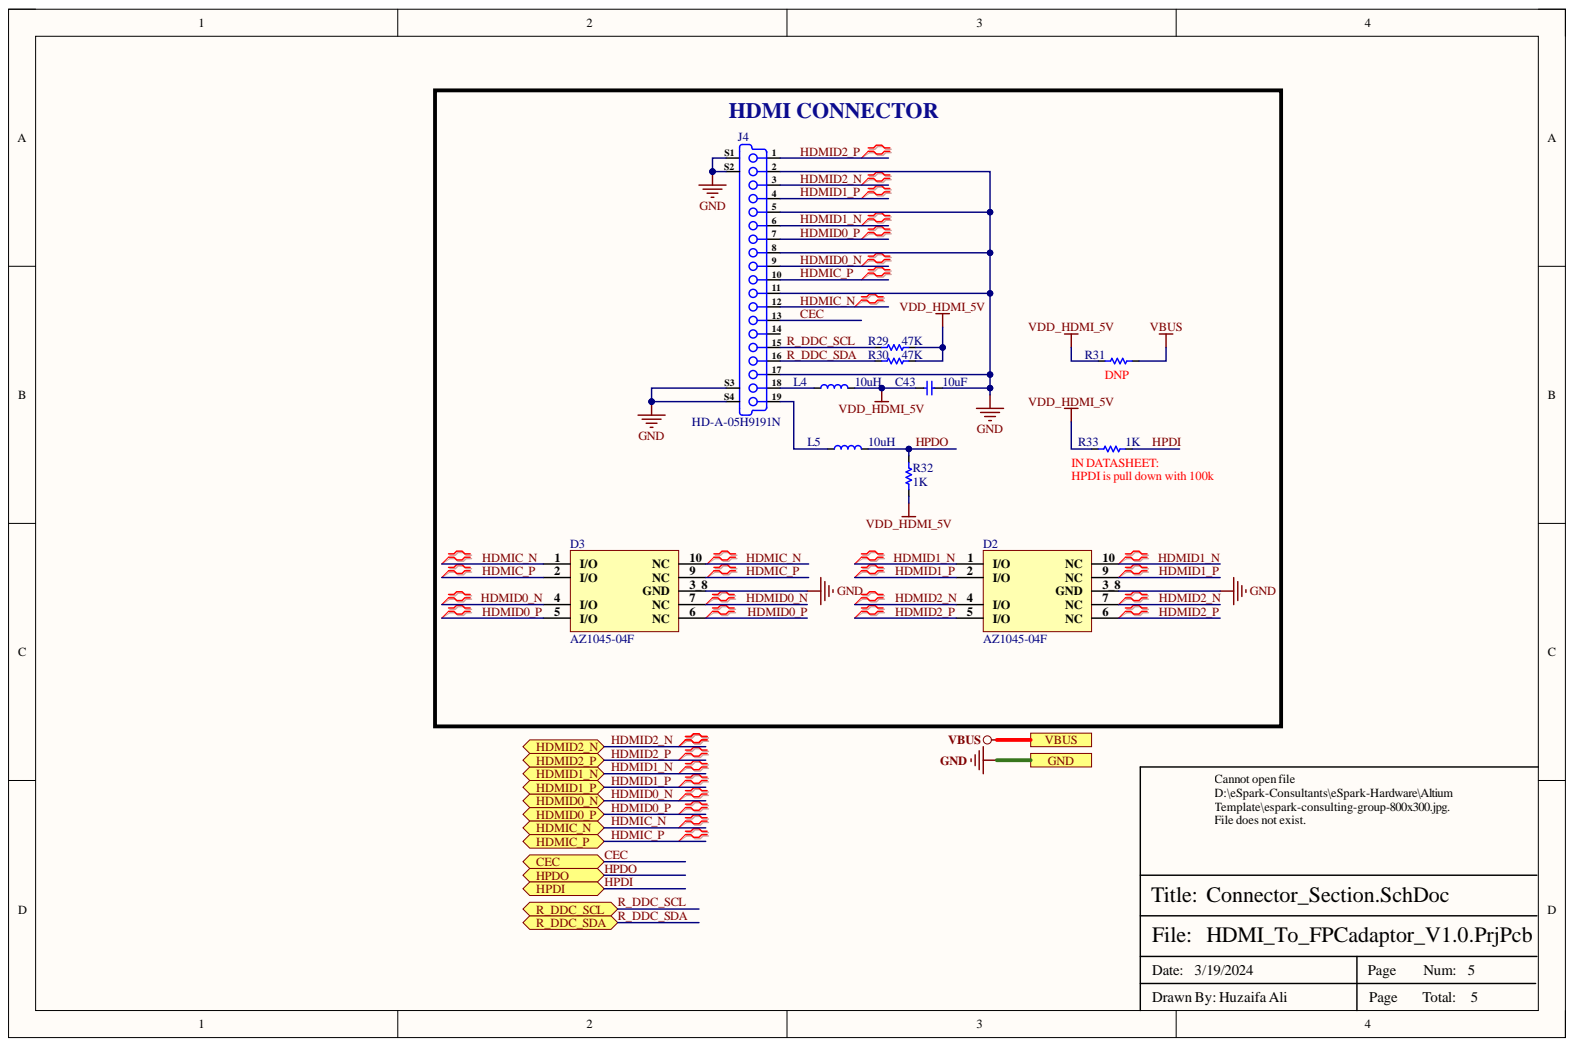
[picture p17: page 5]

HDMI CONNECTOR

IN DATASHEET:
HPDI is pull down with 100k

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

Date: 3/19/2024 | Page Num: 5

Drawn By: Huzaifa Ali | Page Total: 5

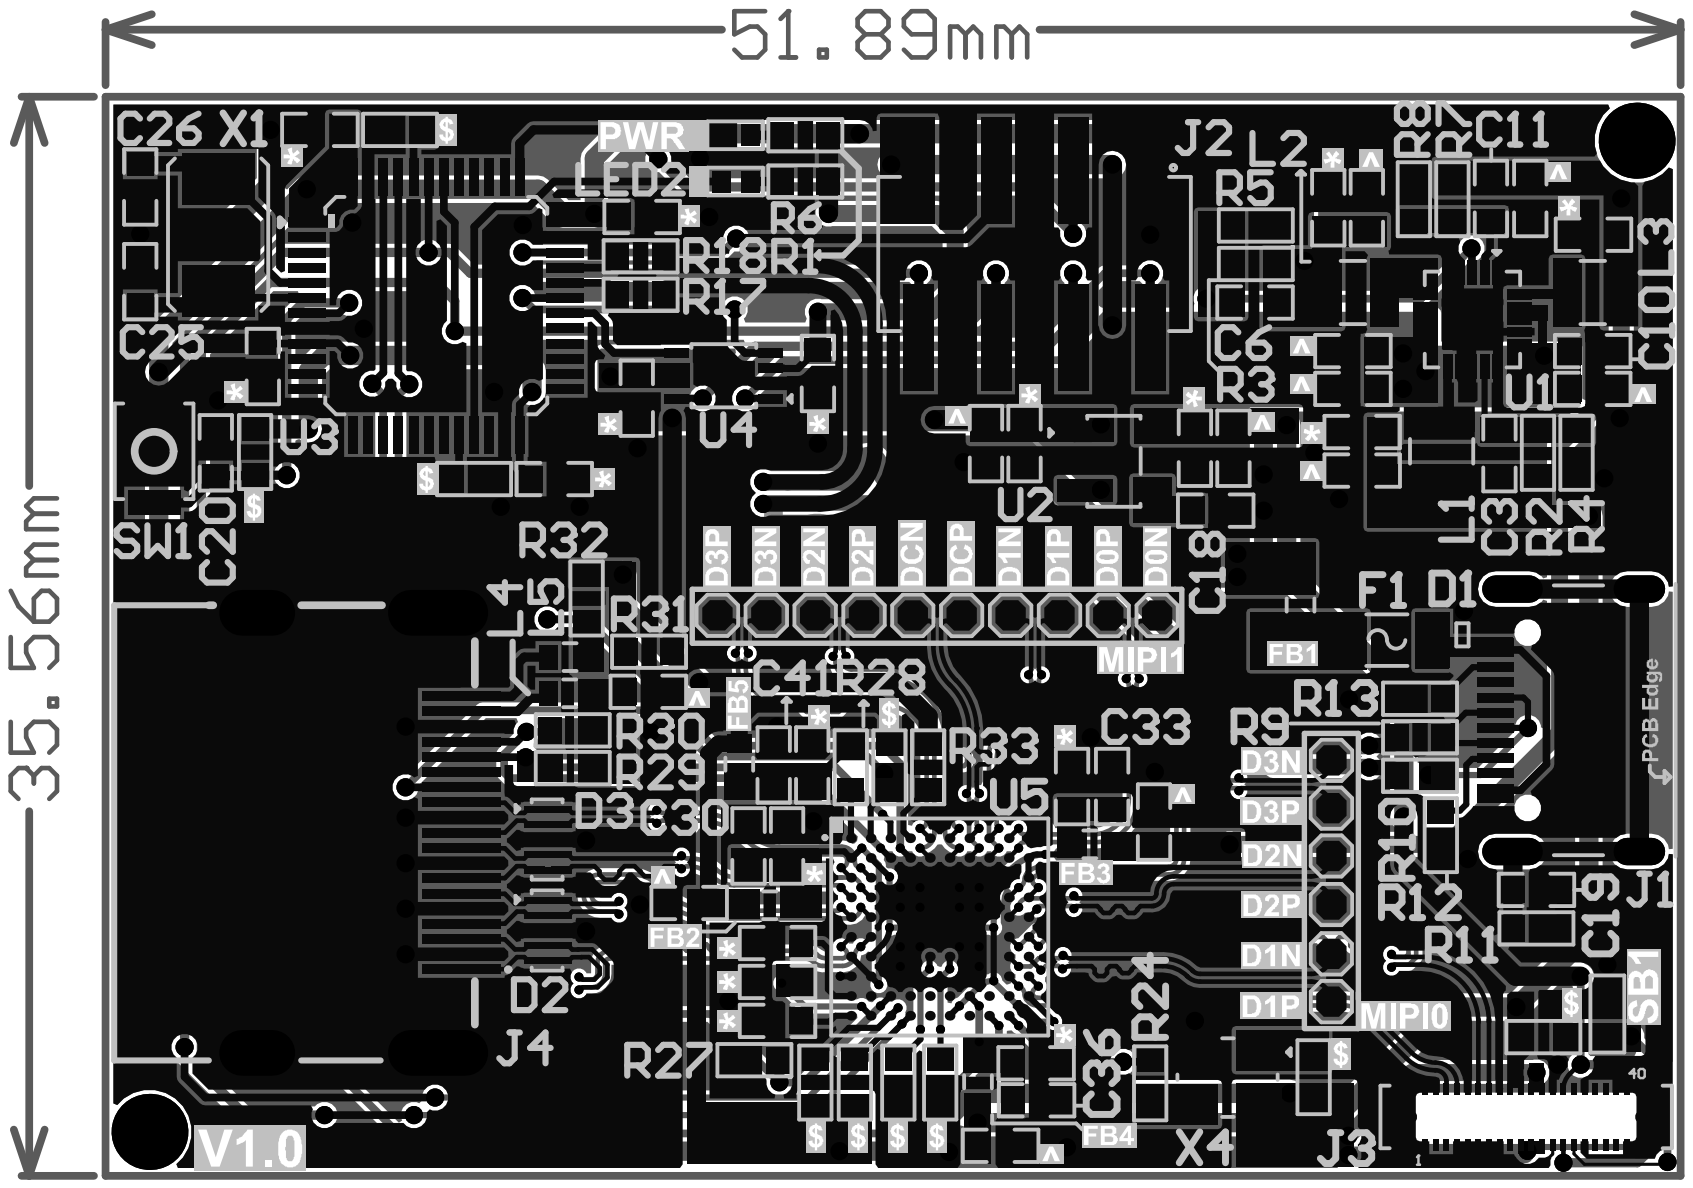
[picture p18: page 6]
