eSpark-Consulting-Group/ajeet-singh-hdmi-to-fpc-adaptor/Docs/tc358870xbg-Secondary-Reference.pdf

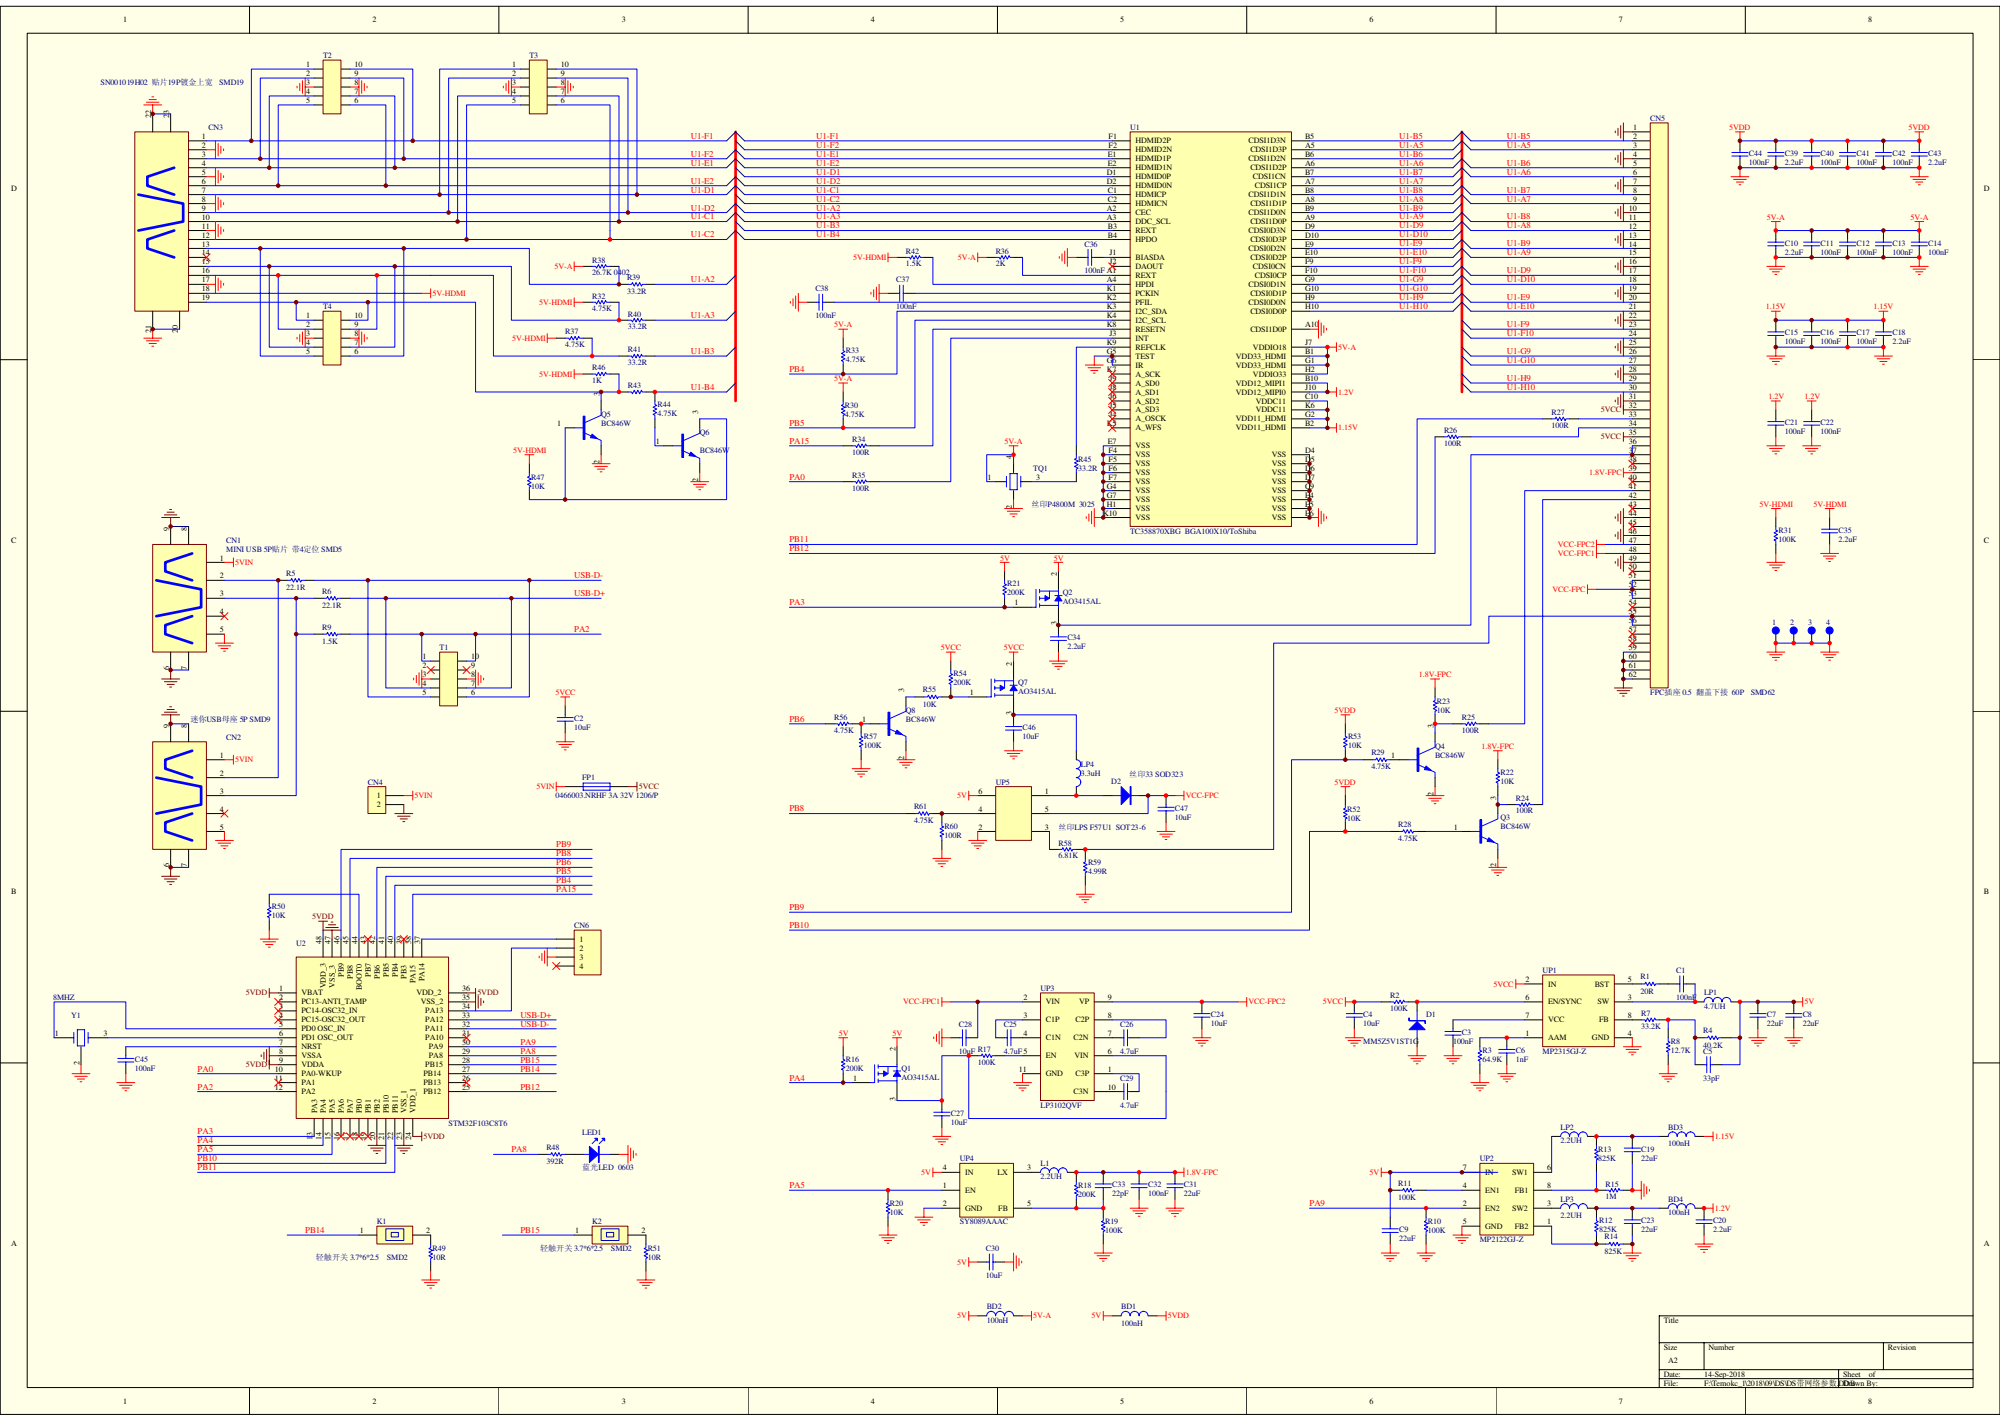
[picture p19: page 1]

VSS F6 | D6
VSS F7 | D7

Size A2 | Number | Revision

Date: 14-Sep-2018 | Sheet of
File: F:\Temokc_1\2018\09\DS\DS带网络参数.DDB Drawn By:
