eSpark-Consulting-Group/ajeet-singh-hdmi-to-fpc-adaptor/(list of files, drawings)

Other design files:
Design_Files/Connector_Section.SchDoc
Design_Files/Controller_Section.SchDoc
Design_Files/HDMI_To_Faceadaptor.PrjPcb
Design_Files/HDMI_To_FPCadaptor_V1.0.PrjPcb
Design_Files/HDMI_to_MIPI_Section.SchDoc
Design_Files/PCB_HDMI_To_FPC-v1.0.PcbDoc
Design_Files/Power_Section.SchDoc
Design_Files/Top_Sheet.SchDoc
docs/Design Files(reference)/HDMI-to-MIPI/Connector.SchDoc
docs/Design Files(reference)/HDMI-to-MIPI/HDMI_To_MIPI_PHY.SchDoc
docs/Design Files(reference)/HDMI-to-MIPI/Main.SchDoc
docs/Design Files(reference)/HDMI-to-MIPI/MiniDisplay.PcbDoc
docs/Design Files(reference)/HDMI-to-MIPI/MiniDisplay.PrjPCB
Docs/HDMI-PI-main(Ref Design)/1.Hardware/LT6911/Converter-10.1/Converter.PcbDoc
Docs/HDMI-PI-main(Ref Design)/1.Hardware/LT6911/Converter-10.1/Converter.PrjPCB
Docs/HDMI-PI-main(Ref Design)/1.Hardware/LT6911/Converter-10.1/Main.SchDoc
Docs/HDMI-PI-main(Ref Design)/1.Hardware/LT6911/MiniDisplay/Audio.SchDoc
Docs/HDMI-PI-main(Ref Design)/1.Hardware/TC358870XBG/Converter-10.1/Converter.PcbDoc
Docs/HDMI-PI-main(Ref Design)/1.Hardware/TC358870XBG/Converter-10.1/Converter.PrjPCB
Docs/HDMI-PI-main(Ref Design)/1.Hardware/TC358870XBG/Converter-10.1/Main.SchDoc
Docs/HDMI-PI-main(Ref Design)/1.Hardware/TC358870XBG/Converter_5_5/0.PcbDoc
Docs/HDMI-PI-main(Ref Design)/1.Hardware/TC358870XBG/Converter_5_5/0.SchDoc
Docs/HDMI-PI-main(Ref Design)/1.Hardware/TC358870XBG/MiniDisplay-ylj2000/Connector.SchDoc
Docs/HDMI-PI-main(Ref Design)/1.Hardware/TC358870XBG/MiniDisplay-ylj2000/HDMI_To_MIPI_PHY.SchDoc
Docs/HDMI-PI-main(Ref Design)/1.Hardware/TC358870XBG/MiniDisplay-ylj2000/Main.SchDoc
Docs/HDMI-PI-main(Ref Design)/1.Hardware/TC358870XBG/MiniDisplay-ylj2000/MiniDisplay.PcbDoc
Docs/HDMI-PI-main(Ref Design)/1.Hardware/TC358870XBG/MiniDisplay-ylj2000/MiniDisplay.PrjPCB
Docs/HDMI-PI-main(Ref Design)/1.Hardware/TC358870XBG/MiniDisplay/Main.SchDoc
