eSpark-Consulting-Group/ajeet-singh-hdmi-to-fpc-adaptor/(commit log)

2024-03-04 Reference Design Files
    [0.PcbDoc, 0.SchDoc, Audio.SchDoc, Connector.SchDoc, Converter.PcbDoc, Converter.PrjPCB, HDMI_To_MIPI_PHY.SchDoc, Main.SchDoc]
2024-03-04 Design Files
    [Connector.SchDoc, HDMI_To_MIPI_PHY.SchDoc, Main.SchDoc, MiniDisplay.PcbDoc, MiniDisplay.PrjPCB]
2024-03-05 #1 Power and Controller section completed
    [Connector.SchDoc, Controller_Section.SchDoc, HDMI_To_Faceadaptor.PrjPcb, HDMI_To_MIPI_PHY.SchDoc, Main.SchDoc, MiniDisplay.PcbDoc, MiniDisplay.PrjPCB, Power_Section.SchDoc]
2024-03-06 #1 hdmi and connector section in Progress
    [Connector.SchDoc, Connector_Section.SchDoc, Controller_Section.SchDoc, HDMI_To_Faceadaptor.PrjPcb, HDMI_To_MIPI_PHY.SchDoc, HDMI_to_MIPI_Section.SchDoc, Power_Section.SchDoc]
2024-03-07 2 errors remaining and footprint
    [Connector.SchDoc, Connector_Section.SchDoc, Controller_Section.SchDoc, HDMI_To_Faceadaptor.PrjPcb, HDMI_to_MIPI_Section.SchDoc, Power_Section.SchDoc, Top_Sheet.SchDoc]
2024-03-07 Errors removed, footprints and PDF added
    [Connector_Section.SchDoc, Controller_Section.SchDoc, HDMI_To_Faceadaptor.PrjPcb, HDMI_to_MIPI_Section.SchDoc]
2024-03-07 crystal change due to less stock pdf updated
    [Controller_Section.SchDoc, Power_Section.SchDoc]
2024-03-07 .gitignore added; folder location corrected
    [Connector.SchDoc, HDMI_To_MIPI_PHY.SchDoc, Main.SchDoc, MiniDisplay.PcbDoc, MiniDisplay.PrjPCB]
2024-03-07 #3 Part Placement in Progress
    [Connector_Section.SchDoc, Controller_Section.SchDoc, HDMI_To_Faceadaptor.PrjPcb, HDMI_To_MIPI.PcbDoc, Power_Section.SchDoc]
2024-03-08 #3 Test point placement and Formatting remaining
    [Connector_Section.SchDoc, Controller_Section.SchDoc, HDMI_To_FPCadaptor_V1.0.PrjPcb, HDMI_To_MIPI.PcbDoc, HDMI_to_MIPI_Section.SchDoc, Power_Section.SchDoc]
2024-03-09 #3 Placement Done: Routing In-progress.
    [Connector_Section.SchDoc, HDMI_To_FPCadaptor_V1.0.PrjPcb, HDMI_To_MIPI.PcbDoc, HDMI_to_MIPI_Section.SchDoc]
2024-03-10 #3 Test-point size reduced: Fresh PDF Generated.
    [HDMI_To_FPCadaptor_V1.0.PrjPcb, HDMI_To_MIPI.PcbDoc, PCB_HDMI_To_FPC.PcbDoc]
2024-03-11 #2 Changes updated acc to sch: review and #3 Routing in Progress
    [Connector_Section.SchDoc, Controller_Section.SchDoc, HDMI_To_FPCadaptor_V1.0.PrjPcb, HDMI_to_MIPI_Section.SchDoc, PCB_HDMI_To_FPC.PcbDoc, Top_Sheet.SchDoc]
2024-03-12 #3 Routing in Progress
    [Connector_Section.SchDoc, HDMI_To_FPCadaptor_V1.0.PrjPcb, HDMI_to_MIPI_Section.SchDoc, PCB_HDMI_To_FPC.PcbDoc]
2024-03-14 #3 Routing completed DRC errors remaining
    [HDMI_To_FPCadaptor_V1.0.PrjPcb, PCB_HDMI_To_FPC.PcbDoc]
2024-03-15 #3 Errors removed PCB completed
    [PCB_HDMI_To_FPC.PcbDoc]
2024-03-15 #4 In-progress.
    [HDMI_To_FPCadaptor_V1.0.PrjPcb, PCB_HDMI_To_FPC.PcbDoc]
2024-03-16 #4 Done: Client BOM and Deliverables created.
    [Centroid_File-PCB_HDMI_To_FPC-v1.0.csv, Client_BOM.xlsx, Connector_Section.SchDoc, Controller_Section.SchDoc, HDMI_To_FPCadaptor_V1.0.PrjPcb, HDMI_to_MIPI_Section.SchDoc, PCB_HDMI_To_FPC-v1.0.DWG, PCB_HDMI_To_FPC-v1.0.DXF]
2024-03-19 Client Bom added
    [Client_BOM.xlsx]
2024-03-19 BOM added some changes done in PCB mention in #5
    [Centroid_File-PCB_HDMI_To_FPC-v1.0.csv, Centroid_File.csv, Client_BOM.xlsx, Connector_Section.SchDoc, Controller_Section.SchDoc, HDMI_To_FPCadaptor_V1.0.PrjPcb, PCB_HDMI_To_FPC-v1.0.DWG, PCB_HDMI_To_FPC-v1.0.DXF]
2024-03-21 Connector updated in PCB and Routing done accordingly, Fresh Deliverables generated
    [Centroid_File.csv, Controller_Section.SchDoc, HDMI_To_FPCadaptor_V1.0.PrjPcb, HDMI_to_MIPI_Section.SchDoc, PCB_HDMI_To_FPC-v1.0.DWG, PCB_HDMI_To_FPC-v1.0.DXF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]
